CarloRenan/CM5-RP2040-MZM/README.md

# Controlador de polarização MZM com CM5 e RP2040

**Projeto 3**

Placa-base com Raspberry Pi Compute Module 5 e Raspberry Pi Pico para aquisição do sinal de um fotodiodo, geração de três tensões de polarização e supervisão de um modulador Mach–Zehnder (MZM).

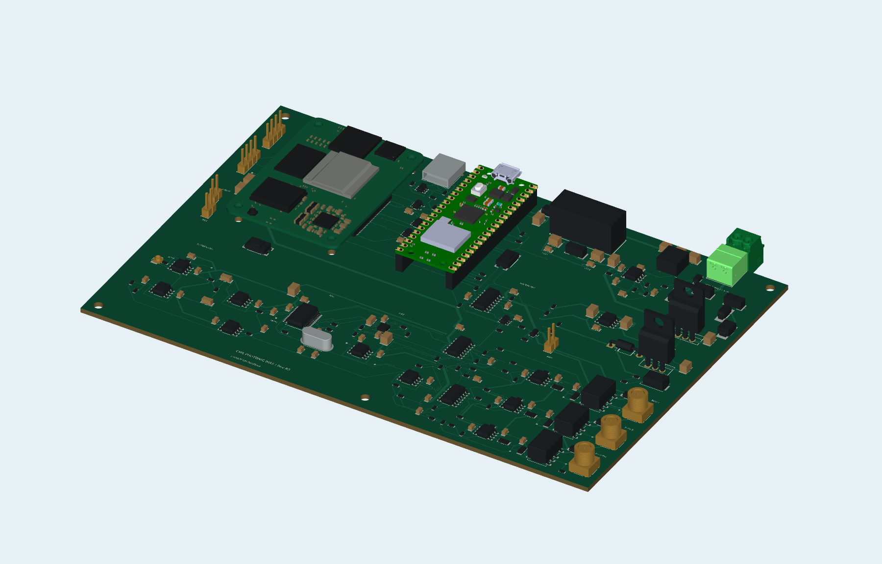
[picture p1: docs/imagens/montagem_3d.png]
Montagem tridimensional da placa CM5 e RP2040


## Documentação

| Documento | Referência para |
| --- | --- |
| [Relatório principal](docs/relatorios/Relatorio_CM5_RP2040_MZM.docx) | Arquitetura, circuitos, cálculos e configurações do sistema |
| [Conexões em 3D](docs/relatorios/Relatorio_Conexoes_3D%20.docx) | Pinagem, acessórios e exemplos de ligação |
| [Ensaios de bancada](docs/relatorios/Ensaios_de_Bancada_CM5_Photonic_Bias.docx) | Procedimentos de teste e verificações do protótipo |
| [Relatório LTspice](docs/relatorios/Relatorio_LTspice_CM5_RP2040_MZM.docx) | Simulações, gráficos e análise dos resultados |
| [Lista de compras](docs/relatorios/Lista_Compras_Prototipo_CM5_RP2040%20.xlsx) | Componentes e acessórios |
| [Vídeo da montagem e da bancada](media/CM5_R6_Trailer_Bancada.mp4) | Visualização do conjunto com MZM |

## Arquivos do projeto

- [Hardware](hardware/altium): projeto Altium, esquemáticos, PCB, biblioteca, BOM e modelos 3D.
- [Simulações](simulacoes): circuitos LTspice, modelos e roteiro dos ensaios.
- [Imagens](docs/imagens): vistas da placa, da montagem e da bancada.

O histórico das revisões está em [CHANGELOG.md](CHANGELOG.md). As fontes e condições dos recursos de terceiros estão em [THIRD_PARTY.md](THIRD_PARTY.md).

## Autores

- Carlos Renan Correia Fidelis
- Carlos Elias Fialho de Lima
- Pablo Daniel Nascimento Vieira

Universidade Federal de Campina Grande · Engenharia Elétrica · 2026.
