CarloRenan/CM5-RP2040-MZM/hardware/altium/Modelos3D_R5/LEIA-ME.txt

J200: STEP extraidos do PCB_Source_IoT, preservados sem alteracoes de conteudo.
O posicionamento de montagem esta incorporado no PcbDoc e na PcbLib.
U220: envelope mecanico simplificado, construido do datasheet TMR 3.

J200 na R6: pino 1 = +15 V; pino 2 = GND.
