CarloRenan/CM5-RP2040-MZM/media/README.md

Arquivos da revisão R6. Consulte o README principal para navegação e instruções.
