CarloRenan/CM5-RP2040-MZM/THIRD_PARTY.md

# Recursos e referências de terceiros

Os modelos mecânicos, macromodelos e bibliotecas preservam suas identificações de origem. A indicação de autoria dos relatórios refere-se ao texto, às análises e às figuras elaboradas no projeto; não transfere a titularidade dos recursos de fabricantes.

| Recurso | Origem |
| --- | --- |
| Modelo STEP detalhado do CM5 | EDATEC, conforme `docs/modelos_referencia/Origem_STEP_CM5.txt` |
| Modelos do Pico e conector externo | Bibliotecas fornecidas para o projeto; identificações preservadas nos arquivos |
| OPA380 e OPA197 | Texas Instruments; condições em `simulacoes/modelos/ORIGEM_E_CONDICOES.txt` |
| Organização da bancada óptica | Lobo, Lucas de Oliveira. TCC, UFCG, 2024. https://dspace.sti.ufcg.edu.br/handle/riufcg/38615 |
| Regras e consultas do Altium | https://www.altium.com/documentation/altium-designer/pcb/query-functions/fields |

As condições de uso dos componentes de terceiros são as de seus respectivos titulares. Este repositório não acrescenta uma licença de redistribuição a esses recursos.
