CarloRenan/CM5-RP2040-MZM/hardware/altium/BOM_PCB_R6.csv

Designator | Quantity | Description | Manufacturer | Manufacturer Part Number | Footprint | Supplier 1 | Supplier Part Number 1 | Supplier URL 1 | Supplier 2 | Supplier Part Number 2 | Supplier URL 2 | Datasheet | Procurement Status | Sheet | Notes
C100 | 1 | 100 nF / 50 V X7R | KEMET | C0805C104K5RACTU | C0805 | DigiKey |  | https://www.digikey.com.br/pt/products/result?keywords=C0805C104K5RACTU | Mouser |  | https://br.mouser.com/c/?q=C0805C104K5RACTU | https://www.yageogroup.com/download/specsheet/C0805C104K5RACTU | Busca por MPN; SKU e disponibilidade a confirmar | CM5_Boot_USB.SchDoc
C1000 | 1 | 1 uF / 25 V X7R | KEMET | C0805C105K3RACTU | C0805 | DigiKey |  | https://www.digikey.com.br/pt/products/result?keywords=C0805C105K3RACTU | Mouser |  | https://br.mouser.com/c/?q=C0805C105K3RACTU | https://www.yageogroup.com/download/specsheet/C0805C105K3RACTU | Busca por MPN; SKU e disponibilidade a confirmar | Safety_Watchdog.SchDoc
C1001 | 1 | 1 uF / 25 V X7R | KEMET | C0805C105K3RACTU | C0805 | DigiKey |  | https://www.digikey.com.br/pt/products/result?keywords=C0805C105K3RACTU | Mouser |  | https://br.mouser.com/c/?q=C0805C105K3RACTU | https://www.yageogroup.com/download/specsheet/C0805C105K3RACTU | Busca por MPN; SKU e disponibilidade a confirmar | Safety_Watchdog.SchDoc
C1002 | 1 | 100 nF / 50 V X7R | KEMET | C0805C104K5RACTU | C0805 | DigiKey |  | https://www.digikey.com.br/pt/products/result?keywords=C0805C104K5RACTU | Mouser |  | https://br.mouser.com/c/?q=C0805C104K5RACTU | https://www.yageogroup.com/download/specsheet/C0805C104K5RACTU | Busca por MPN; SKU e disponibilidade a confirmar | Safety_Watchdog.SchDoc
C1003 | 1 | 100 nF / 50 V X7R | KEMET | C0805C104K5RACTU | C0805 | DigiKey |  | https://www.digikey.com.br/pt/products/result?keywords=C0805C104K5RACTU | Mouser |  | https://br.mouser.com/c/?q=C0805C104K5RACTU | https://www.yageogroup.com/download/specsheet/C0805C104K5RACTU | Busca por MPN; SKU e disponibilidade a confirmar | Safety_Watchdog.SchDoc
C1004 | 1 | 100 nF / 50 V X7R | KEMET | C0805C104K5RACTU | C0805 | DigiKey |  | https://www.digikey.com.br/pt/products/result?keywords=C0805C104K5RACTU | Mouser |  | https://br.mouser.com/c/?q=C0805C104K5RACTU | https://www.yageogroup.com/download/specsheet/C0805C104K5RACTU | Busca por MPN; SKU e disponibilidade a confirmar | Safety_Watchdog.SchDoc
C1005 | 1 | 100 nF / 50 V X7R | KEMET | C0805C104K5RACTU | C0805 | DigiKey |  | https://www.digikey.com.br/pt/products/result?keywords=C0805C104K5RACTU | Mouser |  | https://br.mouser.com/c/?q=C0805C104K5RACTU | https://www.yageogroup.com/download/specsheet/C0805C104K5RACTU | Busca por MPN; SKU e disponibilidade a confirmar | Safety_Watchdog.SchDoc
C110 | 1 | 47 uF / 10 V X7R | Murata | GRM32ER71A476KE15L | C1210 | DigiKey |  | https://www.digikey.com.br/pt/products/result?keywords=GRM32ER71A476KE15L | Mouser |  | https://br.mouser.com/c/?q=GRM32ER71A476KE15L | https://www.murata.com/en-us/products/productdetail?partno=GRM32ER71A476KE15L | Busca por MPN; SKU e disponibilidade a confirmar | CM5_GPIO.SchDoc
C1100 | 1 | 100 nF / 50 V X7R | KEMET | C0805C104K5RACTU | C0805 | DigiKey |  | https://www.digikey.com.br/pt/products/result?keywords=C0805C104K5RACTU | Mouser |  | https://br.mouser.com/c/?q=C0805C104K5RACTU | https://www.yageogroup.com/download/specsheet/C0805C104K5RACTU | Busca por MPN; SKU e disponibilidade a confirmar | Safety_Window.SchDoc
C111 | 1 | 47 uF / 10 V X7R | Murata | GRM32ER71A476KE15L | C1210 | DigiKey |  | https://www.digikey.com.br/pt/products/result?keywords=GRM32ER71A476KE15L | Mouser |  | https://br.mouser.com/c/?q=GRM32ER71A476KE15L | https://www.murata.com/en-us/products/productdetail?partno=GRM32ER71A476KE15L | Busca por MPN; SKU e disponibilidade a confirmar | CM5_GPIO.SchDoc
C1110 | 1 | 1 nF / 50 V C0G | KEMET | C0805C102J5GACTU | C0805 | DigiKey |  | https://www.digikey.com.br/pt/products/result?keywords=C0805C102J5GACTU | Mouser |  | https://br.mouser.com/c/?q=C0805C102J5GACTU | https://www.yageogroup.com/download/specsheet/C0805C102J5GACTU | Busca por MPN; SKU e disponibilidade a confirmar | Safety_Window.SchDoc
C1111 | 1 | 1 nF / 50 V C0G | KEMET | C0805C102J5GACTU | C0805 | DigiKey |  | https://www.digikey.com.br/pt/products/result?keywords=C0805C102J5GACTU | Mouser |  | https://br.mouser.com/c/?q=C0805C102J5GACTU | https://www.yageogroup.com/download/specsheet/C0805C102J5GACTU | Busca por MPN; SKU e disponibilidade a confirmar | Safety_Window.SchDoc
C1112 | 1 | 1 nF / 50 V C0G | KEMET | C0805C102J5GACTU | C0805 | DigiKey |  | https://www.digikey.com.br/pt/products/result?keywords=C0805C102J5GACTU | Mouser |  | https://br.mouser.com/c/?q=C0805C102J5GACTU | https://www.yageogroup.com/download/specsheet/C0805C102J5GACTU | Busca por MPN; SKU e disponibilidade a confirmar | Safety_Window.SchDoc
C112 | 1 | 100 nF / 50 V X7R | KEMET | C0805C104K5RACTU | C0805 | DigiKey |  | https://www.digikey.com.br/pt/products/result?keywords=C0805C104K5RACTU | Mouser |  | https://br.mouser.com/c/?q=C0805C104K5RACTU | https://www.yageogroup.com/download/specsheet/C0805C104K5RACTU | Busca por MPN; SKU e disponibilidade a confirmar | CM5_GPIO.SchDoc
C113 | 1 | 100 nF / 50 V X7R | KEMET | C0805C104K5RACTU | C0805 | DigiKey |  | https://www.digikey.com.br/pt/products/result?keywords=C0805C104K5RACTU | Mouser |  | https://br.mouser.com/c/?q=C0805C104K5RACTU | https://www.yageogroup.com/download/specsheet/C0805C104K5RACTU | Busca por MPN; SKU e disponibilidade a confirmar | CM5_GPIO.SchDoc
C200 | 1 | 10 uF / 50 V X7R | KEMET | C1210C106K5RACTU | C1210 | DigiKey |  | https://www.digikey.com.br/pt/products/result?keywords=C1210C106K5RACTU | Mouser |  | https://br.mouser.com/c/?q=C1210C106K5RACTU | https://www.yageogroup.com/download/specsheet/C1210C106K5RACTU | Busca por MPN; SKU e disponibilidade a confirmar | Power_Input_5V.SchDoc | 10 uF/50 V + C201 de 10 uF substituem a combinacao generica 22+10 uF na entrada; verificar ripple/inrush.
C201 | 1 | 10 uF / 50 V X7R | KEMET | C1210C106K5RACTU | C1210 | DigiKey |  | https://www.digikey.com.br/pt/products/result?keywords=C1210C106K5RACTU | Mouser |  | https://br.mouser.com/c/?q=C1210C106K5RACTU | https://www.yageogroup.com/download/specsheet/C1210C106K5RACTU | Busca por MPN; SKU e disponibilidade a confirmar | Power_Input_5V.SchDoc
C202 | 1 | 100 nF / 50 V X7R | KEMET | C0805C104K5RACTU | C0805 | DigiKey |  | https://www.digikey.com.br/pt/products/result?keywords=C0805C104K5RACTU | Mouser |  | https://br.mouser.com/c/?q=C0805C104K5RACTU | https://www.yageogroup.com/download/specsheet/C0805C104K5RACTU | Busca por MPN; SKU e disponibilidade a confirmar | Power_Input_5V.SchDoc
C203 | 1 | 10 nF / 50 V X7R | KEMET | C0805C103K5RACTU | C0805 | DigiKey |  | https://www.digikey.com.br/pt/products/result?keywords=C0805C103K5RACTU | Mouser |  | https://br.mouser.com/c/?q=C0805C103K5RACTU | https://www.yageogroup.com/download/specsheet/C0805C103K5RACTU | Busca por MPN; SKU e disponibilidade a confirmar | Power_Input_5V.SchDoc
C204 | 1 | 100 nF / 50 V X7R | KEMET | C0805C104K5RACTU | C0805 | DigiKey |  | https://www.digikey.com.br/pt/products/result?keywords=C0805C104K5RACTU | Mouser |  | https://br.mouser.com/c/?q=C0805C104K5RACTU | https://www.yageogroup.com/download/specsheet/C0805C104K5RACTU | Busca por MPN; SKU e disponibilidade a confirmar | Power_Input_5V.SchDoc
C205 | 1 | 22 uF / 25 V X7R | KEMET | C1210C226K3RACTU | C1210 | DigiKey | 399-C1210C226K3RACTUCT-ND | https://www.digikey.com/en/products/detail/kemet/C1210C226K3RACTU/5267618 | Mouser |  | https://br.mouser.com/c/?q=C1210C226K3RACTU | https://www.yageogroup.com/download/specsheet/C1210C226K3RACTU | SKU conferido; consultar disponibilidade | Power_Input_5V.SchDoc | Confirmar curva DC-bias: meta de >=50 uF efetivos no conjunto a 5,1 V; compensacao do buck ainda requer ensaio.
C206 | 1 | 22 uF / 25 V X7R | KEMET | C1210C226K3RACTU | C1210 | DigiKey | 399-C1210C226K3RACTUCT-ND | https://www.digikey.com/en/products/detail/kemet/C1210C226K3RACTU/5267618 | Mouser |  | https://br.mouser.com/c/?q=C1210C226K3RACTU | https://www.yageogroup.com/download/specsheet/C1210C226K3RACTU | SKU conferido; consultar disponibilidade | Power_Input_5V.SchDoc | Confirmar curva DC-bias: meta de >=50 uF efetivos no conjunto a 5,1 V; compensacao do buck ainda requer ensaio.
C207 | 1 | 22 uF / 25 V X7R | KEMET | C1210C226K3RACTU | C1210 | DigiKey | 399-C1210C226K3RACTUCT-ND | https://www.digikey.com/en/products/detail/kemet/C1210C226K3RACTU/5267618 | Mouser |  | https://br.mouser.com/c/?q=C1210C226K3RACTU | https://www.yageogroup.com/download/specsheet/C1210C226K3RACTU | SKU conferido; consultar disponibilidade | Power_Input_5V.SchDoc | Confirmar curva DC-bias: meta de >=50 uF efetivos no conjunto a 5,1 V; compensacao do buck ainda requer ensaio.
C208 | 1 | 2.7 nF / 50 V C0G | KEMET | C0805C272J5GACTU | C0805 | DigiKey |  | https://www.digikey.com.br/pt/products/result?keywords=C0805C272J5GACTU | Mouser |  | https://br.mouser.com/c/?q=C0805C272J5GACTU | https://www.yageogroup.com/download/specsheet/C0805C272J5GACTU | Busca por MPN; SKU e disponibilidade a confirmar | Power_Input_5V.SchDoc
C209 | 1 | 33 pF / 50 V C0G | KEMET | C0805C330J5GACTU | C0805 | DigiKey |  | https://www.digikey.com.br/pt/products/result?keywords=C0805C330J5GACTU | Mouser |  | https://br.mouser.com/c/?q=C0805C330J5GACTU | https://www.yageogroup.com/download/specsheet/C0805C330J5GACTU | Busca por MPN; SKU e disponibilidade a confirmar | Power_Input_5V.SchDoc
C210 | 1 | 10 uF / 50 V X7R | KEMET | C1210C106K5RACTU | C1210 | DigiKey |  | https://www.digikey.com.br/pt/products/result?keywords=C1210C106K5RACTU | Mouser |  | https://br.mouser.com/c/?q=C1210C106K5RACTU | https://www.yageogroup.com/download/specsheet/C1210C106K5RACTU | Busca por MPN; SKU e disponibilidade a confirmar | Power_Analog.SchDoc
C211 | 1 | 10 uF / 50 V X7R | KEMET | C1210C106K5RACTU | C1210 | DigiKey |  | https://www.digikey.com.br/pt/products/result?keywords=C1210C106K5RACTU | Mouser |  | https://br.mouser.com/c/?q=C1210C106K5RACTU | https://www.yageogroup.com/download/specsheet/C1210C106K5RACTU | Busca por MPN; SKU e disponibilidade a confirmar | Power_Analog.SchDoc
C212 | 1 | 10 uF / 50 V X7R | KEMET | C1210C106K5RACTU | C1210 | DigiKey |  | https://www.digikey.com.br/pt/products/result?keywords=C1210C106K5RACTU | Mouser |  | https://br.mouser.com/c/?q=C1210C106K5RACTU | https://www.yageogroup.com/download/specsheet/C1210C106K5RACTU | Busca por MPN; SKU e disponibilidade a confirmar | Power_Analog.SchDoc
C213 | 1 | 10 uF / 35 V tantalum | KEMET | T491D106K035AT | TANT_D | DigiKey |  | https://www.digikey.com.br/pt/products/result?keywords=T491D106K035AT | Mouser |  | https://br.mouser.com/c/?q=T491D106K035AT | https://www.yageogroup.com/download/specsheet/T491D106K035AT | Busca por MPN; SKU e disponibilidade a confirmar | Power_Analog.SchDoc | Tantalo caso D; positivo pad 1 ao GND, negativo pad 2 a -11VA; ESR max 3 ohm.
C214 | 1 | 10 uF / 50 V X7R | KEMET | C1210C106K5RACTU | C1210 | DigiKey |  | https://www.digikey.com.br/pt/products/result?keywords=C1210C106K5RACTU | Mouser |  | https://br.mouser.com/c/?q=C1210C106K5RACTU | https://www.yageogroup.com/download/specsheet/C1210C106K5RACTU | Busca por MPN; SKU e disponibilidade a confirmar | Power_Analog.SchDoc
C215 | 1 | 10 uF / 50 V X7R | KEMET | C1210C106K5RACTU | C1210 | DigiKey |  | https://www.digikey.com.br/pt/products/result?keywords=C1210C106K5RACTU | Mouser |  | https://br.mouser.com/c/?q=C1210C106K5RACTU | https://www.yageogroup.com/download/specsheet/C1210C106K5RACTU | Busca por MPN; SKU e disponibilidade a confirmar | Power_Analog.SchDoc
C216 | 1 | 10 nF / 50 V C0G | KEMET | C0805C103J5GACTU | C0805 | DigiKey |  | https://www.digikey.com.br/pt/products/result?keywords=C0805C103J5GACTU | Mouser |  | https://br.mouser.com/c/?q=C0805C103J5GACTU | https://www.yageogroup.com/download/specsheet/C0805C103J5GACTU | Busca por MPN; SKU e disponibilidade a confirmar | Power_Analog.SchDoc
C300 | 1 | 10 uF / 50 V X7R | KEMET | C1210C106K5RACTU | C1210 | DigiKey |  | https://www.digikey.com.br/pt/products/result?keywords=C1210C106K5RACTU | Mouser |  | https://br.mouser.com/c/?q=C1210C106K5RACTU | https://www.yageogroup.com/download/specsheet/C1210C106K5RACTU | Busca por MPN; SKU e disponibilidade a confirmar | MCU_RP2040.SchDoc
C301 | 1 | 100 nF / 50 V X7R | KEMET | C0805C104K5RACTU | C0805 | DigiKey |  | https://www.digikey.com.br/pt/products/result?keywords=C0805C104K5RACTU | Mouser |  | https://br.mouser.com/c/?q=C0805C104K5RACTU | https://www.yageogroup.com/download/specsheet/C0805C104K5RACTU | Busca por MPN; SKU e disponibilidade a confirmar | MCU_RP2040.SchDoc
C302 | 1 | 100 nF / 50 V X7R | KEMET | C0805C104K5RACTU | C0805 | DigiKey |  | https://www.digikey.com.br/pt/products/result?keywords=C0805C104K5RACTU | Mouser |  | https://br.mouser.com/c/?q=C0805C104K5RACTU | https://www.yageogroup.com/download/specsheet/C0805C104K5RACTU | Busca por MPN; SKU e disponibilidade a confirmar | MCU_RP2040.SchDoc
C400 | 1 | 1 uF / 25 V X7R | KEMET | C0805C105K3RACTU | C0805 | DigiKey |  | https://www.digikey.com.br/pt/products/result?keywords=C0805C105K3RACTU | Mouser |  | https://br.mouser.com/c/?q=C0805C105K3RACTU | https://www.yageogroup.com/download/specsheet/C0805C105K3RACTU | Busca por MPN; SKU e disponibilidade a confirmar | ADC.SchDoc
C401 | 1 | 100 nF / 50 V X7R | KEMET | C0805C104K5RACTU | C0805 | DigiKey |  | https://www.digikey.com.br/pt/products/result?keywords=C0805C104K5RACTU | Mouser |  | https://br.mouser.com/c/?q=C0805C104K5RACTU | https://www.yageogroup.com/download/specsheet/C0805C104K5RACTU | Busca por MPN; SKU e disponibilidade a confirmar | ADC.SchDoc
C402 | 1 | 100 nF / 50 V X7R | KEMET | C0805C104K5RACTU | C0805 | DigiKey |  | https://www.digikey.com.br/pt/products/result?keywords=C0805C104K5RACTU | Mouser |  | https://br.mouser.com/c/?q=C0805C104K5RACTU | https://www.yageogroup.com/download/specsheet/C0805C104K5RACTU | Busca por MPN; SKU e disponibilidade a confirmar | ADC.SchDoc
C403 | 1 | 10 uF / 50 V X7R | KEMET | C1210C106K5RACTU | C1210 | DigiKey |  | https://www.digikey.com.br/pt/products/result?keywords=C1210C106K5RACTU | Mouser |  | https://br.mouser.com/c/?q=C1210C106K5RACTU | https://www.yageogroup.com/download/specsheet/C1210C106K5RACTU | Busca por MPN; SKU e disponibilidade a confirmar | ADC.SchDoc
C404 | 1 | 100 nF / 50 V X7R | KEMET | C0805C104K5RACTU | C0805 | DigiKey |  | https://www.digikey.com.br/pt/products/result?keywords=C0805C104K5RACTU | Mouser |  | https://br.mouser.com/c/?q=C0805C104K5RACTU | https://www.yageogroup.com/download/specsheet/C0805C104K5RACTU | Busca por MPN; SKU e disponibilidade a confirmar | ADC.SchDoc
C405 | 1 | 27 pF / 50 V C0G | KEMET | C0805C270J5GACTU | C0805 | DigiKey |  | https://www.digikey.com.br/pt/products/result?keywords=C0805C270J5GACTU | Mouser |  | https://br.mouser.com/c/?q=C0805C270J5GACTU | https://www.yageogroup.com/download/specsheet/C0805C270J5GACTU | Busca por MPN; SKU e disponibilidade a confirmar | ADC.SchDoc
C406 | 1 | 27 pF / 50 V C0G | KEMET | C0805C270J5GACTU | C0805 | DigiKey |  | https://www.digikey.com.br/pt/products/result?keywords=C0805C270J5GACTU | Mouser |  | https://br.mouser.com/c/?q=C0805C270J5GACTU | https://www.yageogroup.com/download/specsheet/C0805C270J5GACTU | Busca por MPN; SKU e disponibilidade a confirmar | ADC.SchDoc
C407 | 1 | 100 nF / 50 V X7R | KEMET | C0805C104K5RACTU | C0805 | DigiKey |  | https://www.digikey.com.br/pt/products/result?keywords=C0805C104K5RACTU | Mouser |  | https://br.mouser.com/c/?q=C0805C104K5RACTU | https://www.yageogroup.com/download/specsheet/C0805C104K5RACTU | Busca por MPN; SKU e disponibilidade a confirmar | ADC.SchDoc
C500 | 1 | 100 pF / 50 V C0G | KEMET | C0805C101J5GACTU | C0805 | DigiKey |  | https://www.digikey.com.br/pt/products/result?keywords=C0805C101J5GACTU | Mouser |  | https://br.mouser.com/c/?q=C0805C101J5GACTU | https://www.yageogroup.com/download/specsheet/C0805C101J5GACTU | Busca por MPN; SKU e disponibilidade a confirmar | TIA.SchDoc
C501 | 1 | 100 nF / 50 V X7R | KEMET | C0805C104K5RACTU | C0805 | DigiKey |  | https://www.digikey.com.br/pt/products/result?keywords=C0805C104K5RACTU | Mouser |  | https://br.mouser.com/c/?q=C0805C104K5RACTU | https://www.yageogroup.com/download/specsheet/C0805C104K5RACTU | Busca por MPN; SKU e disponibilidade a confirmar | TIA.SchDoc
C502 | 1 | 1 uF / 25 V X7R | KEMET | C0805C105K3RACTU | C0805 | DigiKey |  | https://www.digikey.com.br/pt/products/result?keywords=C0805C105K3RACTU | Mouser |  | https://br.mouser.com/c/?q=C0805C105K3RACTU | https://www.yageogroup.com/download/specsheet/C0805C105K3RACTU | Busca por MPN; SKU e disponibilidade a confirmar | TIA.SchDoc
C503 | 1 | 100 nF / 50 V X7R | KEMET | C0805C104K5RACTU | C0805 | DigiKey |  | https://www.digikey.com.br/pt/products/result?keywords=C0805C104K5RACTU | Mouser |  | https://br.mouser.com/c/?q=C0805C104K5RACTU | https://www.yageogroup.com/download/specsheet/C0805C104K5RACTU | Busca por MPN; SKU e disponibilidade a confirmar | TIA.SchDoc
C504 | 1 | 100 nF / 50 V C0G | KEMET | C1206C104J5GACTU | C1206 | DigiKey |  | https://www.digikey.com.br/pt/products/result?keywords=C1206C104J5GACTU | Mouser |  | https://br.mouser.com/c/?q=C1206C104J5GACTU | https://www.yageogroup.com/download/specsheet/C1206C104J5GACTU | Busca por MPN; SKU e disponibilidade a confirmar | TIA.SchDoc
C505 | 1 | 47 nF / 50 V C0G | KEMET | C1206C473J5GACTU | C1206 | DigiKey |  | https://www.digikey.com.br/pt/products/result?keywords=C1206C473J5GACTU | Mouser |  | https://br.mouser.com/c/?q=C1206C473J5GACTU | https://www.yageogroup.com/download/specsheet/C1206C473J5GACTU | Busca por MPN; SKU e disponibilidade a confirmar | TIA.SchDoc
C506 | 1 | 100 nF / 50 V X7R | KEMET | C0805C104K5RACTU | C0805 | DigiKey |  | https://www.digikey.com.br/pt/products/result?keywords=C0805C104K5RACTU | Mouser |  | https://br.mouser.com/c/?q=C0805C104K5RACTU | https://www.yageogroup.com/download/specsheet/C0805C104K5RACTU | Busca por MPN; SKU e disponibilidade a confirmar | TIA.SchDoc
C507 | 1 | 10 nF / 50 V C0G | KEMET | C0805C103J5GACTU | C0805 | DigiKey |  | https://www.digikey.com.br/pt/products/result?keywords=C0805C103J5GACTU | Mouser |  | https://br.mouser.com/c/?q=C0805C103J5GACTU | https://www.yageogroup.com/download/specsheet/C0805C103J5GACTU | Busca por MPN; SKU e disponibilidade a confirmar | TIA.SchDoc
C600 | 1 | 100 nF / 50 V X7R | KEMET | C0805C104K5RACTU | C0805 | DigiKey |  | https://www.digikey.com.br/pt/products/result?keywords=C0805C104K5RACTU | Mouser |  | https://br.mouser.com/c/?q=C0805C104K5RACTU | https://www.yageogroup.com/download/specsheet/C0805C104K5RACTU | Busca por MPN; SKU e disponibilidade a confirmar | DAC_Reference.SchDoc
C601 | 1 | 10 uF / 50 V X7R | KEMET | C1210C106K5RACTU | C1210 | DigiKey |  | https://www.digikey.com.br/pt/products/result?keywords=C1210C106K5RACTU | Mouser |  | https://br.mouser.com/c/?q=C1210C106K5RACTU | https://www.yageogroup.com/download/specsheet/C1210C106K5RACTU | Busca por MPN; SKU e disponibilidade a confirmar | DAC_Reference.SchDoc
C602 | 1 | 100 nF / 50 V X7R | KEMET | C0805C104K5RACTU | C0805 | DigiKey |  | https://www.digikey.com.br/pt/products/result?keywords=C0805C104K5RACTU | Mouser |  | https://br.mouser.com/c/?q=C0805C104K5RACTU | https://www.yageogroup.com/download/specsheet/C0805C104K5RACTU | Busca por MPN; SKU e disponibilidade a confirmar | DAC_Reference.SchDoc
C603 | 1 | 150 nF / 50 V X7R | KEMET | C1206C154K5RACTU | C1206 | DigiKey |  | https://www.digikey.com.br/pt/products/result?keywords=C1206C154K5RACTU | Mouser |  | https://br.mouser.com/c/?q=C1206C154K5RACTU | https://www.yageogroup.com/download/specsheet/C1206C154K5RACTU | Busca por MPN; SKU e disponibilidade a confirmar | DAC_Reference.SchDoc | X7R no bypass da referencia; nao participa do polo Sallen-Key. Capacitancia nominal 150 nF.
C604 | 1 | 1 uF / 25 V X7R | KEMET | C0805C105K3RACTU | C0805 | DigiKey |  | https://www.digikey.com.br/pt/products/result?keywords=C0805C105K3RACTU | Mouser |  | https://br.mouser.com/c/?q=C0805C105K3RACTU | https://www.yageogroup.com/download/specsheet/C0805C105K3RACTU | Busca por MPN; SKU e disponibilidade a confirmar | DAC_Reference.SchDoc
C605 | 1 | 100 nF / 50 V X7R | KEMET | C0805C104K5RACTU | C0805 | DigiKey |  | https://www.digikey.com.br/pt/products/result?keywords=C0805C104K5RACTU | Mouser |  | https://br.mouser.com/c/?q=C0805C104K5RACTU | https://www.yageogroup.com/download/specsheet/C0805C104K5RACTU | Busca por MPN; SKU e disponibilidade a confirmar | DAC_Reference.SchDoc
C700 | 1 | 1 uF / 25 V X7R | KEMET | C0805C105K3RACTU | C0805 | DigiKey |  | https://www.digikey.com.br/pt/products/result?keywords=C0805C105K3RACTU | Mouser |  | https://br.mouser.com/c/?q=C0805C105K3RACTU | https://www.yageogroup.com/download/specsheet/C0805C105K3RACTU | Busca por MPN; SKU e disponibilidade a confirmar | Bias_I.SchDoc
C701 | 1 | 100 nF / 50 V X7R | KEMET | C0805C104K5RACTU | C0805 | DigiKey |  | https://www.digikey.com.br/pt/products/result?keywords=C0805C104K5RACTU | Mouser |  | https://br.mouser.com/c/?q=C0805C104K5RACTU | https://www.yageogroup.com/download/specsheet/C0805C104K5RACTU | Busca por MPN; SKU e disponibilidade a confirmar | Bias_I.SchDoc
C702 | 1 | 100 nF / 50 V X7R | KEMET | C0805C104K5RACTU | C0805 | DigiKey |  | https://www.digikey.com.br/pt/products/result?keywords=C0805C104K5RACTU | Mouser |  | https://br.mouser.com/c/?q=C0805C104K5RACTU | https://www.yageogroup.com/download/specsheet/C0805C104K5RACTU | Busca por MPN; SKU e disponibilidade a confirmar | Bias_I.SchDoc
C800 | 1 | 1 uF / 25 V X7R | KEMET | C0805C105K3RACTU | C0805 | DigiKey |  | https://www.digikey.com.br/pt/products/result?keywords=C0805C105K3RACTU | Mouser |  | https://br.mouser.com/c/?q=C0805C105K3RACTU | https://www.yageogroup.com/download/specsheet/C0805C105K3RACTU | Busca por MPN; SKU e disponibilidade a confirmar | Bias_Q.SchDoc
C801 | 1 | 100 nF / 50 V X7R | KEMET | C0805C104K5RACTU | C0805 | DigiKey |  | https://www.digikey.com.br/pt/products/result?keywords=C0805C104K5RACTU | Mouser |  | https://br.mouser.com/c/?q=C0805C104K5RACTU | https://www.yageogroup.com/download/specsheet/C0805C104K5RACTU | Busca por MPN; SKU e disponibilidade a confirmar | Bias_Q.SchDoc
C802 | 1 | 100 nF / 50 V X7R | KEMET | C0805C104K5RACTU | C0805 | DigiKey |  | https://www.digikey.com.br/pt/products/result?keywords=C0805C104K5RACTU | Mouser |  | https://br.mouser.com/c/?q=C0805C104K5RACTU | https://www.yageogroup.com/download/specsheet/C0805C104K5RACTU | Busca por MPN; SKU e disponibilidade a confirmar | Bias_Q.SchDoc
C900 | 1 | 1 uF / 25 V X7R | KEMET | C0805C105K3RACTU | C0805 | DigiKey |  | https://www.digikey.com.br/pt/products/result?keywords=C0805C105K3RACTU | Mouser |  | https://br.mouser.com/c/?q=C0805C105K3RACTU | https://www.yageogroup.com/download/specsheet/C0805C105K3RACTU | Busca por MPN; SKU e disponibilidade a confirmar | Bias_PHI.SchDoc
C901 | 1 | 100 nF / 50 V X7R | KEMET | C0805C104K5RACTU | C0805 | DigiKey |  | https://www.digikey.com.br/pt/products/result?keywords=C0805C104K5RACTU | Mouser |  | https://br.mouser.com/c/?q=C0805C104K5RACTU | https://www.yageogroup.com/download/specsheet/C0805C104K5RACTU | Busca por MPN; SKU e disponibilidade a confirmar | Bias_PHI.SchDoc
C902 | 1 | 100 nF / 50 V X7R | KEMET | C0805C104K5RACTU | C0805 | DigiKey |  | https://www.digikey.com.br/pt/products/result?keywords=C0805C104K5RACTU | Mouser |  | https://br.mouser.com/c/?q=C0805C104K5RACTU | https://www.yageogroup.com/download/specsheet/C0805C104K5RACTU | Busca por MPN; SKU e disponibilidade a confirmar | Bias_PHI.SchDoc
D200 | 1 | BZT52C12 / zener 12 V | Diodes Incorporated | BZT52C12-7-F | SOD-123 | DigiKey |  | https://www.digikey.com.br/pt/products/result?keywords=BZT52C12-7-F | Mouser |  | https://br.mouser.com/c/?q=BZT52C12-7-F | https://www.diodes.com/datasheet/download/BZT52C2V4.pdf | Busca por MPN; SKU e disponibilidade a confirmar | Power_Input_5V.SchDoc
D201 | 1 | SMBJ18A / TVS | Diodes Incorporated | SMBJ18A-13-F | DO-214AA | DigiKey |  | https://www.digikey.com.br/pt/products/result?keywords=SMBJ18A-13-F | Mouser |  | https://br.mouser.com/c/?q=SMBJ18A-13-F | https://www.diodes.com/datasheet/download/SMBJ5.0A.pdf | Busca por MPN; SKU e disponibilidade a confirmar | Power_Input_5V.SchDoc
D202 | 1 | B340A / 3 A 40 V | Diodes Incorporated | B340A-13-F | DO-214AC | DigiKey |  | https://www.digikey.com.br/pt/products/result?keywords=B340A-13-F | Mouser |  | https://br.mouser.com/c/?q=B340A-13-F | https://www.diodes.com/datasheet/download/B340A.pdf | Busca por MPN; SKU e disponibilidade a confirmar | Power_Input_5V.SchDoc | Substitui SS34 generico; encapsulamento SMA definido pelo fabricante.
D203 | 1 | SMBJ18A / TVS | Diodes Incorporated | SMBJ18A-13-F | DO-214AA | DigiKey |  | https://www.digikey.com.br/pt/products/result?keywords=SMBJ18A-13-F | Mouser |  | https://br.mouser.com/c/?q=SMBJ18A-13-F | https://www.diodes.com/datasheet/download/SMBJ5.0A.pdf | Busca por MPN; SKU e disponibilidade a confirmar | Power_Input_5V.SchDoc
D210 | 1 | 1N4007 | Vishay | 1N4007-E3/54 | D_DO41_P10 | DigiKey |  | https://www.digikey.com.br/pt/products/result?keywords=1N4007-E3%2F54 | Mouser |  | https://br.mouser.com/c/?q=1N4007-E3%2F54 | https://www.vishay.com/docs/88503/1n4001.pdf | Busca por MPN; SKU e disponibilidade a confirmar | Power_Analog.SchDoc
D211 | 1 | 1N4007 | Vishay | 1N4007-E3/54 | D_DO41_P10 | DigiKey |  | https://www.digikey.com.br/pt/products/result?keywords=1N4007-E3%2F54 | Mouser |  | https://br.mouser.com/c/?q=1N4007-E3%2F54 | https://www.vishay.com/docs/88503/1n4001.pdf | Busca por MPN; SKU e disponibilidade a confirmar | Power_Analog.SchDoc
D300 | 1 | SS14 | Diodes Incorporated | SS14-13-F | DO-214AC | DigiKey |  | https://www.digikey.com.br/pt/products/result?keywords=SS14-13-F | Mouser |  | https://br.mouser.com/c/?q=SS14-13-F | https://www.diodes.com/datasheet/download/SS12.pdf | Busca por MPN; SKU e disponibilidade a confirmar | MCU_RP2040.SchDoc
D700 | 1 | 1N4148W / flyback | Diodes Incorporated | 1N4148W-7-F | SOD-123 | DigiKey |  | https://www.digikey.com.br/pt/products/result?keywords=1N4148W-7-F | Mouser |  | https://br.mouser.com/c/?q=1N4148W-7-F | https://www.diodes.com/datasheet/download/1N4148W.pdf | Busca por MPN; SKU e disponibilidade a confirmar | Bias_I.SchDoc
D800 | 1 | 1N4148W / flyback | Diodes Incorporated | 1N4148W-7-F | SOD-123 | DigiKey |  | https://www.digikey.com.br/pt/products/result?keywords=1N4148W-7-F | Mouser |  | https://br.mouser.com/c/?q=1N4148W-7-F | https://www.diodes.com/datasheet/download/1N4148W.pdf | Busca por MPN; SKU e disponibilidade a confirmar | Bias_Q.SchDoc
D900 | 1 | 1N4148W / flyback | Diodes Incorporated | 1N4148W-7-F | SOD-123 | DigiKey |  | https://www.digikey.com.br/pt/products/result?keywords=1N4148W-7-F | Mouser |  | https://br.mouser.com/c/?q=1N4148W-7-F | https://www.diodes.com/datasheet/download/1N4148W.pdf | Busca por MPN; SKU e disponibilidade a confirmar | Bias_PHI.SchDoc
F200 | 1 | T3 A / 125 V | Littelfuse | 0452003.MRL | FUSE_NANO2 | DigiKey | F2604CT-ND | https://www.digikey.com/en/products/detail/littelfuse-inc/0452003-MRL/700840 | Mouser |  | https://br.mouser.com/c/?q=0452003.MRL | https://www.littelfuse.com/~/media/electronics/datasheets/fuses/littelfuse_fuse_452_454_datasheet.pdf.pdf | SKU conferido; consultar disponibilidade | Power_Input_5V.SchDoc | 3 A lento no lugar do 3,15 A generico. Verificar inrush e coordenacao com fonte de bancada.
F201 | 1 | F250 mA / 125 V | Littelfuse | 0451.250MRL | FUSE_NANO2 | DigiKey | F2572CT-ND | https://www.digikey.com/en/products/detail/littelfuse-inc/0451-250MRL/700810 | Mouser |  | https://br.mouser.com/c/?q=0451.250MRL | https://www.littelfuse.com/~/media/electronics/datasheets/fuses/littelfuse_fuse_451_453_datasheet.pdf.pdf | SKU conferido; consultar disponibilidade | Power_Input_5V.SchDoc | R5: protecao do ramo negativo gerado internamente. Validar pulso de partida e coordenacao com limitacao do conversor.
J100 | 1 | CM5 carrier / 100 vias | Amphenol Communications Solutions | 10164227-1004A1RLF | CM5_BERG100 | DigiKey |  | https://www.digikey.com.br/pt/products/result?keywords=10164227-1004A1RLF | Mouser |  | https://br.mouser.com/c/?q=10164227-1004A1RLF | https://cdn.amphenol-cs.com/media/wysiwyg/files/drawing/10164227.pdf | Busca por MPN; SKU e disponibilidade a confirmar | CM5_GPIO.SchDoc | 100 vias, passo 0,4 mm, empilhamento 4 mm. Pads locais 1..100; J101 corresponde aos pinos globais 101..200.
J101 | 1 | CM5 carrier / 100 vias | Amphenol Communications Solutions | 10164227-1004A1RLF | CM5_BERG100 | DigiKey |  | https://www.digikey.com.br/pt/products/result?keywords=10164227-1004A1RLF | Mouser |  | https://br.mouser.com/c/?q=10164227-1004A1RLF | https://cdn.amphenol-cs.com/media/wysiwyg/files/drawing/10164227.pdf | Busca por MPN; SKU e disponibilidade a confirmar | CM5_HighSpeed.SchDoc | 100 vias, passo 0,4 mm, empilhamento 4 mm. Pads locais 1..100; J101 corresponde aos pinos globais 101..200.
J102 | 1 | USB-C / 12401610E4#2A | Amphenol Communications Solutions | 12401610E4#2A | USB_C_12401610 | DigiKey |  | https://www.digikey.com.br/pt/products/result?keywords=12401610E4%232A | Mouser | 523-12401610E4#2A | https://br.mouser.com/c/?q=12401610E4%232A | https://cdn.amphenol-cs.com/media/wysiwyg/files/drawing/c12401610_c.pdf | Busca por MPN; SKU e disponibilidade a confirmar | CM5_Boot_USB.SchDoc | 24 contatos; SuperSpeed e SBU NC. Somente USB2; os quatro pads da carcaca sao SH.
J103 | 1 | I2C / display opcional | Wurth Elektronik | 61300411121 | HDR_1X04_P254 | DigiKey |  | https://www.digikey.com.br/pt/products/result?keywords=61300411121 | Mouser |  | https://br.mouser.com/c/?q=61300411121 | https://www.we-online.com/components/products/datasheet/61300411121.pdf | Busca por MPN; SKU e disponibilidade a confirmar | CM5_Boot_USB.SchDoc | Header reto 1x4 sem chave. Conferir sequencia de pinos do cabo do fan; nao pressupor conector PC padrao.
J104 | 1 | FAN / 5 V | Wurth Elektronik | 61300411121 | HDR_1X04_P254 | DigiKey |  | https://www.digikey.com.br/pt/products/result?keywords=61300411121 | Mouser |  | https://br.mouser.com/c/?q=61300411121 | https://www.we-online.com/components/products/datasheet/61300411121.pdf | Busca por MPN; SKU e disponibilidade a confirmar | CM5_Boot_USB.SchDoc | Header reto 1x4 sem chave. Conferir sequencia de pinos do cabo do fan; nao pressupor conector PC padrao.
J200 | 1 | BCH-381H-2GN / 5444262 / 2 vias 3,81 mm | Phoenix Contact | 5444262 | 5444262 | DigiKey |  | https://www.digikey.com/en/products/result?keywords=5444262 | Mouser |  | https://br.mouser.com/c/?q=5444262 | https://www.phoenixcontact.com/en-ie/products/pcb-header-bch-381h-2-gn-5444262 | Busca por MPN; SKU e disponibilidade a confirmar | Power_Input_5V.SchDoc | R5: J200.1 = +15 V; J200.2 = GND. Comprar tambem o plug 5447861. Modelo 3D do repositorio representa a familia MC 1,5.
J500 | 1 | U.FL / sinal eletrico | Hirose | U.FL-R-SMT-1(10) | HIROSE_UFL | DigiKey |  | https://www.digikey.com.br/pt/products/result?keywords=U.FL-R-SMT-1%2810%29 | Mouser |  | https://br.mouser.com/c/?q=U.FL-R-SMT-1%2810%29 | https://www.hirose.com/product/series/U.FL | Busca por MPN; SKU e disponibilidade a confirmar | TIA.SchDoc | Centro=1; pads de blindagem=2; conector eletrico do fotodiodo externo.
J700 | 1 | SMA / DC BIAS | Amphenol RF | 132134 | SMA_132134 | DigiKey |  | https://www.digikey.com.br/pt/products/result?keywords=132134 | Mouser |  | https://br.mouser.com/c/?q=132134 | https://www.amphenolrf.com/132134.html | Busca por MPN; SKU e disponibilidade a confirmar | Bias_I.SchDoc
J800 | 1 | SMA / DC BIAS | Amphenol RF | 132134 | SMA_132134 | DigiKey |  | https://www.digikey.com.br/pt/products/result?keywords=132134 | Mouser |  | https://br.mouser.com/c/?q=132134 | https://www.amphenolrf.com/132134.html | Busca por MPN; SKU e disponibilidade a confirmar | Bias_Q.SchDoc
J900 | 1 | SMA / DC BIAS | Amphenol RF | 132134 | SMA_132134 | DigiKey |  | https://www.digikey.com.br/pt/products/result?keywords=132134 | Mouser |  | https://br.mouser.com/c/?q=132134 | https://www.amphenolrf.com/132134.html | Busca por MPN; SKU e disponibilidade a confirmar | Bias_PHI.SchDoc
JP100 | 1 | BOOT / ABERTO | Wurth Elektronik | 61300211121 | HDR_1X02_P254 | DigiKey |  | https://www.digikey.com.br/pt/products/result?keywords=61300211121 | Mouser |  | https://br.mouser.com/c/?q=61300211121 | https://www.we-online.com/components/products/datasheet/61300211121.pdf | Busca por MPN; SKU e disponibilidade a confirmar | CM5_Boot_USB.SchDoc | Header 1x2; shunt removivel listado como acessorio. SW1000 inicia aberto.
JP101 | 1 | KILL / ABERTO | Wurth Elektronik | 61300211121 | HDR_1X02_P254 | DigiKey |  | https://www.digikey.com.br/pt/products/result?keywords=61300211121 | Mouser |  | https://br.mouser.com/c/?q=61300211121 | https://www.we-online.com/components/products/datasheet/61300211121.pdf | Busca por MPN; SKU e disponibilidade a confirmar | CM5_Boot_USB.SchDoc | Header 1x2; shunt removivel listado como acessorio. SW1000 inicia aberto.
K700 | 1 | G6K-2F-Y DC5 | Omron | G6K-2F-Y DC5 | G6K_2F_Y | DigiKey |  | https://www.digikey.com.br/pt/products/result?keywords=G6K-2F-Y%20DC5 | Mouser |  | https://br.mouser.com/c/?q=G6K-2F-Y%20DC5 | https://components.omron.com/us-en/datasheet_pdf/J156-E1.pdf | Busca por MPN; SKU e disponibilidade a confirmar | Bias_I.SchDoc | Bobina 1 positivo e 8 negativo; contato NC1=2, COM1=3, NO1=4.
K800 | 1 | G6K-2F-Y DC5 | Omron | G6K-2F-Y DC5 | G6K_2F_Y | DigiKey |  | https://www.digikey.com.br/pt/products/result?keywords=G6K-2F-Y%20DC5 | Mouser |  | https://br.mouser.com/c/?q=G6K-2F-Y%20DC5 | https://components.omron.com/us-en/datasheet_pdf/J156-E1.pdf | Busca por MPN; SKU e disponibilidade a confirmar | Bias_Q.SchDoc | Bobina 1 positivo e 8 negativo; contato NC1=2, COM1=3, NO1=4.
K900 | 1 | G6K-2F-Y DC5 | Omron | G6K-2F-Y DC5 | G6K_2F_Y | DigiKey |  | https://www.digikey.com.br/pt/products/result?keywords=G6K-2F-Y%20DC5 | Mouser |  | https://br.mouser.com/c/?q=G6K-2F-Y%20DC5 | https://components.omron.com/us-en/datasheet_pdf/J156-E1.pdf | Busca por MPN; SKU e disponibilidade a confirmar | Bias_PHI.SchDoc | Bobina 1 positivo e 8 negativo; contato NC1=2, COM1=3, NO1=4.
L200 | 1 | 3.3 uH / XAL7070-332MEC | Coilcraft | XAL7070-332MEC | XAL7070 | DigiKey |  | https://www.digikey.com.br/pt/products/result?keywords=XAL7070-332MEC | Mouser |  | https://br.mouser.com/c/?q=XAL7070-332MEC | https://www.coilcraft.com/getmedia/1ba55433-bcc8-4838-9b21-382f497e12e0/xal7070.pdf | Busca por MPN; SKU e disponibilidade a confirmar | Power_Input_5V.SchDoc | 3,3 uH +/-20%; DCR max 9,42 mOhm; Isat 19,4 A (queda 30%); verificar compensacao e termica do buck.
Q1000 | 1 | AO3400A | Alpha & Omega Semiconductor | AO3400A | ONSC-SOT-23-3-318-08_V | DigiKey |  | https://www.digikey.com.br/pt/products/result?keywords=AO3400A | Mouser |  | https://br.mouser.com/c/?q=AO3400A | https://www.aosmd.com/sites/default/files/res/datasheets/AO3400A.pdf | Busca por MPN; SKU e disponibilidade a confirmar | Safety_Watchdog.SchDoc
Q200 | 1 | DMP4065S-7 | Diodes Incorporated | DMP4065S-7 | ONSC-SOT-23-3-318-08_V | DigiKey |  | https://www.digikey.com.br/pt/products/result?keywords=DMP4065S-7 | Mouser |  | https://br.mouser.com/c/?q=DMP4065S-7 | https://www.diodes.com/datasheet/download/DMP4065S.pdf | Busca por MPN; SKU e disponibilidade a confirmar | Power_Input_5V.SchDoc
R100 | 1 | 5.1k / 1% | YAGEO | RC0603FR-075K1L | R-0603 | DigiKey |  | https://www.digikey.com.br/pt/products/result?keywords=RC0603FR-075K1L | Mouser |  | https://br.mouser.com/c/?q=RC0603FR-075K1L | https://www.yageo.com/en/Product/Index/rchip | Busca por MPN; SKU e disponibilidade a confirmar | CM5_Boot_USB.SchDoc
R1000 | 1 | 1.00M / 1% | YAGEO | RC0603FR-071ML | R-0603 | DigiKey |  | https://www.digikey.com.br/pt/products/result?keywords=RC0603FR-071ML | Mouser |  | https://br.mouser.com/c/?q=RC0603FR-071ML | https://www.yageo.com/en/Product/Index/rchip | Busca por MPN; SKU e disponibilidade a confirmar | Safety_Watchdog.SchDoc
R1001 | 1 | 1.00M / 1% | YAGEO | RC0603FR-071ML | R-0603 | DigiKey |  | https://www.digikey.com.br/pt/products/result?keywords=RC0603FR-071ML | Mouser |  | https://br.mouser.com/c/?q=RC0603FR-071ML | https://www.yageo.com/en/Product/Index/rchip | Busca por MPN; SKU e disponibilidade a confirmar | Safety_Watchdog.SchDoc
R1002 | 1 | 100R / 1% | YAGEO | RC0603FR-07100RL | R-0603 | DigiKey |  | https://www.digikey.com.br/pt/products/result?keywords=RC0603FR-07100RL | Mouser |  | https://br.mouser.com/c/?q=RC0603FR-07100RL | https://www.yageo.com/en/Product/Index/rchip | Busca por MPN; SKU e disponibilidade a confirmar | Safety_Watchdog.SchDoc
R1003 | 1 | 100k / 1% | YAGEO | RC0603FR-07100KL | R-0603 | DigiKey |  | https://www.digikey.com.br/pt/products/result?keywords=RC0603FR-07100KL | Mouser |  | https://br.mouser.com/c/?q=RC0603FR-07100KL | https://www.yageo.com/en/Product/Index/rchip | Busca por MPN; SKU e disponibilidade a confirmar | Safety_Watchdog.SchDoc
R1004 | 1 | 10k / 1% | YAGEO | RC0603FR-0710KL | R-0603 | DigiKey |  | https://www.digikey.com.br/pt/products/result?keywords=RC0603FR-0710KL | Mouser |  | https://br.mouser.com/c/?q=RC0603FR-0710KL | https://www.yageo.com/en/Product/Index/rchip | Busca por MPN; SKU e disponibilidade a confirmar | Safety_Watchdog.SchDoc
R1005 | 1 | 47k / 1% | YAGEO | RC0603FR-0747KL | R-0603 | DigiKey |  | https://www.digikey.com.br/pt/products/result?keywords=RC0603FR-0747KL | Mouser |  | https://br.mouser.com/c/?q=RC0603FR-0747KL | https://www.yageo.com/en/Product/Index/rchip | Busca por MPN; SKU e disponibilidade a confirmar | Safety_Watchdog.SchDoc
R1006 | 1 | 56.0k / 0.1% | YAGEO | RT0603BRD0756KL | R-0603 | DigiKey |  | https://www.digikey.com.br/pt/products/result?keywords=RT0603BRD0756KL | Mouser |  | https://br.mouser.com/c/?q=RT0603BRD0756KL | https://www.yageo.com/en/Product/Index/rchip | Busca por MPN; SKU e disponibilidade a confirmar | Safety_Watchdog.SchDoc | Filme fino, 0,1%, 25 ppm/K; 0,1 W. Verificar dissipacao em R210/R212 e matching dos drivers.
R1007 | 1 | 10.0k / 0.1% | YAGEO | RT0603BRD0710KL | R-0603 | DigiKey |  | https://www.digikey.com.br/pt/products/result?keywords=RT0603BRD0710KL | Mouser |  | https://br.mouser.com/c/?q=RT0603BRD0710KL | https://www.yageo.com/en/Product/Index/rchip | Busca por MPN; SKU e disponibilidade a confirmar | Safety_Watchdog.SchDoc | Filme fino, 0,1%, 25 ppm/K; 0,1 W. Verificar dissipacao em R210/R212 e matching dos drivers.
R1008 | 1 | 113k / 0.1% | YAGEO | RT0603BRD07113KL | R-0603 | DigiKey |  | https://www.digikey.com.br/pt/products/result?keywords=RT0603BRD07113KL | Mouser |  | https://br.mouser.com/c/?q=RT0603BRD07113KL | https://www.yageo.com/en/Product/Index/rchip | Busca por MPN; SKU e disponibilidade a confirmar | Safety_Watchdog.SchDoc | Filme fino, 0,1%, 25 ppm/K; 0,1 W. Verificar dissipacao em R210/R212 e matching dos drivers.
R1009 | 1 | 10.0k / 0.1% | YAGEO | RT0603BRD0710KL | R-0603 | DigiKey |  | https://www.digikey.com.br/pt/products/result?keywords=RT0603BRD0710KL | Mouser |  | https://br.mouser.com/c/?q=RT0603BRD0710KL | https://www.yageo.com/en/Product/Index/rchip | Busca por MPN; SKU e disponibilidade a confirmar | Safety_Watchdog.SchDoc | Filme fino, 0,1%, 25 ppm/K; 0,1 W. Verificar dissipacao em R210/R212 e matching dos drivers.
R101 | 1 | 5.1k / 1% | YAGEO | RC0603FR-075K1L | R-0603 | DigiKey |  | https://www.digikey.com.br/pt/products/result?keywords=RC0603FR-075K1L | Mouser |  | https://br.mouser.com/c/?q=RC0603FR-075K1L | https://www.yageo.com/en/Product/Index/rchip | Busca por MPN; SKU e disponibilidade a confirmar | CM5_Boot_USB.SchDoc
R1010 | 1 | 47k / 1% | YAGEO | RC0603FR-0747KL | R-0603 | DigiKey |  | https://www.digikey.com.br/pt/products/result?keywords=RC0603FR-0747KL | Mouser |  | https://br.mouser.com/c/?q=RC0603FR-0747KL | https://www.yageo.com/en/Product/Index/rchip | Busca por MPN; SKU e disponibilidade a confirmar | Safety_Watchdog.SchDoc
R1011 | 1 | 1k / 1% | YAGEO | RC0603FR-071KL | R-0603 | DigiKey |  | https://www.digikey.com.br/pt/products/result?keywords=RC0603FR-071KL | Mouser |  | https://br.mouser.com/c/?q=RC0603FR-071KL | https://www.yageo.com/en/Product/Index/rchip | Busca por MPN; SKU e disponibilidade a confirmar | Safety_Watchdog.SchDoc
R102 | 1 | 10k / 1% | YAGEO | RC0603FR-0710KL | R-0603 | DigiKey |  | https://www.digikey.com.br/pt/products/result?keywords=RC0603FR-0710KL | Mouser |  | https://br.mouser.com/c/?q=RC0603FR-0710KL | https://www.yageo.com/en/Product/Index/rchip | Busca por MPN; SKU e disponibilidade a confirmar | CM5_Boot_USB.SchDoc
R103 | 1 | 100k / 1% | YAGEO | RC0603FR-07100KL | R-0603 | DigiKey |  | https://www.digikey.com.br/pt/products/result?keywords=RC0603FR-07100KL | Mouser |  | https://br.mouser.com/c/?q=RC0603FR-07100KL | https://www.yageo.com/en/Product/Index/rchip | Busca por MPN; SKU e disponibilidade a confirmar | CM5_Boot_USB.SchDoc
R1100 | 1 | 11.0k / 0.1% | YAGEO | RT0603BRD0711KL | R-0603 | DigiKey |  | https://www.digikey.com.br/pt/products/result?keywords=RT0603BRD0711KL | Mouser |  | https://br.mouser.com/c/?q=RT0603BRD0711KL | https://www.yageo.com/en/Product/Index/rchip | Busca por MPN; SKU e disponibilidade a confirmar | Safety_Window.SchDoc | Filme fino, 0,1%, 25 ppm/K; 0,1 W. Verificar dissipacao em R210/R212 e matching dos drivers.
R1101 | 1 | 78.7k / 0.1% | YAGEO | RT0603BRD0778K7L | R-0603 | DigiKey |  | https://www.digikey.com.br/pt/products/result?keywords=RT0603BRD0778K7L | Mouser |  | https://br.mouser.com/c/?q=RT0603BRD0778K7L | https://www.yageo.com/en/Product/Index/rchip | Busca por MPN; SKU e disponibilidade a confirmar | Safety_Window.SchDoc | Filme fino, 0,1%, 25 ppm/K; 0,1 W. Verificar dissipacao em R210/R212 e matching dos drivers.
R1102 | 1 | 11.0k / 0.1% | YAGEO | RT0603BRD0711KL | R-0603 | DigiKey |  | https://www.digikey.com.br/pt/products/result?keywords=RT0603BRD0711KL | Mouser |  | https://br.mouser.com/c/?q=RT0603BRD0711KL | https://www.yageo.com/en/Product/Index/rchip | Busca por MPN; SKU e disponibilidade a confirmar | Safety_Window.SchDoc | Filme fino, 0,1%, 25 ppm/K; 0,1 W. Verificar dissipacao em R210/R212 e matching dos drivers.
R1103 | 1 | 10.0k / 0.1% | YAGEO | RT0603BRD0710KL | R-0603 | DigiKey |  | https://www.digikey.com.br/pt/products/result?keywords=RT0603BRD0710KL | Mouser |  | https://br.mouser.com/c/?q=RT0603BRD0710KL | https://www.yageo.com/en/Product/Index/rchip | Busca por MPN; SKU e disponibilidade a confirmar | Safety_Window.SchDoc | Filme fino, 0,1%, 25 ppm/K; 0,1 W. Verificar dissipacao em R210/R212 e matching dos drivers.
R1104 | 1 | 15.0k / 0.1% | YAGEO | RT0603BRD0715KL | R-0603 | DigiKey |  | https://www.digikey.com.br/pt/products/result?keywords=RT0603BRD0715KL | Mouser |  | https://br.mouser.com/c/?q=RT0603BRD0715KL | https://www.yageo.com/en/Product/Index/rchip | Busca por MPN; SKU e disponibilidade a confirmar | Safety_Window.SchDoc | Filme fino, 0,1%, 25 ppm/K; 0,1 W. Verificar dissipacao em R210/R212 e matching dos drivers.
R1110 | 1 | 80.6k / 0.1% | YAGEO | RT0603BRD0780K6L | R-0603 | DigiKey |  | https://www.digikey.com.br/pt/products/result?keywords=RT0603BRD0780K6L | Mouser |  | https://br.mouser.com/c/?q=RT0603BRD0780K6L | https://www.yageo.com/en/Product/Index/rchip | Busca por MPN; SKU e disponibilidade a confirmar | Safety_Window.SchDoc | Filme fino, 0,1%, 25 ppm/K; 0,1 W. Verificar dissipacao em R210/R212 e matching dos drivers.
R1111 | 1 | 20.0k / 0.1% | YAGEO | RT0603BRD0720KL | R-0603 | DigiKey |  | https://www.digikey.com.br/pt/products/result?keywords=RT0603BRD0720KL | Mouser |  | https://br.mouser.com/c/?q=RT0603BRD0720KL | https://www.yageo.com/en/Product/Index/rchip | Busca por MPN; SKU e disponibilidade a confirmar | Safety_Window.SchDoc | Filme fino, 0,1%, 25 ppm/K; 0,1 W. Verificar dissipacao em R210/R212 e matching dos drivers.
R1112 | 1 | 26.7k / 0.1% | YAGEO | RT0603BRD0726K7L | R-0603 | DigiKey |  | https://www.digikey.com.br/pt/products/result?keywords=RT0603BRD0726K7L | Mouser |  | https://br.mouser.com/c/?q=RT0603BRD0726K7L | https://www.yageo.com/en/Product/Index/rchip | Busca por MPN; SKU e disponibilidade a confirmar | Safety_Window.SchDoc | Filme fino, 0,1%, 25 ppm/K; 0,1 W. Verificar dissipacao em R210/R212 e matching dos drivers.
R1114 | 1 | 80.6k / 0.1% | YAGEO | RT0603BRD0780K6L | R-0603 | DigiKey |  | https://www.digikey.com.br/pt/products/result?keywords=RT0603BRD0780K6L | Mouser |  | https://br.mouser.com/c/?q=RT0603BRD0780K6L | https://www.yageo.com/en/Product/Index/rchip | Busca por MPN; SKU e disponibilidade a confirmar | Safety_Window.SchDoc | Filme fino, 0,1%, 25 ppm/K; 0,1 W. Verificar dissipacao em R210/R212 e matching dos drivers.
R1115 | 1 | 20.0k / 0.1% | YAGEO | RT0603BRD0720KL | R-0603 | DigiKey |  | https://www.digikey.com.br/pt/products/result?keywords=RT0603BRD0720KL | Mouser |  | https://br.mouser.com/c/?q=RT0603BRD0720KL | https://www.yageo.com/en/Product/Index/rchip | Busca por MPN; SKU e disponibilidade a confirmar | Safety_Window.SchDoc | Filme fino, 0,1%, 25 ppm/K; 0,1 W. Verificar dissipacao em R210/R212 e matching dos drivers.
R1116 | 1 | 26.7k / 0.1% | YAGEO | RT0603BRD0726K7L | R-0603 | DigiKey |  | https://www.digikey.com.br/pt/products/result?keywords=RT0603BRD0726K7L | Mouser |  | https://br.mouser.com/c/?q=RT0603BRD0726K7L | https://www.yageo.com/en/Product/Index/rchip | Busca por MPN; SKU e disponibilidade a confirmar | Safety_Window.SchDoc | Filme fino, 0,1%, 25 ppm/K; 0,1 W. Verificar dissipacao em R210/R212 e matching dos drivers.
R1118 | 1 | 80.6k / 0.1% | YAGEO | RT0603BRD0780K6L | R-0603 | DigiKey |  | https://www.digikey.com.br/pt/products/result?keywords=RT0603BRD0780K6L | Mouser |  | https://br.mouser.com/c/?q=RT0603BRD0780K6L | https://www.yageo.com/en/Product/Index/rchip | Busca por MPN; SKU e disponibilidade a confirmar | Safety_Window.SchDoc | Filme fino, 0,1%, 25 ppm/K; 0,1 W. Verificar dissipacao em R210/R212 e matching dos drivers.
R1119 | 1 | 20.0k / 0.1% | YAGEO | RT0603BRD0720KL | R-0603 | DigiKey |  | https://www.digikey.com.br/pt/products/result?keywords=RT0603BRD0720KL | Mouser |  | https://br.mouser.com/c/?q=RT0603BRD0720KL | https://www.yageo.com/en/Product/Index/rchip | Busca por MPN; SKU e disponibilidade a confirmar | Safety_Window.SchDoc | Filme fino, 0,1%, 25 ppm/K; 0,1 W. Verificar dissipacao em R210/R212 e matching dos drivers.
R1120 | 1 | 26.7k / 0.1% | YAGEO | RT0603BRD0726K7L | R-0603 | DigiKey |  | https://www.digikey.com.br/pt/products/result?keywords=RT0603BRD0726K7L | Mouser |  | https://br.mouser.com/c/?q=RT0603BRD0726K7L | https://www.yageo.com/en/Product/Index/rchip | Busca por MPN; SKU e disponibilidade a confirmar | Safety_Window.SchDoc | Filme fino, 0,1%, 25 ppm/K; 0,1 W. Verificar dissipacao em R210/R212 e matching dos drivers.
R200 | 1 | 100k / 1% | YAGEO | RC0603FR-07100KL | R-0603 | DigiKey |  | https://www.digikey.com.br/pt/products/result?keywords=RC0603FR-07100KL | Mouser |  | https://br.mouser.com/c/?q=RC0603FR-07100KL | https://www.yageo.com/en/Product/Index/rchip | Busca por MPN; SKU e disponibilidade a confirmar | Power_Input_5V.SchDoc
R201 | 1 | 100k / 1% | YAGEO | RC0603FR-07100KL | R-0603 | DigiKey |  | https://www.digikey.com.br/pt/products/result?keywords=RC0603FR-07100KL | Mouser |  | https://br.mouser.com/c/?q=RC0603FR-07100KL | https://www.yageo.com/en/Product/Index/rchip | Busca por MPN; SKU e disponibilidade a confirmar | Power_Input_5V.SchDoc
R202 | 1 | 118k / 0.1% | YAGEO | RT0603BRD07118KL | R-0603 | DigiKey |  | https://www.digikey.com.br/pt/products/result?keywords=RT0603BRD07118KL | Mouser |  | https://br.mouser.com/c/?q=RT0603BRD07118KL | https://www.yageo.com/en/Product/Index/rchip | Busca por MPN; SKU e disponibilidade a confirmar | Power_Input_5V.SchDoc | Filme fino, 0,1%, 25 ppm/K; 0,1 W. Verificar dissipacao em R210/R212 e matching dos drivers.
R203 | 1 | 22.1k / 0.1% | YAGEO | RT0603BRD0722K1L | R-0603 | DigiKey |  | https://www.digikey.com.br/pt/products/result?keywords=RT0603BRD0722K1L | Mouser |  | https://br.mouser.com/c/?q=RT0603BRD0722K1L | https://www.yageo.com/en/Product/Index/rchip | Busca por MPN; SKU e disponibilidade a confirmar | Power_Input_5V.SchDoc | Filme fino, 0,1%, 25 ppm/K; 0,1 W. Verificar dissipacao em R210/R212 e matching dos drivers.
R204 | 1 | 15.8k / 1% | YAGEO | RC0603FR-0715K8L | R-0603 | DigiKey |  | https://www.digikey.com.br/pt/products/result?keywords=RC0603FR-0715K8L | Mouser |  | https://br.mouser.com/c/?q=RC0603FR-0715K8L | https://www.yageo.com/en/Product/Index/rchip | Busca por MPN; SKU e disponibilidade a confirmar | Power_Input_5V.SchDoc
R210 | 1 | 120R / 0.1% | YAGEO | RT0603BRD07120RL | R-0603 | DigiKey |  | https://www.digikey.com.br/pt/products/result?keywords=RT0603BRD07120RL | Mouser |  | https://br.mouser.com/c/?q=RT0603BRD07120RL | https://www.yageo.com/en/Product/Index/rchip | Busca por MPN; SKU e disponibilidade a confirmar | Power_Analog.SchDoc | Filme fino, 0,1%, 25 ppm/K; 0,1 W. Verificar dissipacao em R210/R212 e matching dos drivers.
R211 | 1 | 931R / 0.1% | YAGEO | RT0603BRD07931RL | R-0603 | DigiKey |  | https://www.digikey.com.br/pt/products/result?keywords=RT0603BRD07931RL | Mouser |  | https://br.mouser.com/c/?q=RT0603BRD07931RL | https://www.yageo.com/en/Product/Index/rchip | Busca por MPN; SKU e disponibilidade a confirmar | Power_Analog.SchDoc | Filme fino, 0,1%, 25 ppm/K; 0,1 W. Verificar dissipacao em R210/R212 e matching dos drivers.
R212 | 1 | 120R / 0.1% | YAGEO | RT0603BRD07120RL | R-0603 | DigiKey |  | https://www.digikey.com.br/pt/products/result?keywords=RT0603BRD07120RL | Mouser |  | https://br.mouser.com/c/?q=RT0603BRD07120RL | https://www.yageo.com/en/Product/Index/rchip | Busca por MPN; SKU e disponibilidade a confirmar | Power_Analog.SchDoc | Filme fino, 0,1%, 25 ppm/K; 0,1 W. Verificar dissipacao em R210/R212 e matching dos drivers.
R213 | 1 | 931R / 0.1% | YAGEO | RT0603BRD07931RL | R-0603 | DigiKey |  | https://www.digikey.com.br/pt/products/result?keywords=RT0603BRD07931RL | Mouser |  | https://br.mouser.com/c/?q=RT0603BRD07931RL | https://www.yageo.com/en/Product/Index/rchip | Busca por MPN; SKU e disponibilidade a confirmar | Power_Analog.SchDoc | Filme fino, 0,1%, 25 ppm/K; 0,1 W. Verificar dissipacao em R210/R212 e matching dos drivers.
R300 | 1 | 33R / 1% | YAGEO | RC0603FR-0733RL | R-0603 | DigiKey |  | https://www.digikey.com.br/pt/products/result?keywords=RC0603FR-0733RL | Mouser |  | https://br.mouser.com/c/?q=RC0603FR-0733RL | https://www.yageo.com/en/Product/Index/rchip | Busca por MPN; SKU e disponibilidade a confirmar | MCU_RP2040.SchDoc
R301 | 1 | 33R / 1% | YAGEO | RC0603FR-0733RL | R-0603 | DigiKey |  | https://www.digikey.com.br/pt/products/result?keywords=RC0603FR-0733RL | Mouser |  | https://br.mouser.com/c/?q=RC0603FR-0733RL | https://www.yageo.com/en/Product/Index/rchip | Busca por MPN; SKU e disponibilidade a confirmar | MCU_RP2040.SchDoc
R302 | 1 | 47k / 1% | YAGEO | RC0603FR-0747KL | R-0603 | DigiKey |  | https://www.digikey.com.br/pt/products/result?keywords=RC0603FR-0747KL | Mouser |  | https://br.mouser.com/c/?q=RC0603FR-0747KL | https://www.yageo.com/en/Product/Index/rchip | Busca por MPN; SKU e disponibilidade a confirmar | MCU_RP2040.SchDoc
R400 | 1 | 0R / jumper | YAGEO | RC0603JR-070RL | R-0603 | DigiKey |  | https://www.digikey.com.br/pt/products/result?keywords=RC0603JR-070RL | Mouser |  | https://br.mouser.com/c/?q=RC0603JR-070RL | https://www.yageo.com/en/Product/Index/rchip | Busca por MPN; SKU e disponibilidade a confirmar | ADC.SchDoc
R401 | 1 | 10k / 1% | YAGEO | RC0603FR-0710KL | R-0603 | DigiKey |  | https://www.digikey.com.br/pt/products/result?keywords=RC0603FR-0710KL | Mouser |  | https://br.mouser.com/c/?q=RC0603FR-0710KL | https://www.yageo.com/en/Product/Index/rchip | Busca por MPN; SKU e disponibilidade a confirmar | ADC.SchDoc
R402 | 1 | 10k / 1% | YAGEO | RC0603FR-0710KL | R-0603 | DigiKey |  | https://www.digikey.com.br/pt/products/result?keywords=RC0603FR-0710KL | Mouser |  | https://br.mouser.com/c/?q=RC0603FR-0710KL | https://www.yageo.com/en/Product/Index/rchip | Busca por MPN; SKU e disponibilidade a confirmar | ADC.SchDoc
R403 | 1 | 10k / 1% | YAGEO | RC0603FR-0710KL | R-0603 | DigiKey |  | https://www.digikey.com.br/pt/products/result?keywords=RC0603FR-0710KL | Mouser |  | https://br.mouser.com/c/?q=RC0603FR-0710KL | https://www.yageo.com/en/Product/Index/rchip | Busca por MPN; SKU e disponibilidade a confirmar | ADC.SchDoc
R500 | 1 | 220k / 0.1% | YAGEO | RT0603BRD07220KL | R-0603 | DigiKey |  | https://www.digikey.com.br/pt/products/result?keywords=RT0603BRD07220KL | Mouser |  | https://br.mouser.com/c/?q=RT0603BRD07220KL | https://www.yageo.com/en/Product/Index/rchip | Busca por MPN; SKU e disponibilidade a confirmar | TIA.SchDoc | Filme fino, 0,1%, 25 ppm/K; 0,1 W. Verificar dissipacao em R210/R212 e matching dos drivers.
R501 | 1 | 90.9k / 0.1% | YAGEO | RT0603BRD0790K9L | R-0603 | DigiKey | YAG1747CT-ND | https://www.digikey.com.br/en/products/detail/yageo/RT0603BRD0790K9L/1072677 | Mouser |  | https://br.mouser.com/c/?q=RT0603BRD0790K9L | https://www.yageo.com/en/Product/Index/rchip | SKU conferido; consultar disponibilidade | TIA.SchDoc | Filme fino, 0,1%, 25 ppm/K; 0,1 W. Verificar dissipacao em R210/R212 e matching dos drivers.
R502 | 1 | 10.0k / 0.1% | YAGEO | RT0603BRD0710KL | R-0603 | DigiKey |  | https://www.digikey.com.br/pt/products/result?keywords=RT0603BRD0710KL | Mouser |  | https://br.mouser.com/c/?q=RT0603BRD0710KL | https://www.yageo.com/en/Product/Index/rchip | Busca por MPN; SKU e disponibilidade a confirmar | TIA.SchDoc | Filme fino, 0,1%, 25 ppm/K; 0,1 W. Verificar dissipacao em R210/R212 e matching dos drivers.
R503 | 1 | 10.0k / 1% | YAGEO | RC0603FR-0710KL | R-0603 | DigiKey |  | https://www.digikey.com.br/pt/products/result?keywords=RC0603FR-0710KL | Mouser |  | https://br.mouser.com/c/?q=RC0603FR-0710KL | https://www.yageo.com/en/Product/Index/rchip | Busca por MPN; SKU e disponibilidade a confirmar | TIA.SchDoc
R504 | 1 | 10.0k / 1% | YAGEO | RC0603FR-0710KL | R-0603 | DigiKey |  | https://www.digikey.com.br/pt/products/result?keywords=RC0603FR-0710KL | Mouser |  | https://br.mouser.com/c/?q=RC0603FR-0710KL | https://www.yageo.com/en/Product/Index/rchip | Busca por MPN; SKU e disponibilidade a confirmar | TIA.SchDoc
R505 | 1 | 100R / 1% | YAGEO | RC0603FR-07100RL | R-0603 | DigiKey |  | https://www.digikey.com.br/pt/products/result?keywords=RC0603FR-07100RL | Mouser |  | https://br.mouser.com/c/?q=RC0603FR-07100RL | https://www.yageo.com/en/Product/Index/rchip | Busca por MPN; SKU e disponibilidade a confirmar | TIA.SchDoc
R506 | 1 | 10k / 1% / 0.1 W | YAGEO | RC0603FR-0710KL | R-0603 | DigiKey |  | https://www.digikey.com.br/pt/products/result?keywords=RC0603FR-0710KL | Mouser |  | https://br.mouser.com/c/?q=RC0603FR-0710KL | https://www.yageo.com/en/Product/Index/rchip | Busca por MPN; SKU e disponibilidade a confirmar | TIA.SchDoc | R4: limitacao de corrente entre J500 (PD_RAW) e entrada inversora PD_K. Footprint da biblioteca enviada.
R600 | 1 | 10k / 1% | YAGEO | RC0603FR-0710KL | R-0603 | DigiKey |  | https://www.digikey.com.br/pt/products/result?keywords=RC0603FR-0710KL | Mouser |  | https://br.mouser.com/c/?q=RC0603FR-0710KL | https://www.yageo.com/en/Product/Index/rchip | Busca por MPN; SKU e disponibilidade a confirmar | DAC_Reference.SchDoc
R601 | 1 | 10k / 1% | YAGEO | RC0603FR-0710KL | R-0603 | DigiKey |  | https://www.digikey.com.br/pt/products/result?keywords=RC0603FR-0710KL | Mouser |  | https://br.mouser.com/c/?q=RC0603FR-0710KL | https://www.yageo.com/en/Product/Index/rchip | Busca por MPN; SKU e disponibilidade a confirmar | DAC_Reference.SchDoc
R602 | 1 | 10.0k / 0.1% | YAGEO | RT0603BRD0710KL | R-0603 | DigiKey |  | https://www.digikey.com.br/pt/products/result?keywords=RT0603BRD0710KL | Mouser |  | https://br.mouser.com/c/?q=RT0603BRD0710KL | https://www.yageo.com/en/Product/Index/rchip | Busca por MPN; SKU e disponibilidade a confirmar | DAC_Reference.SchDoc | Filme fino, 0,1%, 25 ppm/K; 0,1 W. Verificar dissipacao em R210/R212 e matching dos drivers.
R603 | 1 | 10.0k / 0.1% | YAGEO | RT0603BRD0710KL | R-0603 | DigiKey |  | https://www.digikey.com.br/pt/products/result?keywords=RT0603BRD0710KL | Mouser |  | https://br.mouser.com/c/?q=RT0603BRD0710KL | https://www.yageo.com/en/Product/Index/rchip | Busca por MPN; SKU e disponibilidade a confirmar | DAC_Reference.SchDoc | Filme fino, 0,1%, 25 ppm/K; 0,1 W. Verificar dissipacao em R210/R212 e matching dos drivers.
R700 | 1 | 10.0k / 0.1% | YAGEO | RT0603BRD0710KL | R-0603 | DigiKey |  | https://www.digikey.com.br/pt/products/result?keywords=RT0603BRD0710KL | Mouser |  | https://br.mouser.com/c/?q=RT0603BRD0710KL | https://www.yageo.com/en/Product/Index/rchip | Busca por MPN; SKU e disponibilidade a confirmar | Bias_I.SchDoc | Filme fino, 0,1%, 25 ppm/K; 0,1 W. Verificar dissipacao em R210/R212 e matching dos drivers.
R701 | 1 | 63.4k / 0.1% | YAGEO | RT0603BRD0763K4L | R-0603 | DigiKey |  | https://www.digikey.com.br/pt/products/result?keywords=RT0603BRD0763K4L | Mouser |  | https://br.mouser.com/c/?q=RT0603BRD0763K4L | https://www.yageo.com/en/Product/Index/rchip | Busca por MPN; SKU e disponibilidade a confirmar | Bias_I.SchDoc | Filme fino, 0,1%, 25 ppm/K; 0,1 W. Verificar dissipacao em R210/R212 e matching dos drivers.
R702 | 1 | 10.0k / 0.1% | YAGEO | RT0603BRD0710KL | R-0603 | DigiKey |  | https://www.digikey.com.br/pt/products/result?keywords=RT0603BRD0710KL | Mouser |  | https://br.mouser.com/c/?q=RT0603BRD0710KL | https://www.yageo.com/en/Product/Index/rchip | Busca por MPN; SKU e disponibilidade a confirmar | Bias_I.SchDoc | Filme fino, 0,1%, 25 ppm/K; 0,1 W. Verificar dissipacao em R210/R212 e matching dos drivers.
R703 | 1 | 63.4k / 0.1% | YAGEO | RT0603BRD0763K4L | R-0603 | DigiKey |  | https://www.digikey.com.br/pt/products/result?keywords=RT0603BRD0763K4L | Mouser |  | https://br.mouser.com/c/?q=RT0603BRD0763K4L | https://www.yageo.com/en/Product/Index/rchip | Busca por MPN; SKU e disponibilidade a confirmar | Bias_I.SchDoc | Filme fino, 0,1%, 25 ppm/K; 0,1 W. Verificar dissipacao em R210/R212 e matching dos drivers.
R704 | 1 | 220R / 1% / 0.667 W | Panasonic Industry | ERJ-P08F2200V | R1206 | DigiKey | 10-ERJ-P08F2200VCT-ND | https://www.digikey.com/en/products/detail/panasonic-industry/ERJ-P08F2200V/9812789 | Mouser |  | https://br.mouser.com/c/?q=ERJ-P08F2200V | https://industrial.panasonic.com/cdbs/www-data/pdf/RDA0000/AOA0000C304.pdf | SKU conferido; consultar disponibilidade | Bias_I.SchDoc
R705 | 1 | 1k / 1% / 0.25 W | YAGEO | RC1206FR-071KL | R1206 | DigiKey |  | https://www.digikey.com.br/pt/products/result?keywords=RC1206FR-071KL | Mouser |  | https://br.mouser.com/c/?q=RC1206FR-071KL | https://www.yageo.com/en/Product/Index/rchip | Busca por MPN; SKU e disponibilidade a confirmar | Bias_I.SchDoc
R706 | 1 | 1M / 1% | YAGEO | RC0603FR-071ML | R-0603 | DigiKey |  | https://www.digikey.com.br/pt/products/result?keywords=RC0603FR-071ML | Mouser |  | https://br.mouser.com/c/?q=RC0603FR-071ML | https://www.yageo.com/en/Product/Index/rchip | Busca por MPN; SKU e disponibilidade a confirmar | Bias_I.SchDoc
R800 | 1 | 10.0k / 0.1% | YAGEO | RT0603BRD0710KL | R-0603 | DigiKey |  | https://www.digikey.com.br/pt/products/result?keywords=RT0603BRD0710KL | Mouser |  | https://br.mouser.com/c/?q=RT0603BRD0710KL | https://www.yageo.com/en/Product/Index/rchip | Busca por MPN; SKU e disponibilidade a confirmar | Bias_Q.SchDoc | Filme fino, 0,1%, 25 ppm/K; 0,1 W. Verificar dissipacao em R210/R212 e matching dos drivers.
R801 | 1 | 63.4k / 0.1% | YAGEO | RT0603BRD0763K4L | R-0603 | DigiKey |  | https://www.digikey.com.br/pt/products/result?keywords=RT0603BRD0763K4L | Mouser |  | https://br.mouser.com/c/?q=RT0603BRD0763K4L | https://www.yageo.com/en/Product/Index/rchip | Busca por MPN; SKU e disponibilidade a confirmar | Bias_Q.SchDoc | Filme fino, 0,1%, 25 ppm/K; 0,1 W. Verificar dissipacao em R210/R212 e matching dos drivers.
R802 | 1 | 10.0k / 0.1% | YAGEO | RT0603BRD0710KL | R-0603 | DigiKey |  | https://www.digikey.com.br/pt/products/result?keywords=RT0603BRD0710KL | Mouser |  | https://br.mouser.com/c/?q=RT0603BRD0710KL | https://www.yageo.com/en/Product/Index/rchip | Busca por MPN; SKU e disponibilidade a confirmar | Bias_Q.SchDoc | Filme fino, 0,1%, 25 ppm/K; 0,1 W. Verificar dissipacao em R210/R212 e matching dos drivers.
R803 | 1 | 63.4k / 0.1% | YAGEO | RT0603BRD0763K4L | R-0603 | DigiKey |  | https://www.digikey.com.br/pt/products/result?keywords=RT0603BRD0763K4L | Mouser |  | https://br.mouser.com/c/?q=RT0603BRD0763K4L | https://www.yageo.com/en/Product/Index/rchip | Busca por MPN; SKU e disponibilidade a confirmar | Bias_Q.SchDoc | Filme fino, 0,1%, 25 ppm/K; 0,1 W. Verificar dissipacao em R210/R212 e matching dos drivers.
R804 | 1 | 220R / 1% / 0.667 W | Panasonic Industry | ERJ-P08F2200V | R1206 | DigiKey | 10-ERJ-P08F2200VCT-ND | https://www.digikey.com/en/products/detail/panasonic-industry/ERJ-P08F2200V/9812789 | Mouser |  | https://br.mouser.com/c/?q=ERJ-P08F2200V | https://industrial.panasonic.com/cdbs/www-data/pdf/RDA0000/AOA0000C304.pdf | SKU conferido; consultar disponibilidade | Bias_Q.SchDoc
R805 | 1 | 1k / 1% / 0.25 W | YAGEO | RC1206FR-071KL | R1206 | DigiKey |  | https://www.digikey.com.br/pt/products/result?keywords=RC1206FR-071KL | Mouser |  | https://br.mouser.com/c/?q=RC1206FR-071KL | https://www.yageo.com/en/Product/Index/rchip | Busca por MPN; SKU e disponibilidade a confirmar | Bias_Q.SchDoc
R806 | 1 | 1M / 1% | YAGEO | RC0603FR-071ML | R-0603 | DigiKey |  | https://www.digikey.com.br/pt/products/result?keywords=RC0603FR-071ML | Mouser |  | https://br.mouser.com/c/?q=RC0603FR-071ML | https://www.yageo.com/en/Product/Index/rchip | Busca por MPN; SKU e disponibilidade a confirmar | Bias_Q.SchDoc
R900 | 1 | 10.0k / 0.1% | YAGEO | RT0603BRD0710KL | R-0603 | DigiKey |  | https://www.digikey.com.br/pt/products/result?keywords=RT0603BRD0710KL | Mouser |  | https://br.mouser.com/c/?q=RT0603BRD0710KL | https://www.yageo.com/en/Product/Index/rchip | Busca por MPN; SKU e disponibilidade a confirmar | Bias_PHI.SchDoc | Filme fino, 0,1%, 25 ppm/K; 0,1 W. Verificar dissipacao em R210/R212 e matching dos drivers.
R901 | 1 | 63.4k / 0.1% | YAGEO | RT0603BRD0763K4L | R-0603 | DigiKey |  | https://www.digikey.com.br/pt/products/result?keywords=RT0603BRD0763K4L | Mouser |  | https://br.mouser.com/c/?q=RT0603BRD0763K4L | https://www.yageo.com/en/Product/Index/rchip | Busca por MPN; SKU e disponibilidade a confirmar | Bias_PHI.SchDoc | Filme fino, 0,1%, 25 ppm/K; 0,1 W. Verificar dissipacao em R210/R212 e matching dos drivers.
R902 | 1 | 10.0k / 0.1% | YAGEO | RT0603BRD0710KL | R-0603 | DigiKey |  | https://www.digikey.com.br/pt/products/result?keywords=RT0603BRD0710KL | Mouser |  | https://br.mouser.com/c/?q=RT0603BRD0710KL | https://www.yageo.com/en/Product/Index/rchip | Busca por MPN; SKU e disponibilidade a confirmar | Bias_PHI.SchDoc | Filme fino, 0,1%, 25 ppm/K; 0,1 W. Verificar dissipacao em R210/R212 e matching dos drivers.
R903 | 1 | 63.4k / 0.1% | YAGEO | RT0603BRD0763K4L | R-0603 | DigiKey |  | https://www.digikey.com.br/pt/products/result?keywords=RT0603BRD0763K4L | Mouser |  | https://br.mouser.com/c/?q=RT0603BRD0763K4L | https://www.yageo.com/en/Product/Index/rchip | Busca por MPN; SKU e disponibilidade a confirmar | Bias_PHI.SchDoc | Filme fino, 0,1%, 25 ppm/K; 0,1 W. Verificar dissipacao em R210/R212 e matching dos drivers.
R904 | 1 | 220R / 1% / 0.667 W | Panasonic Industry | ERJ-P08F2200V | R1206 | DigiKey | 10-ERJ-P08F2200VCT-ND | https://www.digikey.com/en/products/detail/panasonic-industry/ERJ-P08F2200V/9812789 | Mouser |  | https://br.mouser.com/c/?q=ERJ-P08F2200V | https://industrial.panasonic.com/cdbs/www-data/pdf/RDA0000/AOA0000C304.pdf | SKU conferido; consultar disponibilidade | Bias_PHI.SchDoc
R905 | 1 | 1k / 1% / 0.25 W | YAGEO | RC1206FR-071KL | R1206 | DigiKey |  | https://www.digikey.com.br/pt/products/result?keywords=RC1206FR-071KL | Mouser |  | https://br.mouser.com/c/?q=RC1206FR-071KL | https://www.yageo.com/en/Product/Index/rchip | Busca por MPN; SKU e disponibilidade a confirmar | Bias_PHI.SchDoc
R906 | 1 | 1M / 1% | YAGEO | RC0603FR-071ML | R-0603 | DigiKey |  | https://www.digikey.com.br/pt/products/result?keywords=RC0603FR-071ML | Mouser |  | https://br.mouser.com/c/?q=RC0603FR-071ML | https://www.yageo.com/en/Product/Index/rchip | Busca por MPN; SKU e disponibilidade a confirmar | Bias_PHI.SchDoc
SW100 | 1 | POWER / botao NA | E-Switch | TL3305AF160QG | SW_TL3305A | DigiKey |  | https://www.digikey.com.br/pt/products/result?keywords=TL3305AF160QG | Mouser |  | https://br.mouser.com/c/?q=TL3305AF160QG | https://www.e-switch.com/product-catalog/tl3305-series-tact-switch/ | Busca por MPN; SKU e disponibilidade a confirmar | CM5_Boot_USB.SchDoc | Botao normalmente aberto; quatro pads fisicos, dois numeros eletricos repetidos.
SW1000 | 1 | ARM FISICO / ABERTO | Wurth Elektronik | 61300211121 | HDR_1X02_P254 | DigiKey |  | https://www.digikey.com.br/pt/products/result?keywords=61300211121 | Mouser |  | https://br.mouser.com/c/?q=61300211121 | https://www.we-online.com/components/products/datasheet/61300211121.pdf | Busca por MPN; SKU e disponibilidade a confirmar | Safety_Watchdog.SchDoc | Header 1x2; shunt removivel listado como acessorio. SW1000 inicia aberto.
SW300 | 1 | RESET / botao NA | E-Switch | TL3305AF160QG | SW_TL3305A | DigiKey |  | https://www.digikey.com.br/pt/products/result?keywords=TL3305AF160QG | Mouser |  | https://br.mouser.com/c/?q=TL3305AF160QG | https://www.e-switch.com/product-catalog/tl3305-series-tact-switch/ | Busca por MPN; SKU e disponibilidade a confirmar | MCU_RP2040.SchDoc | Botao normalmente aberto; quatro pads fisicos, dois numeros eletricos repetidos.
U100 | 1 | USBLC6-2SC6 | STMicroelectronics | USBLC6-2SC6 | SOT26 | DigiKey |  | https://www.digikey.com.br/pt/products/result?keywords=USBLC6-2SC6 | Mouser |  | https://br.mouser.com/c/?q=USBLC6-2SC6 | https://www.st.com/resource/en/datasheet/usblc6-2.pdf | Busca por MPN; SKU e disponibilidade a confirmar | CM5_Boot_USB.SchDoc
U1000 | 1 | CD74HCT123M96 | Texas Instruments | CD74HCT123M96 | SOIC16 | DigiKey |  | https://www.digikey.com.br/pt/products/result?keywords=CD74HCT123M96 | Mouser |  | https://br.mouser.com/c/?q=CD74HCT123M96 | https://www.ti.com/lit/ds/symlink/cd74hct123.pdf | Busca por MPN; SKU e disponibilidade a confirmar | Safety_Watchdog.SchDoc
U1001 | 1 | SN74LVC1G11DBVR | Texas Instruments | SN74LVC1G11DBVR | SOT26 | DigiKey |  | https://www.digikey.com.br/pt/products/result?keywords=SN74LVC1G11DBVR | Mouser |  | https://br.mouser.com/c/?q=SN74LVC1G11DBVR | https://www.ti.com/lit/ds/symlink/sn74lvc1g11.pdf | Busca por MPN; SKU e disponibilidade a confirmar | Safety_Watchdog.SchDoc
U101 | 1 | SN74LVC1G17DBVR | Texas Instruments | SN74LVC1G17DBVR | FP-C04-091-OT-MFG | DigiKey |  | https://www.digikey.com.br/pt/products/result?keywords=SN74LVC1G17DBVR | Mouser |  | https://br.mouser.com/c/?q=SN74LVC1G17DBVR | https://www.ti.com/lit/ds/symlink/sn74lvc1g17.pdf | Busca por MPN; SKU e disponibilidade a confirmar | CM5_Boot_USB.SchDoc
U1100 | 1 | OPA197ID | Texas Instruments | OPA197ID | SOIC8 | DigiKey |  | https://www.digikey.com.br/pt/products/result?keywords=OPA197ID | Mouser |  | https://br.mouser.com/c/?q=OPA197ID | https://www.ti.com/lit/ds/symlink/opa197.pdf | Busca por MPN; SKU e disponibilidade a confirmar | Safety_Window.SchDoc
U1101 | 1 | LM339BDR | Texas Instruments | LM339BDR | SOIC14 | DigiKey |  | https://www.digikey.com.br/pt/products/result?keywords=LM339BDR | Mouser |  | https://br.mouser.com/c/?q=LM339BDR | https://www.ti.com/lit/ds/symlink/lm339b.pdf | Busca por MPN; SKU e disponibilidade a confirmar | Safety_Window.SchDoc
U1102 | 1 | LM339BDR | Texas Instruments | LM339BDR | SOIC14 | DigiKey |  | https://www.digikey.com.br/pt/products/result?keywords=LM339BDR | Mouser |  | https://br.mouser.com/c/?q=LM339BDR | https://www.ti.com/lit/ds/symlink/lm339b.pdf | Busca por MPN; SKU e disponibilidade a confirmar | Safety_Window.SchDoc
U200 | 1 | AP64501SP-13 | Diodes Incorporated | AP64501SP-13 | AP64501_SO8EP | DigiKey |  | https://www.digikey.com.br/pt/products/result?keywords=AP64501SP-13 | Mouser |  | https://br.mouser.com/c/?q=AP64501SP-13 | https://www.diodes.com/datasheet/download/AP64501.pdf | Busca por MPN; SKU e disponibilidade a confirmar | Power_Input_5V.SchDoc
U210 | 1 | LM317T | STMicroelectronics | LM317T | TO220_3 | DigiKey |  | https://www.digikey.com.br/pt/products/result?keywords=LM317T | Mouser |  | https://br.mouser.com/c/?q=LM317T | https://www.st.com/resource/en/datasheet/lm317.pdf | Busca por MPN; SKU e disponibilidade a confirmar | Power_Analog.SchDoc
U211 | 1 | LM337T | STMicroelectronics | LM337T | TO220_3 | DigiKey |  | https://www.digikey.com.br/pt/products/result?keywords=LM337T | Mouser |  | https://br.mouser.com/c/?q=LM337T | https://www.st.com/resource/en/datasheet/lm337.pdf | Busca por MPN; SKU e disponibilidade a confirmar | Power_Analog.SchDoc
U212 | 1 | LT1763CS8-5#PBF | Analog Devices | LT1763CS8-5#PBF | SOIC8 | DigiKey |  | https://www.digikey.com.br/pt/products/result?keywords=LT1763CS8-5%23PBF | Mouser |  | https://br.mouser.com/c/?q=LT1763CS8-5%23PBF | https://www.analog.com/media/en/technical-documentation/data-sheets/1763fg.pdf | Busca por MPN; SKU e disponibilidade a confirmar | Power_Analog.SchDoc
U300 | 1 | Raspberry Pi Pico / SC0915 | Raspberry Pi | SC0915 | PICO_TH40 | DigiKey |  | https://www.digikey.com.br/pt/products/result?keywords=SC0915 | Mouser |  | https://br.mouser.com/c/?q=SC0915 | https://datasheets.raspberrypi.com/pico/pico-datasheet.pdf | Busca por MPN; SKU e disponibilidade a confirmar | MCU_RP2040.SchDoc | Montagem THT com dois headers de 20 vias incluidos na lista de acessorios; sem pads SMT sob o modulo. R5 preserva o modelo 3D Pico W SC0918 fornecido; BOM eletrica continua SC0915, conferir variante na montagem.
U301 | 1 | SN74LVC1G17DBVR | Texas Instruments | SN74LVC1G17DBVR | FP-C04-091-OT-MFG | DigiKey |  | https://www.digikey.com.br/pt/products/result?keywords=SN74LVC1G17DBVR | Mouser |  | https://br.mouser.com/c/?q=SN74LVC1G17DBVR | https://www.ti.com/lit/ds/symlink/sn74lvc1g17.pdf | Busca por MPN; SKU e disponibilidade a confirmar | MCU_RP2040.SchDoc
U302 | 1 | SN74LVC1G17DBVR | Texas Instruments | SN74LVC1G17DBVR | FP-C04-091-OT-MFG | DigiKey |  | https://www.digikey.com.br/pt/products/result?keywords=SN74LVC1G17DBVR | Mouser |  | https://br.mouser.com/c/?q=SN74LVC1G17DBVR | https://www.ti.com/lit/ds/symlink/sn74lvc1g17.pdf | Busca por MPN; SKU e disponibilidade a confirmar | MCU_RP2040.SchDoc
U400 | 1 | ADS1256IDB | Texas Instruments | ADS1256IDB | SSOP28_DB | DigiKey |  | https://www.digikey.com.br/pt/products/result?keywords=ADS1256IDB | Mouser |  | https://br.mouser.com/c/?q=ADS1256IDB | https://www.ti.com/lit/ds/symlink/ads1256.pdf | Busca por MPN; SKU e disponibilidade a confirmar | ADC.SchDoc
U401 | 1 | ADR431BRZ | Analog Devices | ADR431BRZ | SOIC8 | DigiKey |  | https://www.digikey.com.br/pt/products/result?keywords=ADR431BRZ | Mouser |  | https://br.mouser.com/c/?q=ADR431BRZ | https://www.analog.com/media/en/technical-documentation/data-sheets/ADR430_431_433_434_435.pdf | Busca por MPN; SKU e disponibilidade a confirmar | ADC.SchDoc
U500 | 1 | OPA380AID | Texas Instruments | OPA380AID | SOIC8 | DigiKey |  | https://www.digikey.com.br/pt/products/result?keywords=OPA380AID | Mouser |  | https://br.mouser.com/c/?q=OPA380AID | https://www.ti.com/lit/ds/symlink/opa380.pdf | Busca por MPN; SKU e disponibilidade a confirmar | TIA.SchDoc
U501 | 1 | OPA197ID | Texas Instruments | OPA197ID | SOIC8 | DigiKey |  | https://www.digikey.com.br/pt/products/result?keywords=OPA197ID | Mouser |  | https://br.mouser.com/c/?q=OPA197ID | https://www.ti.com/lit/ds/symlink/opa197.pdf | Busca por MPN; SKU e disponibilidade a confirmar | TIA.SchDoc
U502 | 1 | OPA197ID | Texas Instruments | OPA197ID | SOIC8 | DigiKey |  | https://www.digikey.com.br/pt/products/result?keywords=OPA197ID | Mouser |  | https://br.mouser.com/c/?q=OPA197ID | https://www.ti.com/lit/ds/symlink/opa197.pdf | Busca por MPN; SKU e disponibilidade a confirmar | TIA.SchDoc
U600 | 1 | DAC80504RTER | Texas Instruments | DAC80504RTER | DAC80504_RTE | DigiKey |  | https://www.digikey.com.br/pt/products/result?keywords=DAC80504RTER | Mouser |  | https://br.mouser.com/c/?q=DAC80504RTER | https://www.ti.com/lit/ds/symlink/dac80504.pdf | Busca por MPN; SKU e disponibilidade a confirmar | DAC_Reference.SchDoc
U601 | 1 | OPA197ID | Texas Instruments | OPA197ID | SOIC8 | DigiKey |  | https://www.digikey.com.br/pt/products/result?keywords=OPA197ID | Mouser |  | https://br.mouser.com/c/?q=OPA197ID | https://www.ti.com/lit/ds/symlink/opa197.pdf | Busca por MPN; SKU e disponibilidade a confirmar | DAC_Reference.SchDoc
U700 | 1 | OPA197ID | Texas Instruments | OPA197ID | SOIC8 | DigiKey |  | https://www.digikey.com.br/pt/products/result?keywords=OPA197ID | Mouser |  | https://br.mouser.com/c/?q=OPA197ID | https://www.ti.com/lit/ds/symlink/opa197.pdf | Busca por MPN; SKU e disponibilidade a confirmar | Bias_I.SchDoc
U800 | 1 | OPA197ID | Texas Instruments | OPA197ID | SOIC8 | DigiKey |  | https://www.digikey.com.br/pt/products/result?keywords=OPA197ID | Mouser |  | https://br.mouser.com/c/?q=OPA197ID | https://www.ti.com/lit/ds/symlink/opa197.pdf | Busca por MPN; SKU e disponibilidade a confirmar | Bias_Q.SchDoc
U900 | 1 | OPA197ID | Texas Instruments | OPA197ID | SOIC8 | DigiKey |  | https://www.digikey.com.br/pt/products/result?keywords=OPA197ID | Mouser |  | https://br.mouser.com/c/?q=OPA197ID | https://www.ti.com/lit/ds/symlink/opa197.pdf | Busca por MPN; SKU e disponibilidade a confirmar | Bias_PHI.SchDoc
Y400 | 1 | 7.680 MHz / CL18pF | Abracon | ABLS-7.680MHZ-B2-T | XTAL_HC49 | DigiKey |  | https://www.digikey.com.br/pt/products/result?keywords=ABLS-7.680MHZ-B2-T | Mouser |  | https://br.mouser.com/c/?q=ABLS-7.680MHZ-B2-T | https://abracon.com/Resonators/abls.pdf | Busca por MPN; SKU e disponibilidade a confirmar | ADC.SchDoc | CL 18 pF; 27 pF externos sao iniciais. Ajustar aos parasitas e verificar oscilacao.
F220 | 1 | T1.5 A / 125 V | Littelfuse | 045201.5MRL | FUSE_NANO2 | DigiKey |  | https://www.digikey.com/en/products/result?keywords=045201.5MRL | Mouser |  | https://www.mouser.com/c/?q=045201.5MRL | https://www.mouser.com/datasheet/2/240/Littelfuse_452_454-58610.pdf | MPN selecionado; SKU e disponibilidade a confirmar | Power_Neg15.SchDoc | F220: 1,5 A retardado, Littelfuse 045201.5MRL. TRACO recomenda 1,6 A retardado; validar corrente de partida, I2t e coordenacao de protecao.
C220 | 1 | 10 uF / 50 V X7R | KEMET | C1210C106K5RACTU | C1210 | DigiKey |  | https://www.digikey.com.br/pt/products/result?keywords=C1210C106K5RACTU | Mouser |  | https://br.mouser.com/c/?q=C1210C106K5RACTU | https://www.yageogroup.com/download/specsheet/C1210C106K5RACTU | Busca por MPN; SKU e disponibilidade a confirmar | Power_Neg15.SchDoc
C221 | 1 | 100 nF / 50 V X7R | KEMET | C0805C104K5RACTU | C0805 | DigiKey |  | https://www.digikey.com.br/pt/products/result?keywords=C0805C104K5RACTU | Mouser |  | https://br.mouser.com/c/?q=C0805C104K5RACTU | https://www.yageogroup.com/download/specsheet/C0805C104K5RACTU | Busca por MPN; SKU e disponibilidade a confirmar | Power_Neg15.SchDoc
C222 | 1 | 10 uF / 50 V X7R | KEMET | C1210C106K5RACTU | C1210 | DigiKey |  | https://www.digikey.com.br/pt/products/result?keywords=C1210C106K5RACTU | Mouser |  | https://br.mouser.com/c/?q=C1210C106K5RACTU | https://www.yageogroup.com/download/specsheet/C1210C106K5RACTU | Busca por MPN; SKU e disponibilidade a confirmar | Power_Neg15.SchDoc
C223 | 1 | 100 nF / 50 V X7R | KEMET | C0805C104K5RACTU | C0805 | DigiKey |  | https://www.digikey.com.br/pt/products/result?keywords=C0805C104K5RACTU | Mouser |  | https://br.mouser.com/c/?q=C0805C104K5RACTU | https://www.yageogroup.com/download/specsheet/C0805C104K5RACTU | Busca por MPN; SKU e disponibilidade a confirmar | Power_Neg15.SchDoc
U220 | 1 | TMR 3-1213 | TRACO Power | TMR 3-1213 | TMR3_SIP8_15V | DigiKey |  | https://www.digikey.com/en/products/result?keywords=TMR%203-1213 | Mouser |  | https://www.mouser.com/c/?q=TMR%203-1213 | https://www.tracopower.com/products/tmr3.pdf | Busca por MPN; SKU e disponibilidade a confirmar | Power_Neg15.SchDoc | Single-output TMR 3-1213, 3 W / 200 mA. Pino 6 = GND, pino 7 = -15 V; pino 3 aberto. Modelo 3D dimensional simplificado.
