CarloRenan/CM5-RP2040-MZM/docs/relatorios/Lista_Compras_Prototipo_CM5_RP2040 .xlsx

Sheet: Compras
Lista de compras | Protótipo CM5 / RP2040
Bancada térmica e carga elétrica de três diodos • 20 produtos • 60 links • Consulta: 22/10/2026
Quantidades propostas para uma bancada. Altere a quantidade para descontar itens já disponíveis no laboratório. A fonte de bancada está incluída; a ponte H é opcional, com quantidade zero.
O conjunto TEC é uma opção de ensaio. A equivalência com o laser depende do modelo e das especificações térmicas. A placa R6 de controle do MZM mantém seu projeto de alimentação de 15 V.
Subtotal dos itens cotados |  |  | R$952.85 |  |  | Itens com preço pendente |  |  | 1 | Sem frete. Não é um orçamento final.
Azul: quantidade e opção de compra editáveis. Escolha 1, 2 ou 3 para atualizar embalagem e preço. Campo vazio em Preço significa “consultar”; não significa custo zero. Detalhes das ofertas na aba Cotações.
ID | Produto / especificação | Qtd. a comprar | Unidade | Opção 1, 2 ou 3 | Qtd. por lote | Lotes | Preço / lote | Subtotal cotado | Link 1 | Link 2 | Link 3 | Para que serve / critério de escolha
01 | Raspberry Pi Pico — RP2040 | 2 | placa | 1 | 1 | 2 | R$75.86 | R$151.72 | RoboBuilders | Usinainfo | Proesi | Uma placa ativa e uma reserva. USB alimenta a lógica; não exige fonte externa de 3,3 V. Escolher Pico com RP2040, não Pico 2.
02 | Conjunto térmico: TEC + dissipador + ventilação | 1 | conjunto | 1 | 1 | 1 | R$102.90 | R$102.90 | Dissipatec | TDTEC | Shopee / Dissipatec | Pastilha TEC1-12706 para bancada didática. O kit reúne TEC, dissipação e ventilação. Não foi comprovada equivalência com o TEC do laser.
03 | Ponte H BTS7960 — estudo de acionamento | 0 | módulo | 1 | 1 | 0 | R$44.99 | R$0.00 | Casa da Robótica | Vida de Silício | Saravati | Opcional, fora da compra base. Serve para estudar reversão e potência. Uso com TEC exige projeto do filtro e da malha; não é controlador de laser pronto.
04 | Sensor NTC 10 kΩ — B3950 | 2 | sensor | 1 | 1 | 2 | R$25.20 | R$50.40 | Malta Suprimentos | Easytronics | Liohm | Um sensor acompanha a carga térmica e outro o dissipador. O formato físico das alternativas muda; prever fixação e bom contato térmico.
05 | ADC ADS1115 em módulo I²C | 1 | módulo | 1 | 1 | 1 | R$16.20 | R$16.20 | A2 Robotics | Ardushop | Saravati | Lê os divisores dos dois NTCs e a tensão do shunt. Alimentar em 3,3 V e manter os pull-ups I²C em 3,3 V. Não substitui a aquisição do MZM.
06 | Resistor 10 kΩ, 1%, PTH | 10 | peça | 1 | 10 | 1 | R$0.90 | R$0.90 | Smart Kits | Proesi | Achei Componentes | Dois resistores formam os divisores de tensão dos NTCs; o restante fica de reserva. Aceitar potência de 1/4 W ou superior.
07 | Capacitor cerâmico 100 nF, 50 V, PTH | 10 | peça | 1 | 10 | 1 | R$1.90 | R$1.90 | Achei Componentes | Eletrogate | MakerHero | Desacoplamento e filtragem local da parte de medição. Pacote inclui reserva. Não é o filtro de potência de uma ponte H para TEC.
08 | Aquecedor resistivo: 10 Ω, 20 W | 1 | resistor | 1 | 1 | 1 |  |  | Proesi | Equitronic | Mercado Livre | Produz calor para imitar a dissipação do laser. Ensaio inicial proposto: 5 V, 0,5 A e 2,5 W calculados. Fixar à carga com isolamento elétrico.
09 | Módulo MOSFET D4184 com entrada 3,3 V | 1 | módulo | 1 | 1 | 1 | R$8.50 | R$8.50 | Só Tudo | Curto Circuito | AutoCore Robótica | Controla por PWM a potência do aquecedor. Escolher a versão de comando 3,3–20 V; há módulos optoacoplados semelhantes que exigem 5 V.
10 | Diodo 1N5408 — carga de três diodos | 6 | diodo | 1 | 10 | 1 | R$7.90 | R$7.90 | Eletrogate | Baú da Eletrônica | A2 Robotics | Três diodos em série formam a carga elétrica; três são reserva. A carga não produz luz nem reproduz a curva óptica do laser.
11 | Resistor shunt de 1 Ω, 5 W | 2 | resistor | 1 | 1 | 2 | R$1.76 | R$3.52 | Achei Componentes | RS Componentes | Intertronix | Um shunt no retorno da carga permite calcular I = V/R; outro fica de reserva. A tolerância de 5% limita a exatidão sem caracterização do valor real.
12 | XL4015 com ajuste de tensão E corrente | 3 | módulo | 1 | 1 | 3 | R$16.99 | R$50.97 | Casa da Robótica | Usinainfo | Eletrogate | Três ramos: TEC com ajuste DC manual; aquecedor em 5 V; carga de diodos com corrente limitada. Comprar versão CC/CV, não módulo de um só trimpot.
13 | Fonte de bancada ajustável 0–30 V / 5 A | 1 | fonte | 1 | 1 | 1 | R$410.00 | R$410.00 | TEC BIG / Sunshine | RF4 Ferramentas | Shopee / Yaxun | Alimenta o ensaio em 12 V com limitação de corrente. Excluir da compra se o laboratório já tiver uma. Não representa operação do TEC em sua potência máxima.
14 | Protoboard 830 pontos | 1 | placa | 1 | 1 | 1 | R$11.99 | R$11.99 | Casa da Robótica | Eletrogate | Mult Comercial | Montagem dos NTCs, divisores e sinais de baixa corrente. TEC, aquecedor e corrente dos diodos devem usar conexões soldadas ou bornes apropriados.
15 | Kit de jumpers MM + MF + FF | 1 | kit | 1 | 1 | 1 | R$22.90 | R$22.90 | MakerHero | Casa da Robótica | Shopee | Ligações dos sinais entre Pico, ADC e módulos. Apenas sinais e baixa corrente; não usar jumpers Dupont nos ramos de potência.
16 | Cabo USB-A → micro-USB com dados | 2 | cabo | 1 | 1 | 2 | R$9.90 | R$19.80 | AutoCore Robótica | Eletrogate | RoboCore | Programação e alimentação das duas Pico. Se a placa adquirida tiver USB-C, o cabo precisa acompanhar essa versão.
17 | Barra de pinos macho 1 × 40; 2,54 mm | 3 | barra | 1 | 1 | 3 | R$0.80 | R$2.40 | Eletrogate | Mult Comercial | Usinainfo | Duas barras atendem duas Pico sem pinos soldados; a terceira é reserva para o ADC. Dividir cada barra em duas de 20 pinos para uma Pico.
18 | Fio de cobre flexível 18 AWG, vermelho/preto | 2 | m total | 1 | 4 | 1 | R$84.90 | R$84.90 | Azupa | Action Modelismo | Shopee | Previsão mínima de 1 m por cor para os ramos de baixa tensão. As ofertas têm comprimentos diferentes; cálculo considera metros totais.
19 | Porta-fusível de fio, 5 × 20 mm | 2 | peça | 1 | 1 | 2 | R$1.90 | R$3.80 | Eletrogate | Baú da Eletrônica | AutoCore Robótica | Proteção em série com os ramos de potência do protótipo. Usar porta-fusível isolado; não é componente para inserir na protoboard.
20 | Fusível rápido 3 A, 5 × 20 mm | 5 | peça | 1 | 1 | 5 | R$0.43 | R$2.15 | Plenobras | Proesi | Dimensional | Dois em uso e três reservas para ensaios com corrente limitada. Valor preliminar dos ramos; não permite explorar 6 A do TEC. Confirmar aplicação em CC.
Compra inicial: a ponte H (03) está excluída. O TEC é acionado em corrente contínua com ajuste manual no XL4015; a malha automática do TEC ainda requer um driver e filtro dimensionados para o laser.
Como comparar: cada linha usa apenas uma oferta. A quantidade de lotes é arredondada para cima. Exemplo: 6 diodos necessários e pacote de 10 → comprar 1 pacote. Não somar os três fornecedores.
Aba Uso e critérios: sequência dos ensaios, alimentação, distinção entre carga elétrica e térmica, limites do conjunto proposto e fontes técnicas.

Sheet: Cotações
Cotações e links de origem
Três links de produto por item. As embalagens, formas físicas e condições comerciais podem variar. Pesquisa consultada em 22/10/2026.
Preços em reais, sem frete e sem desconto Pix no cálculo. Atualize preço e quantidade do lote somente após conferir a opção escolhida. Ofertas indisponíveis foram identificadas; não são recomendadas para compra imediata.
“A confirmar” indica que a disponibilidade não foi comprovada. Uma página localizada pelo buscador não comprova estoque. Na lista principal, a opção 1 é a referência de orçamento, não uma garantia de menor preço.
Chave | ID | Opção | Fornecedor / canal | Produto e embalagem | Unidades / lote | Preço / lote (R$) | Condição do preço | Disponibilidade observada | URL de origem | Observação da oferta
01-1 | 01 | 1 | RoboBuilders | 1 placa Pico / RP2040 | 1 | R$75.86 | Preço normal anunciado | Disponível na página | https://www.robobuilders.com.br/placa-raspberry-pi-pico-rp2040-arm-cortex-133mhz-256kb | Preço normal. Descrição da loja contém erros de memória; usar documentação oficial para especificações.
01-2 | 01 | 2 | Usinainfo | 1 placa Pico / RP2040 | 1 | R$76.40 | Preço normal anunciado | Indisponível na página | https://www.usinainfo.com.br/placa-raspberry-pi/raspberry-pi-pico-rp2040-com-micro-usb-8372.html | Preço normal exibido; página oferece aviso de reposição.
01-3 | 01 | 3 | Proesi | 1 placa Pico / RP2040 | 1 |  | Não confirmado | A confirmar | https://www.proesi.com.br/raspberry-pi-pico-rp2040-2mb-original | Produto localizado na pesquisa; acesso direto bloqueado (403).
02-1 | 02 | 1 | Dissipatec | 1 conjunto; TEC1-12706; cooler duplo; 12 V | 1 | R$102.90 | Preço normal anunciado | Disponível em 2 dias úteis | https://www.dissipatec.com.br/dissipadores-termoeletrico/dissipadores-termoeletrico/dissipador-termoeletrico-cooler-duplo-peltier-12v | Preço normal anunciado. Modelo DT104 P; capacidade térmica depende da montagem.
02-2 | 02 | 2 | TDTEC | 1 conjunto; TEC12706; dissipador; fan 80 mm; pasta e fixadores | 1 |  | Não confirmado | Indisponível na página | https://www.tdtec.com.br/eletronicos/kit-refrigeracao-12v-peltier-12706-dissipador-cooler | Kit com uma ventoinha; geometria diferente da opção 1.
02-3 | 02 | 3 | Shopee / Dissipatec | 1 kit; TEC12706 + dissipador + cooler | 1 | R$154.00 | Preço normal anunciado | A confirmar | https://shopee.com.br/Kit-Refrigera%C3%A7%C3%A3o-12v-Peltier-12706-Dissipador-Cooler-i.369065757.18761286023 | Preço normal; Pix exibido R$ 146,30. Mesmo vendedor da opção 1, em outro canal; kit pode diferir.
03-1 | 03 | 1 | Casa da Robótica | 1 módulo BTS7960 / IBT-2 | 1 | R$44.99 | Preço normal anunciado | Disponível na página | https://www.casadarobotica.com/sensores-modulos/modulos/outros/modulo-driver-ponte-h-43a-bts7960 | Anúncio refere-se a driver de motor. Corrente comercial de 43 A não é corrente contínua garantida da montagem.
03-2 | 03 | 2 | Vida de Silício | 1 módulo BTS7960 | 1 | R$39.90 | Preço normal anunciado | Indisponível na página | https://vidadesilicio.com.br/produto/modulo-driver-ponte-h-bts7960-43a/ | Preço anunciado; fora de estoque.
03-3 | 03 | 3 | Saravati | 1 módulo BTS7960 | 1 |  | Não confirmado | A confirmar | https://www.saravati.com.br/modulo-driver-ponte-h-bts7960.html | Produto localizado; acesso direto bloqueado (403).
04-1 | 04 | 1 | Malta Suprimentos | 1 sonda inox 5 × 25 mm; 10 kΩ; 1%; STB3950 | 1 | R$25.20 | Preço normal anunciado | Disponível na página | https://www.maltasuprimentos.com.br/sensor-de-temperatura-ntc-10k-1-5x25mm-inox-msa-stb3950 | Preço normal; Pix R$ 23,94. Fixação da sonda difere de um sensor de olhal.
04-2 | 04 | 2 | Easytronics | 1 NTC 10 kΩ / B3950; olhal 5 mm | 1 |  | Não confirmado | A confirmar | https://www.easytronics.com.br/sensor-de-temperatura-termistor-ntc-10k-b3950-olhal-5mm | Produto localizado; acesso direto bloqueado (403).
04-3 | 04 | 3 | Liohm | 1 NTC 10 kΩ / B3950; olhal 3 mm; cabo 1,5 m | 1 | R$45.00 | Preço normal anunciado | A confirmar | https://loja.liohm.com.br/produtos/sensor-ntc-10k-olhal-furo-3-mm-cabo-pp-2x26-awg-1500-mm/ | Preço exibido; disponibilidade não inequívoca no conteúdo consultado.
05-1 | 05 | 1 | A2 Robotics | 1 módulo ADS1115; 4 entradas multiplexadas | 1 | R$16.20 | Preço normal anunciado | Disponível na página | https://www.a2robotics.com.br/modulo-conversor-analogico-adc-ads1115 | Preço normal; Pix R$ 15,39.
05-2 | 05 | 2 | Ardushop | 1 módulo ADS1115 | 1 |  | Não confirmado | A confirmar | https://www.ardushop.com.br/modulo-conversor-analogico-digital-ads1115-16bits-4-canais | Página consultada; preço não consolidado.
05-3 | 05 | 3 | Saravati | 1 módulo ADS1115 | 1 |  | Não confirmado | A confirmar | https://www.saravati.com.br/modulo-conversor-analogico-digital-ads1115.html | Produto localizado; acesso direto bloqueado (403).
06-1 | 06 | 1 | Smart Kits | Pacote com 10 resistores; 1/4 W; 1% | 10 | R$0.90 | Preço normal anunciado | Compra habilitada na página | https://www.smartkits.com.br/resistor-10k-14w-1-10-unidades | Preço do pacote, não de cada resistor.
06-2 | 06 | 2 | Proesi | 1 resistor; 1/4 W; 1% | 1 |  | Não confirmado | A confirmar | https://www.proesi.com.br/resistor-precisao-1-1-4w-10k | Link localizado; preço e estoque não confirmados.
06-3 | 06 | 3 | Achei Componentes | Pacote com 10 resistores; 0,6 W; 1% | 10 |  | Não confirmado | A confirmar | https://www.acheicomponentes.com.br/resistor/kit-10-pecas-resistor-10k-1-0-6w-axial | Link localizado; preço e estoque não confirmados.
07-1 | 07 | 1 | Achei Componentes | Pacote com 10 capacitores; disco; marcação 104 | 10 | R$1.90 | Preço normal anunciado | Disponível na página | https://www.acheicomponentes.com.br/capacitores/kit-10-pecas-capacitor-ceramico-disco-100nf-100k-50v-104 | Preço do pacote. 100 nF = 0,1 µF.
07-2 | 07 | 2 | Eletrogate | 1 capacitor cerâmico 100 nF / 50 V | 1 |  | Não confirmado | A confirmar | https://www.eletrogate.com/capacitor-disco-ceramico-100nf-x-50v | Página consultada; preço do item não apareceu no conteúdo retornado.
07-3 | 07 | 3 | MakerHero | 1 capacitor cerâmico 100 nF / 50 V | 1 |  | Não confirmado | A confirmar | https://www.makerhero.com/produto/capacitor-ceramico-100nf-50v/ | Link localizado; preço e estoque não confirmados.
08-1 | 08 | 1 | Proesi | 1 resistor de porcelana; 10 Ω / 20 W | 1 |  | Não confirmado | A confirmar | https://www.proesi.com.br/resistor-de-porcelana-20w-10r | Especificação confirmada na página; preço não exibido.
08-2 | 08 | 2 | Equitronic | 1 resistor de fio axial; 10 Ω / 20 W; 9 × 53 mm | 1 |  | Não confirmado | A confirmar | https://loja.equitronic.com.br/componentes-eletronicos/resistor/10w/resistor-20w-10r-fio-knp-9x53mm | Formato diferente da opção 1; acesso direto bloqueado (403).
08-3 | 08 | 3 | Mercado Livre | Pacote com 4 resistores de porcelana; 10 Ω / 20 W | 4 |  | Não confirmado | A confirmar | https://www.mercadolivre.com.br/kit-04-resistor-porcelana-20w-10r-5-mr4352/up/MLBU1155701161 | Link localizado; preço e estoque não confirmados.
09-1 | 09 | 1 | Só Tudo | 1 módulo D4184; potência 5–36 V; comando 3,3–20 V | 1 | R$8.50 | Preço normal anunciado | Entrega imediata | https://www.sotudo.com.br/produto/modulo-controlador-pwm-de-alta-potencia-d4184 | Preço anunciado. Dimensionamento proposto para aquecedor de 0,5 A; não usar 30 A/400 W como garantia da placa.
09-2 | 09 | 2 | Curto Circuito | 1 módulo D4184 duplo; lógica 3,3–20 V | 1 |  | Não confirmado | A confirmar | https://curtocircuito.com.br/modulo-mosfet-duplo-40v-50a-400w-d4184.html | Página consultada. Conferir disponibilidade da versão de dois MOSFETs.
09-3 | 09 | 3 | AutoCore Robótica | 1 módulo D4184; lógica 3,3–20 V | 1 |  | Não confirmado | A confirmar | https://www.autocorerobotica.com.br/modulo-controlador-pwm-d4184-30a-400w-36v | Especificação do sinal de comando localizada; preço não consolidado.
10-1 | 10 | 1 | Eletrogate | Pacote com 10 diodos 1N5408 | 10 | R$7.90 | Preço normal anunciado | Disponível na página | https://www.eletrogate.com/diodo-1n5408 | O orçamento inclui um pacote de 10, apesar de a necessidade ser 6.
10-2 | 10 | 2 | Baú da Eletrônica | 1 diodo 1N5408 | 1 |  | Não confirmado | A confirmar | https://www.baudaeletronica.com.br/produto/diodo-1n5408.html | Link localizado; preço e estoque não confirmados.
10-3 | 10 | 3 | A2 Robotics | Pacote com 10 diodos 1N5408 | 10 |  | Não confirmado | A confirmar | https://www.a2robotics.com.br/diodo-1n5408 | Link localizado; preço e estoque não confirmados.
11-1 | 11 | 1 | Achei Componentes | 1 resistor axial; 1 Ω / 5 W / 5% | 1 | R$1.76 | Preço normal anunciado | Disponível na página | https://www.acheicomponentes.com.br/resistor/resistor-5w/resistor-1r-5w-5-axial | Preço unitário.
11-2 | 11 | 2 | RS Componentes | 1 resistor de fio; 1 Ω / 5 W / 5% | 1 |  | Não confirmado | A confirmar | https://www.rscomponentes.com/resistor-fio-5w-1r-5-knp-fita-acel | Página consultada; preço não consolidado.
11-3 | 11 | 3 | Intertronix | 1 resistor; 1 Ω / 5 W | 1 |  | Não confirmado | A confirmar | https://www.intertronix.com.br/produtos/resistor-1r-5w-mrptdrdr/ | Página consultada; preço não consolidado.
12-1 | 12 | 1 | Casa da Robótica | 1 XL4015 CC/CV com ajustes independentes | 1 | R$16.99 | Preço normal anunciado | Disponível na página | https://www.casadarobotica.com/fonte-e-conversores/fontes/reguladores-de-tensao/regulador-com-ajuste-de-corrente-e-tensao-xl4015-5a-dc-dc | Preço normal; Pix/à vista R$ 16,14. Não dimensionar operação contínua pela corrente de pico anunciada.
12-2 | 12 | 2 | Usinainfo | 1 XL4015 CC/CV; anúncio indica 0,2–3 A | 1 |  | Não confirmado | A confirmar | https://www.usinainfo.com.br/regulador-de-tensao/regulador-de-tensao-e-corrente-ajustavel-xl4015-dc-step-down-saida-125-a-32vdc-02-a-3a-5880.html | Link localizado; preço e estoque não confirmados.
12-3 | 12 | 3 | Eletrogate | 1 XL4015 CC/CV; versão vermelha | 1 |  | Não confirmado | A confirmar | https://www.eletrogate.com/modulo-regulador-de-tensao-e-corrente-step-down-xl4015-5a-vermelho | Página consultada; preço do produto não apareceu. Não confundir com XL4015 apenas CV.
13-1 | 13 | 1 | TEC BIG / Sunshine | 1 fonte Sunshine P-3005D; selecionar entrada de rede | 1 | R$410.00 | Preço normal anunciado | Disponibilidade imediata | https://www.tecbig.com.br/ferramentas-laboratorio/fonte-bancada/fonte-de-alimentacao-digital-para-bancada-eletronica-3-digitos-30v-5a-p-3005d | Preço normal; à vista R$ 397,70. Anúncio apresenta informação divergente sobre bivolt: confirmar variante 110/220 V.
13-2 | 13 | 2 | RF4 Ferramentas | 1 fonte RF4 RF-3005D FIS; CC/CV; modelo diferente | 1 | R$700.00 | Preço normal anunciado | A confirmar | https://rf4ferramentas.com.br/produto/fonte-de-alimentacao-rf4-rf-3005d-fis | Preço exibido. Conferir conteúdo do conjunto e disponibilidade; funções adicionais não são necessárias ao ensaio.
13-3 | 13 | 3 | Shopee / Yaxun | 1 fonte Yaxun YX-3005D; modelo diferente | 1 |  | Não confirmado | A confirmar | https://shopee.com.br/FONTE-DE-ALIMENTA%C3%87%C3%83O-DE-BANCADA-REGUL%C3%81VEL-DE-0-30V-E-0-5A-YA-XUN-YAXUN-YX-3005D-BIVOLT.-i.329155987.20298022421 | Link localizado; preço e estoque não confirmados.
14-1 | 14 | 1 | Casa da Robótica | 1 protoboard; 830 pontos | 1 | R$11.99 | Preço normal anunciado | Disponível na página | https://www.casadarobotica.com/prototipagem-e-ferramentas/prototipagem/protoboard/protoboard-830-furos-pontos | Preço normal; à vista R$ 11,39.
14-2 | 14 | 2 | Eletrogate | 1 protoboard; 830 pontos | 1 |  | Não confirmado | A confirmar | https://www.eletrogate.com/protoboard-830-pontos | Link localizado; preço e estoque não confirmados.
14-3 | 14 | 3 | Mult Comercial | 1 protoboard MB-102; 830 pontos | 1 |  | Não confirmado | A confirmar | https://www.multcomercial.com.br/protoboard-830-pontos-mb-102.html | Link localizado; preço e estoque não confirmados.
15-1 | 15 | 1 | MakerHero | 1 kit; 120 jumpers de 20 cm; 40 de cada tipo | 1 | R$22.90 | Preço normal anunciado | Disponível na página | https://www.makerhero.com/produto/kit-jumpers-20cm-x120-unidades/ | Preço normal; Pix R$ 21,75.
15-2 | 15 | 2 | Casa da Robótica | 1 kit; 120 jumpers de 20 cm; MM/MF/FF | 1 |  | Não confirmado | A confirmar | https://www.casadarobotica.com/prototipagem-ferramentas/prototipagem/cabos/kit-120-cabo-jumper-de-20cm-40-macho-x-femea-40-macho-x-macho-e-40-femea-x-femea-pa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 | Conjunto de 120 unidades confirmado; preço não consolidado.
15-3 | 15 | 3 | Shopee | 1 kit; 120 jumpers de 20 cm; MM/MF/FF | 1 |  | Não confirmado | A confirmar | https://shopee.com.br/Jumpers-20cm-2.54mm-Kit-MM-MF-FF-120-Unidades-i.304791559.8240386378 | Link localizado; preço e estoque não confirmados.
16-1 | 16 | 1 | AutoCore Robótica | 1 cabo micro-USB para dados | 1 | R$9.90 | Preço normal anunciado | Disponível na página | https://www.autocorerobotica.com.br/cabo-de-dados-micro-usb-emborrachado-azul | Preço normal; Pix R$ 9,40.
16-2 | 16 | 2 | Eletrogate | 1 cabo micro-USB para dados; 30 cm | 1 |  | Não confirmado | A confirmar | https://www.eletrogate.com/cabo-micro-usb-azul-30-cm | Link localizado; preço e estoque não confirmados.
16-3 | 16 | 3 | RoboCore | 1 cabo micro-USB para dados; 80 cm | 1 |  | Não confirmado | Indisponível na pesquisa | https://www.robocore.net/cabo/cabo-usb-micro-b | Categoria consultada marcava esgotado; confirmar reposição.
17-1 | 17 | 1 | Eletrogate | 1 barra reta; 40 pinos; passo 2,54 mm | 1 | R$0.80 | Preço normal anunciado | Disponível na página | https://www.eletrogate.com/barra-de-pinos-macho-1x40-180 | Preço normal; Pix R$ 0,76.
17-2 | 17 | 2 | Mult Comercial | 1 barra reta macho; 40 pinos | 1 |  | Não confirmado | A confirmar | https://www.multcomercial.com.br/barra-de-pinos-1x40-macho-bmec040-1e.html | Link localizado; preço e estoque não confirmados.
17-3 | 17 | 3 | Usinainfo | 1 barra reta; 40 pinos; passo 2,54 mm | 1 |  | Não confirmado | A confirmar | https://www.usinainfo.com.br/barras-de-pinos/barra-de-pinos-macho-1x40-vias-com-passo-de-254mm-180-preto-2748.html | Link localizado; preço e estoque não confirmados.
18-1 | 18 | 1 | Azupa | 2 m vermelho + 2 m preto = 4 m | 4 | R$84.90 | Preço normal anunciado | Disponível na página | https://www.azupa.com.br/cabo-flexivel-de-silicone-18awg-2m-preto-e-vermelho | Preço do conjunto; Pix R$ 80,66. Um lote fornece mais fio que a necessidade mínima.
18-2 | 18 | 2 | Action Modelismo | 1 m vermelho + 1 m preto = 2 m | 2 |  | Não confirmado | A confirmar | https://www.actionmodelismo.com.br/parfiocabodecobrerevestidocomsilicone18awg23mmvermelhoepreto1metroflyermodflmx800018 | Página consultada; preço não consolidado.
18-3 | 18 | 3 | Shopee | 1 m vermelho + 1 m preto = 2 m | 2 |  | Não confirmado | A confirmar | https://shopee.com.br/Fio-Silicone-18awg-%281-Mt-Preto-1-Mt-Vermelho%29-i.393645533.21097457506 | Link localizado; preço e estoque não confirmados.
19-1 | 19 | 1 | Eletrogate | 1 porta-fusível de fio; 5 × 20 mm | 1 | R$1.90 | Preço normal anunciado | Disponível na página | https://www.eletrogate.com/porta-fusivel-meio-de-fio-5x20 | Preço normal; Pix R$ 1,80.
19-2 | 19 | 2 | Baú da Eletrônica | 1 porta-fusível 5 × 20 mm | 1 |  | Não confirmado | A confirmar | https://www.baudaeletronica.com.br/produto/porta-fusivel-pequeno-5x20-preto.html | Link localizado; preço e estoque não confirmados.
19-3 | 19 | 3 | AutoCore Robótica | 1 porta-fusível de fio; 5 × 20 mm | 1 |  | Não confirmado | A confirmar | https://www.autocorerobotica.com.br/porta-fusivel-5x20-meio-fio | Link localizado; preço e estoque não confirmados.
20-1 | 20 | 1 | Plenobras | 1 fusível rápido; 3 A; 5 × 20 mm | 1 | R$0.43 | Preço normal anunciado | Disponível na página | https://www.plenobras.com.br/646a5966d496504d21dd9f6b/fusivel-vidro-pequeno-3a-5x20-mm-250vca | Preço unitário. Anúncio informa 250 VCA; confirmar tensão/capacidade de interrupção em CC do lote.
20-2 | 20 | 2 | Proesi | 1 fusível Fusibras rápido; 3 A; 5 × 20 mm | 1 |  | Não confirmado | A confirmar | https://www.proesi.com.br/fusivel-vidro-fusibras-20agf-5x20mm-3a-rapido | Página técnica consultada; preço não exibido.
20-3 | 20 | 3 | Dimensional | 1 fusível Dekfuse rápido; 3 A; 5 × 20 mm | 1 |  | Não confirmado | A confirmar | https://www.dimensional.com.br/fusivel-vidro-5x20mm-rapida-250v-3a-v20agkf-dekfuse/p | Link localizado; preço e estoque não confirmados.

Sheet: Uso e critérios
Como esta lista atende ao protótipo
Proposta de bancada auxiliar ao projeto CM5 / RP2040 / MZM • 22/10/2026
Equipe: Carlos Renan Correia Fidelis; Carlos Elias Fialho de Lima; Pablo Daniel Nascimento Vieira.
Tema | Aplicação e decisão de compra
Escopo desta compra | Atende à solicitação de microcontroladores, TEC com dissipação e acionamento, sensor com condicionamento, aquecedor e carga de três diodos. É uma bancada para estudar os circuitos antes de conectar um laser. Não é a lista completa de fabricação da placa R6 nem uma afirmação de que ela já contém controle de corrente do laser e de temperatura.
Microcontrolador auxiliar | A opção mantém a Raspberry Pi Pico com RP2040, já usada no projeto. Uma placa executa aquisição e comando do aquecedor; a segunda é reserva. As quantidades podem ser reduzidas conforme o material disponível. O CM5 pode receber dados posteriormente; não é necessário comprar outro CM5 para começar os ensaios pela USB do computador.
Alimentação do ensaio | Usar a fonte ajustável inicialmente em 12 V, com limitação de corrente. Os três XL4015 separam os ajustes do TEC, do aquecedor e da carga de diodos. A Pico recebe alimentação USB e fornece 3,3 V à parte de medição, dentro da capacidade disponível. Não aplicar 12 V ou 15 V aos GPIOs, ao ADC, à USB ou ao pino 3V3 da Pico.
Conjunto térmico | O TEC transfere calor da carga para o dissipador. A ventoinha ajuda o dissipador a liberar esse calor para o ar. A potência que precisa ser dissipada inclui o calor removido e a potência elétrica consumida pelo TEC. O código TEC1-12706 e o tamanho de 40 × 40 mm não comprovam equivalência com o TEC do laser. As três alternativas de kit têm diferenças mecânicas.
Acionamento inicial do TEC | A proposta base é começar com alimentação DC ajustável manualmente pelo XL4015 CC/CV, sem ponte H. Limitar inicialmente a corrente do ramo a até 2 A e acompanhar a temperatura do dissipador; esse limite é uma condição de ensaio proposta, não uma especificação do laser. A fonte de 5 A e os fusíveis de 3 A não foram dimensionados para explorar a corrente máxima anunciada de 6 A do TEC.
Controle automático do TEC | O BTS7960 foi deixado com quantidade zero, como alternativa para estudo. Um driver de motor não equivale a um controlador TEC de precisão. A passagem para controle automático requer dimensionamento da etapa de potência, filtragem, medição de corrente e malha de temperatura. PWM sem filtragem não foi adotado como solução final do TEC; o guia da Coherent discute ondulação e filtragem na alimentação.
Sensor e condicionamento | Para cada NTC, a proposta é um divisor com resistor de 10 kΩ, alimentado em 3,3 V: resistor fixo no ramo superior e NTC no inferior. A tensão no ponto central diminui quando o NTC aquece. O ADC mede essa tensão; o firmware converte resistência em temperatura usando os parâmetros corretos do sensor. Os capacitores de 100 nF auxiliam a filtragem e o desacoplamento.
Leitura pelo ADS1115 | O ADS1115 permite quatro entradas multiplexadas e comunicação I²C. Pode-se reservar duas entradas para os NTCs e um par diferencial para o shunt, lidos em sequência. Alimentação e pull-ups em 3,3 V mantêm os sinais compatíveis com a Pico. Cada entrada deve permanecer dentro dos limites do ADC; selecionar uma escala de ganho maior não autoriza tensão acima da alimentação. Não se trata de quatro amostragens simultâneas.
Aquecedor que imita o laser | O resistor de 10 Ω transforma energia elétrica em calor. Em 5 V, os valores nominais calculados são I = 5/10 = 0,5 A e P = 5²/10 = 2,5 W. A indicação 20 W é a potência nominal do componente sob suas condições de uso, não o consumo obrigatório. O MOSFET controla a potência média por PWM. Fixar o aquecedor à massa térmica do ensaio com isolamento elétrico apropriado.
Carga de três diodos | Ligar três 1N5408 em série forma uma carga para estudar o fornecimento de corrente. O XL4015 CC/CV permite um primeiro ajuste manual. Propõe-se começar em 0,2 A, valor de ensaio e não corrente nominal do laser. A queda nos diodos varia com corrente e temperatura. A carga não reproduz luz, eficiência óptica ou todos os transientes de um laser; um módulo CC/CV genérico não é um driver aprovado para o laser real.
Ponto de medição de corrente | Com um shunt de 1 Ω, I = Vshunt / 1 Ω. Em 0,2 A, calculam-se 0,2 V e 0,04 W no resistor. Esses são cálculos nominais, não resultados medidos. A tolerância de 5% e a exatidão do ADC afetam a medida. Módulos CC/CV podem medir corrente no retorno: não unir IN− e OUT− externamente sem verificar o circuito, pois isso pode desviar o resistor de medição do regulador.
Sequência de montagem | Primeiro, verificar Pico, ADC e NTCs pela USB. Depois, ensaiar separadamente o aquecedor em 5 V, a carga de diodos com corrente limitada e o conjunto TEC já preso ao dissipador com ventilação. Só então reunir os ramos. As conexões de potência devem ser soldadas ou feitas por bornes apropriados; protoboard e jumpers ficam reservados à eletrônica de medição e aos sinais.
Ligação com a placa R6 | A entrada externa de duas vias da placa R6 permanece associada aos 15 V do projeto. J103 disponibiliza a interface I²C e a linha interna de 3,3 V; não exige uma fonte externa de 3,3 V. J104 é a interface de ventilação de 5 V do projeto: os ventiladores de 12 V desta bancada não devem ser conectados diretamente ali. BIAS_F e BIAS_OUT são sinais do controle do MZM e não alimentações para TEC, aquecedor ou laser.
Mecânica e instrumentos | O suporte da carga, os pontos de fixação dos sensores e o isolamento do aquecedor dependem do kit escolhido. Confirmar se pasta térmica, parafusos e cabos da fonte acompanham a oferta. Esses complementos específicos, solda e instrumentos (multímetro, osciloscópio e termômetro de referência) não foram precificados. A lista não presume que o laboratório já os possui.
Antes da compra para o laser | Para substituir a bancada didática pelo conjunto equivalente ao laser, faltam a identificação exata do laser e os dados do TEC: dimensões, tensão, corrente, carga térmica e faixa de temperatura. Também são necessários os dados do sensor e a corrente de operação do laser. Essas informações alteram principalmente os itens 02, 03, 04, 12 e 13. A proposta de ensaio não deve ser apresentada como validação desses componentes para o laser real.
Leitura do orçamento | O subtotal soma apenas preços conhecidos da opção selecionada. O aquecedor está com preço pendente. Frete, eventuais pedidos mínimos, consumíveis de montagem e instrumentos adicionais não entram nesse subtotal. Estoque e preços são os anunciados nas páginas consultadas, sujeitos a alteração; não foram feitas compras nem reservas. Links de marketplace podem ser do mesmo vendedor de outra opção.
Fonte técnica — Raspberry Pi | Documentação oficial da família Pico: alimentação, interfaces e pinagem. https://www.raspberrypi.com/documentation/microcontrollers/pico-series.html — Datasheet: https://datasheets.raspberrypi.com/pico/pico-datasheet.pdf
Fonte técnica — Texas Instruments | ADS1115: conversor de 16 bits, quatro entradas multiplexadas, I²C e alimentação de 2 a 5,5 V. Usado aqui para sinais lentos da bancada. https://www.ti.com/product/ADS1115
Fonte técnica — Coherent | Thermoelectric Cooling Systems Design Guide: dimensionamento, dissipação, alimentação DC, ondulação, controle e montagem de TECs. https://www.coherent.com/resources/datasheet/materials/related-resources/thermoelectrics/thermoelectric-cooling-systems-design-guide-br.pdf
Rastreabilidade do projeto
