CarloRenan/CM5-RP2040-MZM/hardware/altium/ALTIUM_EMBEDDED_MODELS/SOT26_DIO.step

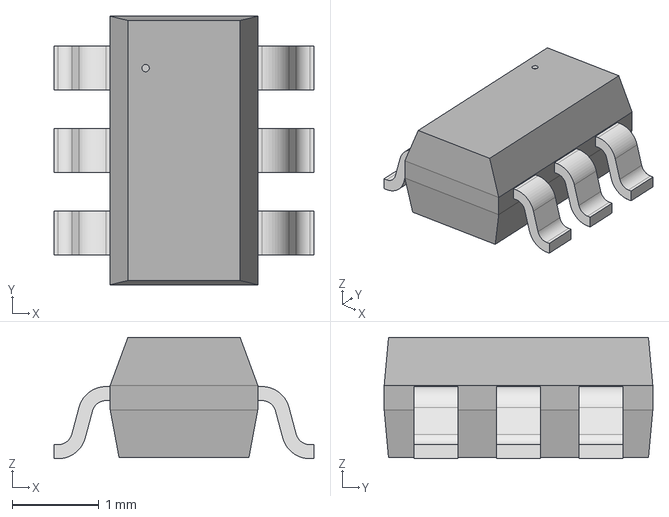
[picture p94: CAD file, 2026-10-18]
hardware/altium/ALTIUM_EMBEDDED_MODELS/SOT26_DIO.step
3.00 x 3.10 x 1.40 mm
