CarloRenan/CM5-RP2040-MZM/hardware/altium/Modelos3D_Pico/Pico_TH40_headers_R4.step

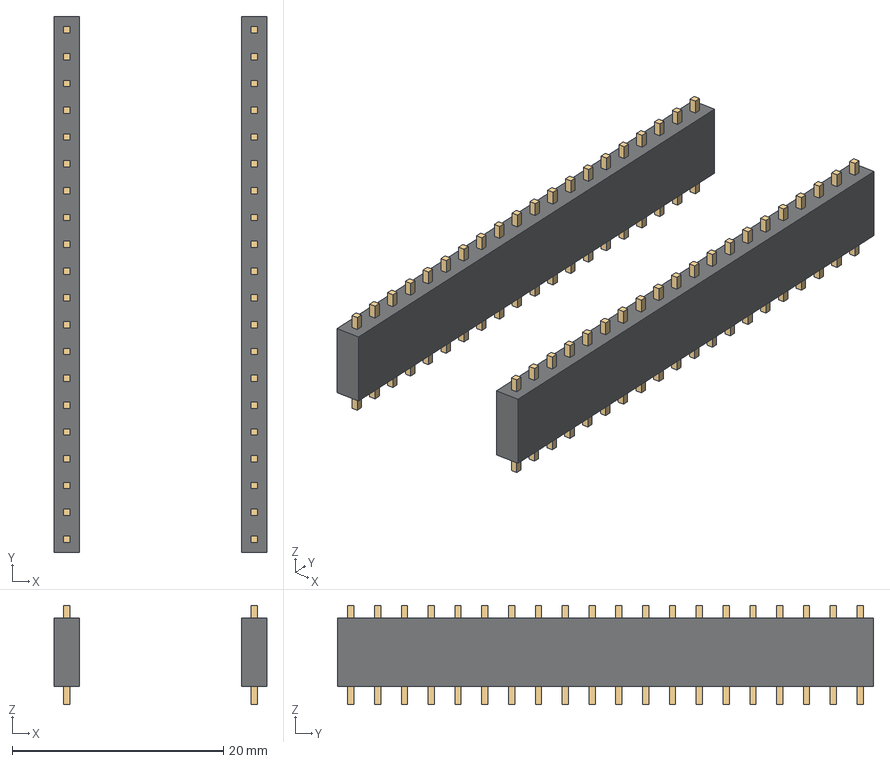
[picture p95: CAD file, 2026-10-18]
hardware/altium/Modelos3D_Pico/Pico_TH40_headers_R4.step
20.2 x 50.8 x 9.40 mm
original_R4_1
original_R4_2
original_R4_3
original_R4_4
original_R4_5
original_R4_6
original_R4_7
original_R4_8
original_R4_9
original_R4_10
original_R4_11
original_R4_12
original_R4_13
original_R4_14
original_R4_15
original_R4_16
original_R4_17
original_R4_18
original_R4_19
original_R4_20
original_R4_21
original_R4_22
original_R4_23
original_R4_24
original_R4_25
original_R4_26
original_R4_27
original_R4_28
original_R4_29
original_R4_30
original_R4_31
original_R4_32
original_R4_33
original_R4_34
original_R4_35
original_R4_36
original_R4_37
original_R4_38
original_R4_39
original_R4_40
original_R4_41
original_R4_42
