CarloRenan/CM5-RP2040-MZM/hardware/altium/Modelos3D_R5/Conector_5447861.step

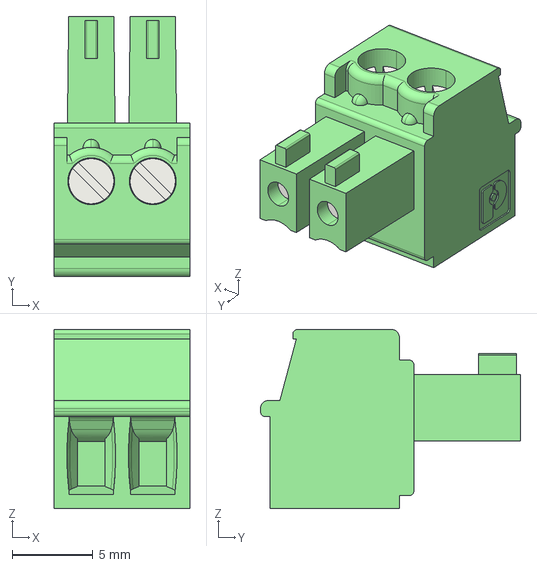
[picture p96: CAD file, 2026-10-18]
hardware/altium/Modelos3D_R5/Conector_5447861.step
8.41 x 16.1 x 11.1 mm
