CarloRenan/CM5-RP2040-MZM/hardware/altium/ALTIUM_EMBEDDED_MODELS/C1210.step

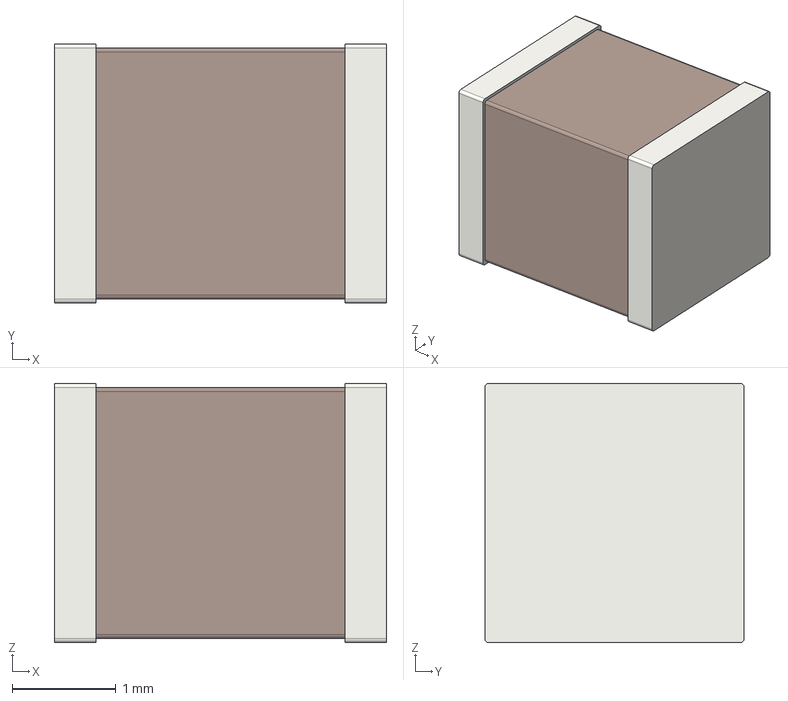
[picture p97: CAD file, 2026-10-18]
hardware/altium/ALTIUM_EMBEDDED_MODELS/C1210.step
3.20 x 2.50 x 2.50 mm
