CarloRenan/CM5-RP2040-MZM/hardware/altium/Modelos3D_Pico/Pico_W_SC0918_usuario.step

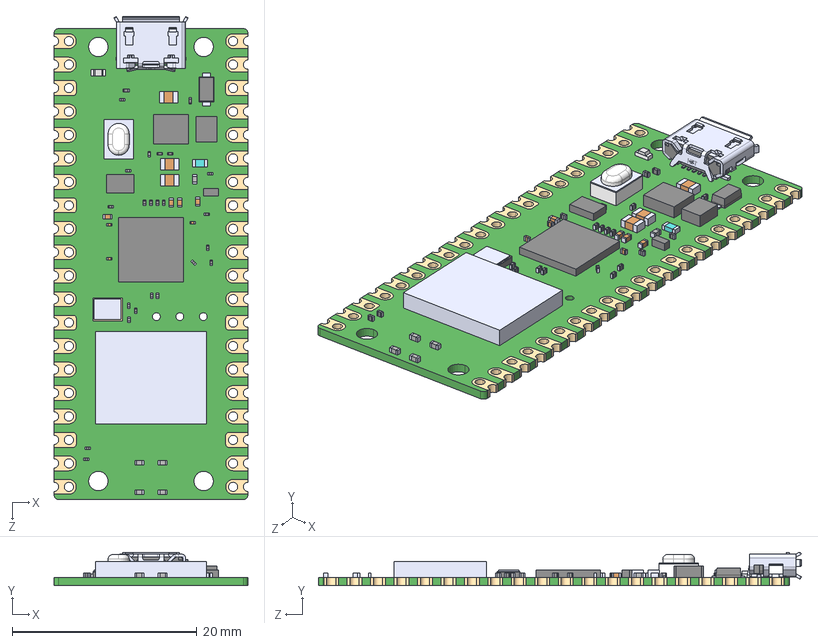
[picture p98: CAD file, 2026-10-18]
hardware/altium/Modelos3D_Pico/Pico_W_SC0918_usuario.step
21.0 x 3.60 x 52.3 mm
