CarloRenan/CM5-RP2040-MZM/hardware/altium/Modelos3D_R5/Conector_5444262.step

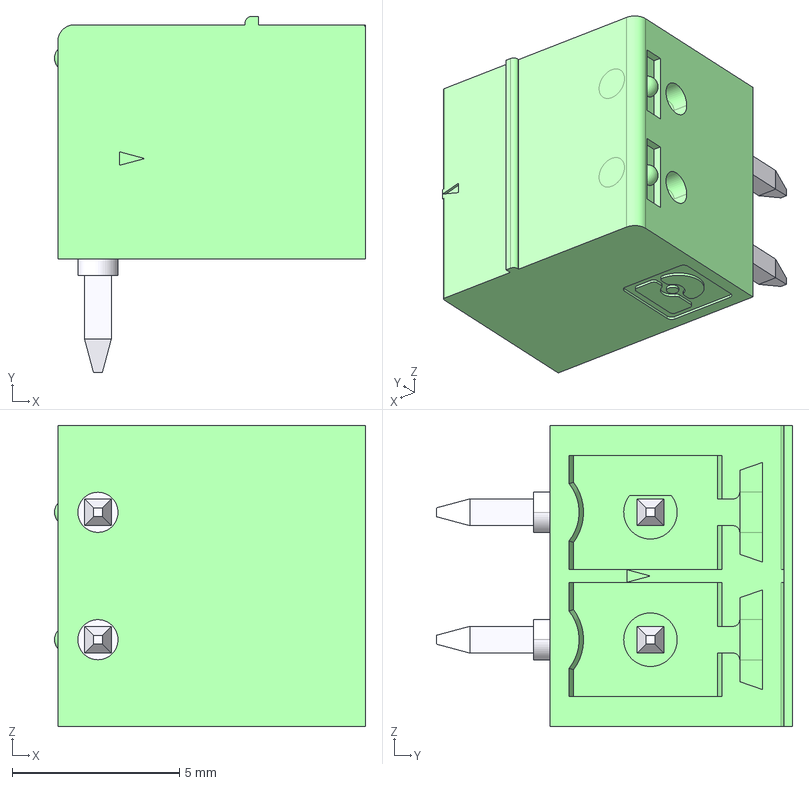
[picture p99: CAD file, 2026-10-18]
hardware/altium/Modelos3D_R5/Conector_5444262.step
9.30 x 10.7 x 9.01 mm
