CarloRenan/CM5-RP2040-MZM/hardware/altium/ALTIUM_EMBEDDED_MODELS/SOT23_5.step

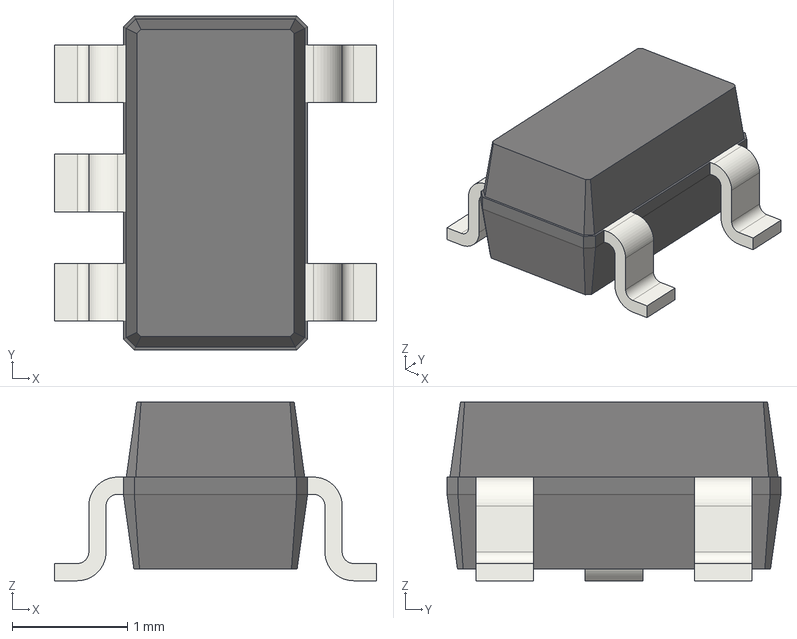
[picture p100: CAD file, 2026-10-18]
hardware/altium/ALTIUM_EMBEDDED_MODELS/SOT23_5.step
2.80 x 2.90 x 1.55 mm
