CarloRenan/CM5-RP2040-MZM/hardware/altium/Modelos3D_R5/TMR3_SIP8_envelope.step

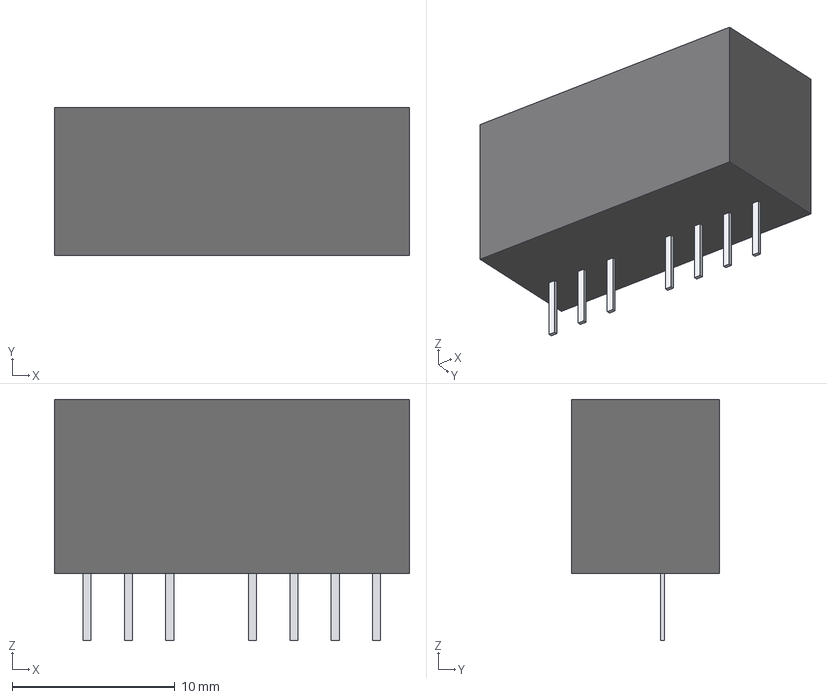
[picture p101: CAD file, 2026-10-18]
hardware/altium/Modelos3D_R5/TMR3_SIP8_envelope.step
21.8 x 9.10 x 14.8 mm
Envelope_TMR3_datasheet
Pin_1
Pin_2
Pin_3
Pin_5
Pin_6
Pin_7
Pin_8
