CarloRenan/CM5-RP2040-MZM/hardware/altium/ALTIUM_EMBEDDED_MODELS/C0805.step

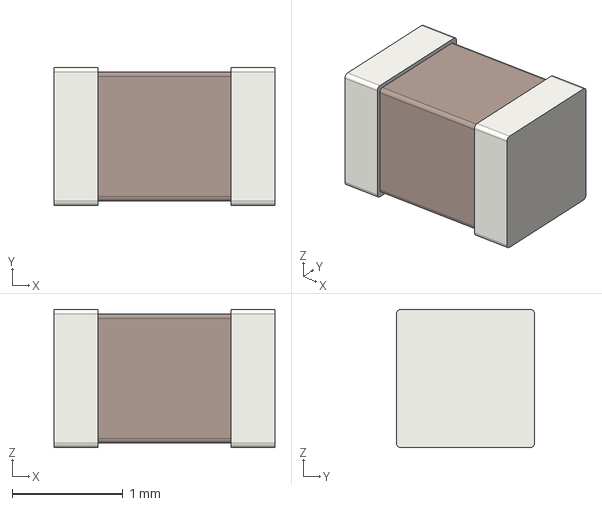
[picture p102: CAD file, 2026-10-18]
hardware/altium/ALTIUM_EMBEDDED_MODELS/C0805.step
2.00 x 1.25 x 1.25 mm
