CarloRenan/CM5-RP2040-MZM/hardware/altium/ALTIUM_EMBEDDED_MODELS/HDR_1X04_P254.step

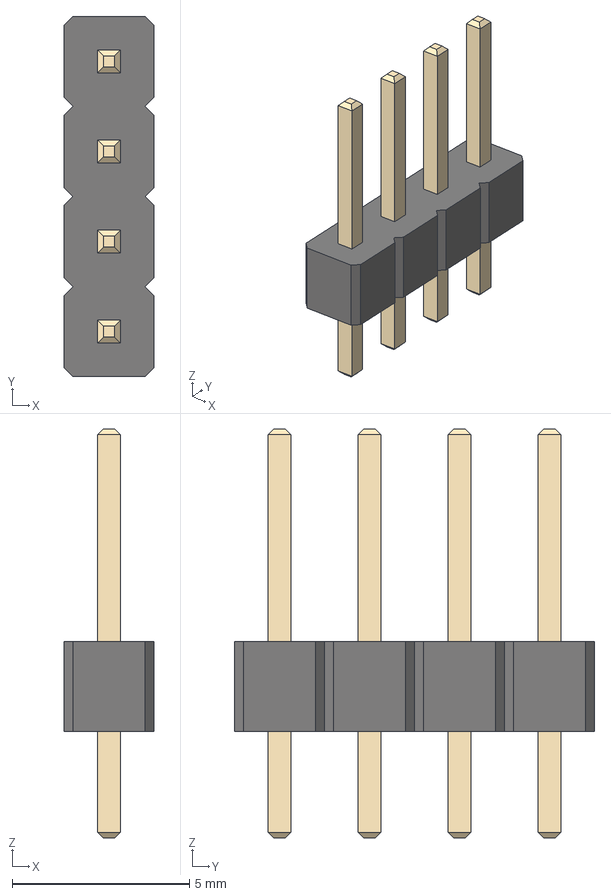
[picture p103: CAD file, 2026-10-18]
hardware/altium/ALTIUM_EMBEDDED_MODELS/HDR_1X04_P254.step
2.54 x 10.2 x 11.5 mm
