CarloRenan/CM5-RP2040-MZM/hardware/altium/ALTIUM_EMBEDDED_MODELS/SOD-123.stp

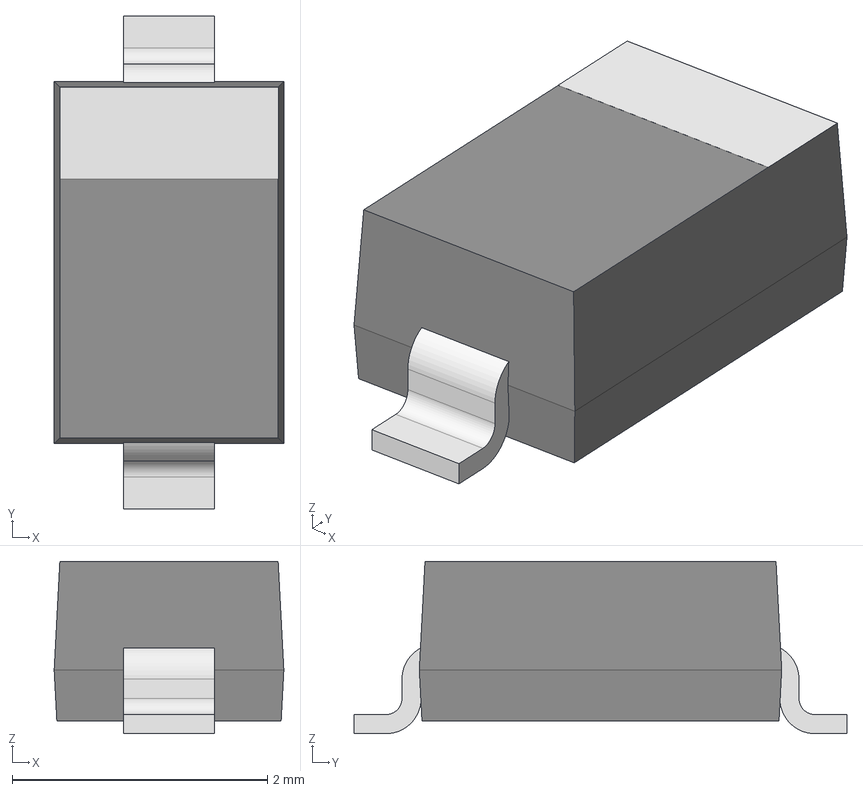
[picture p104: CAD file, 2026-10-18]
hardware/altium/ALTIUM_EMBEDDED_MODELS/SOD-123.stp
1.80 x 3.86 x 1.35 mm
