CarloRenan/CM5-RP2040-MZM/hardware/altium/ALTIUM_EMBEDDED_MODELS/XTAL_HC49.step

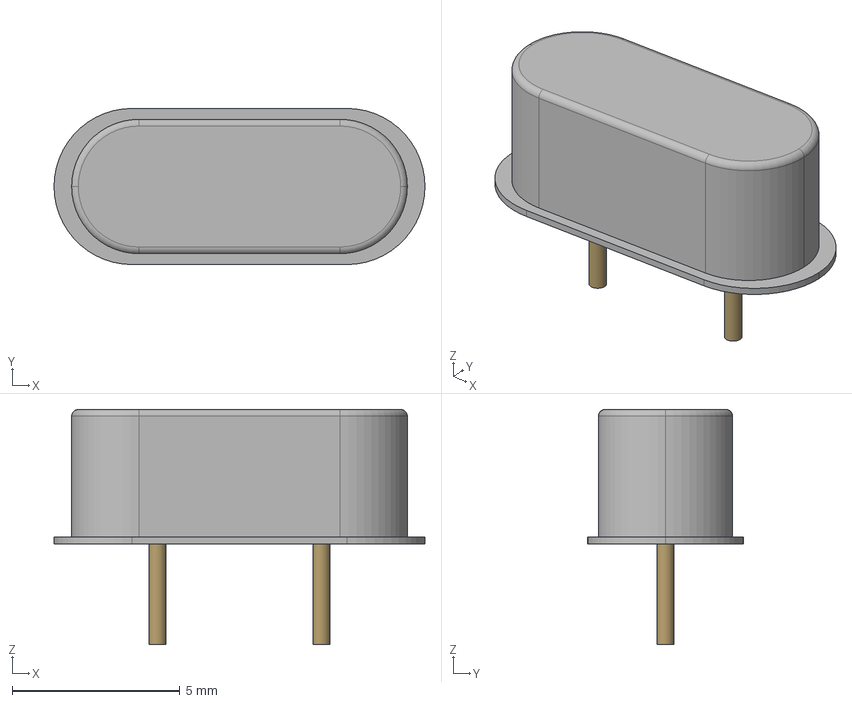
[picture p105: CAD file, 2026-10-18]
hardware/altium/ALTIUM_EMBEDDED_MODELS/XTAL_HC49.step
11.1 x 4.65 x 7.00 mm
