CarloRenan/CM5-RP2040-MZM/hardware/altium/ALTIUM_EMBEDDED_MODELS/USB_C_12401610.step

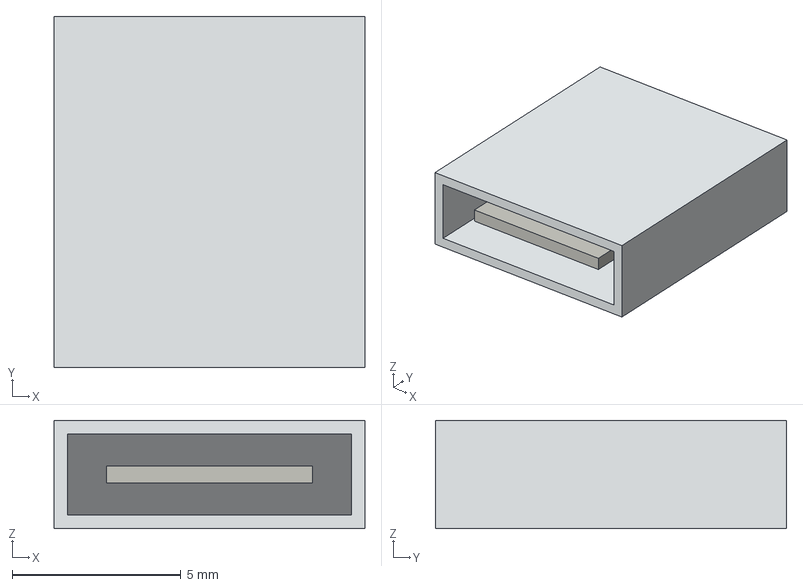
[picture p106: CAD file, 2026-10-18]
hardware/altium/ALTIUM_EMBEDDED_MODELS/USB_C_12401610.step
9.20 x 10.4 x 3.20 mm
