CarloRenan/CM5-RP2040-MZM/hardware/altium/ALTIUM_EMBEDDED_MODELS/MKDS_3_P508.step

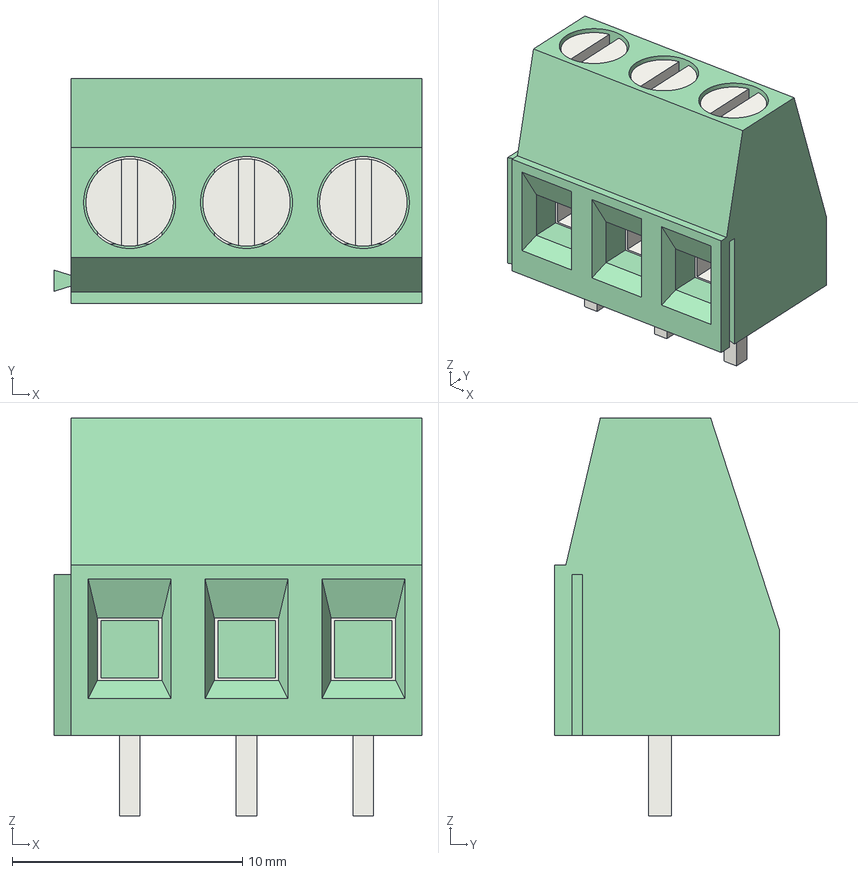
[picture p107: CAD file, 2026-10-18]
hardware/altium/ALTIUM_EMBEDDED_MODELS/MKDS_3_P508.step
16.0 x 9.80 x 17.3 mm
