CarloRenan/CM5-RP2040-MZM/hardware/altium/ALTIUM_EMBEDDED_MODELS/SOIC14.step

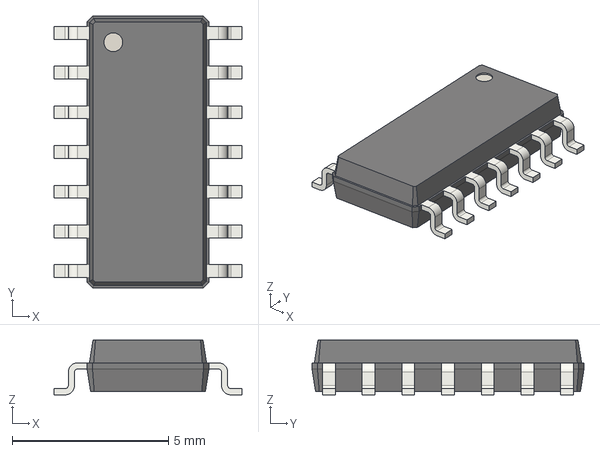
[picture p108: CAD file, 2026-10-18]
hardware/altium/ALTIUM_EMBEDDED_MODELS/SOIC14.step
6.00 x 8.70 x 1.75 mm
