CarloRenan/CM5-RP2040-MZM/hardware/altium/ALTIUM_EMBEDDED_MODELS/SOIC8.step

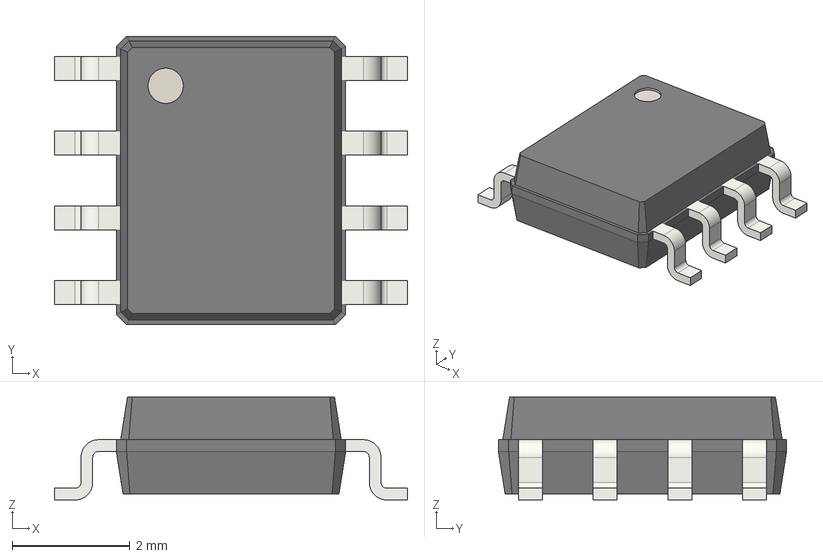
[picture p109: CAD file, 2026-10-18]
hardware/altium/ALTIUM_EMBEDDED_MODELS/SOIC8.step
6.00 x 4.90 x 1.75 mm
