CarloRenan/CM5-RP2040-MZM/hardware/altium/ALTIUM_EMBEDDED_MODELS/SSOP28_DB.step

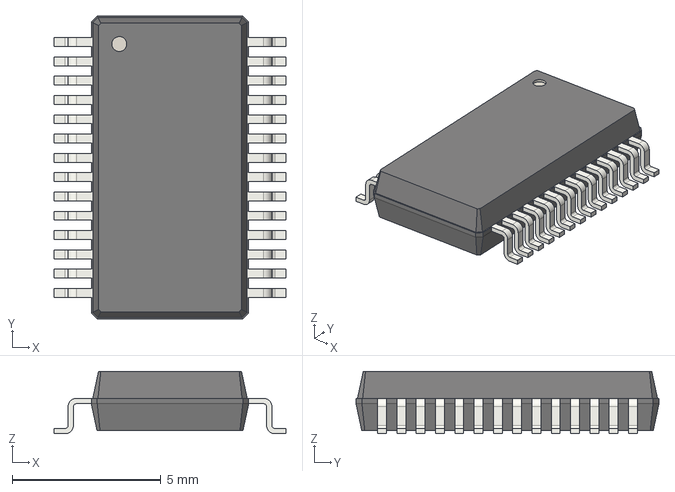
[picture p110: CAD file, 2026-10-18]
hardware/altium/ALTIUM_EMBEDDED_MODELS/SSOP28_DB.step
7.80 x 10.2 x 2.10 mm
