CarloRenan/CM5-RP2040-MZM/hardware/altium/ALTIUM_EMBEDDED_MODELS/D_SOD123.step

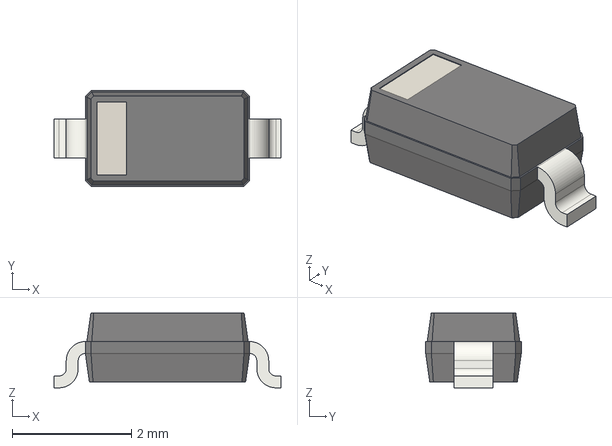
[picture p111: CAD file, 2026-10-18]
hardware/altium/ALTIUM_EMBEDDED_MODELS/D_SOD123.step
3.80 x 1.60 x 1.25 mm
