CarloRenan/CM5-RP2040-MZM/hardware/altium/ALTIUM_EMBEDDED_MODELS/CM5_BERG100.step

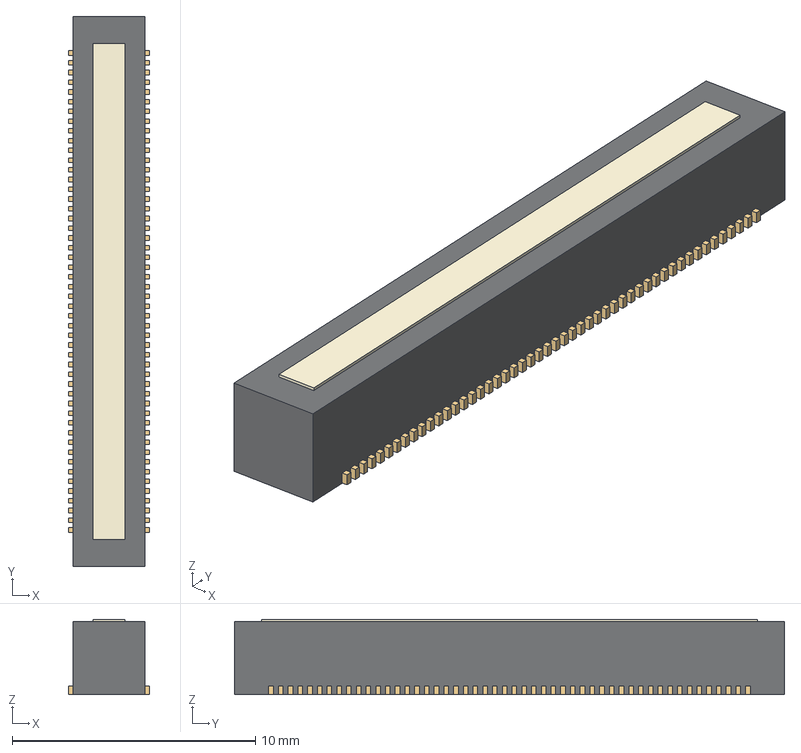
[picture p112: CAD file, 2026-10-18]
hardware/altium/ALTIUM_EMBEDDED_MODELS/CM5_BERG100.step
3.31 x 22.6 x 3.09 mm
