CarloRenan/CM5-RP2040-MZM/hardware/altium/ALTIUM_EMBEDDED_MODELS/CM5_Envelope.step

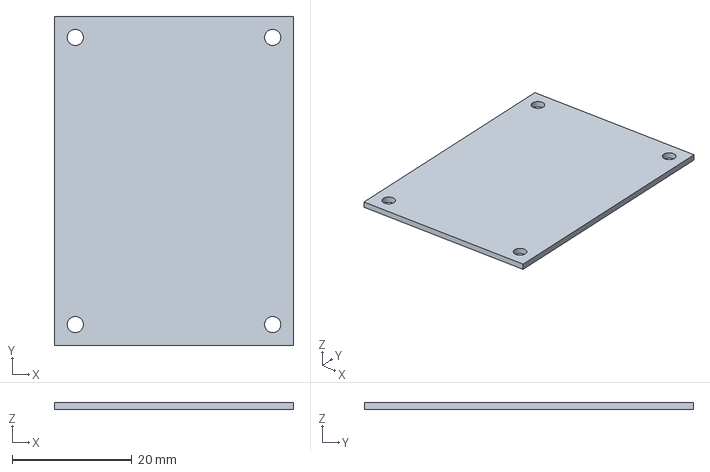
[picture p113: CAD file, 2026-10-18]
hardware/altium/ALTIUM_EMBEDDED_MODELS/CM5_Envelope.step
40.0 x 55.0 x 1.20 mm
