CarloRenan/CM5-RP2040-MZM/hardware/altium/ALTIUM_EMBEDDED_MODELS/SOT23_6.step

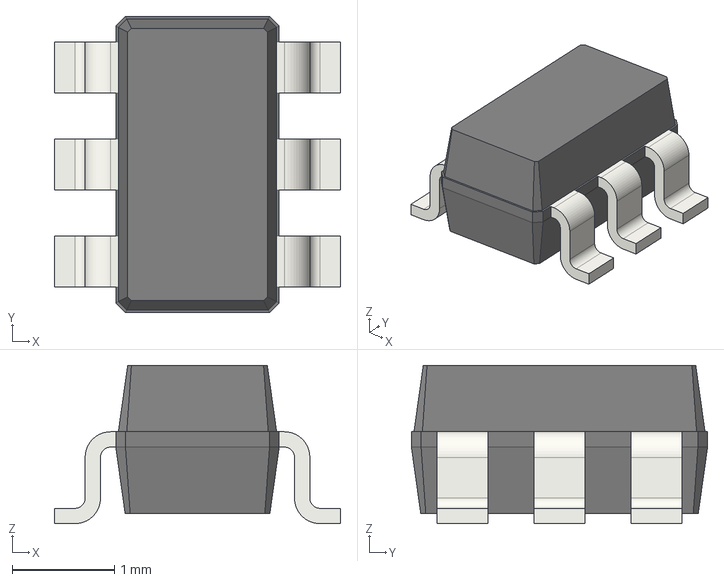
[picture p115: CAD file, 2026-10-18]
hardware/altium/ALTIUM_EMBEDDED_MODELS/SOT23_6.step
2.80 x 2.90 x 1.55 mm
