CarloRenan/CM5-RP2040-MZM/hardware/altium/ALTIUM_EMBEDDED_MODELS/R1206.step

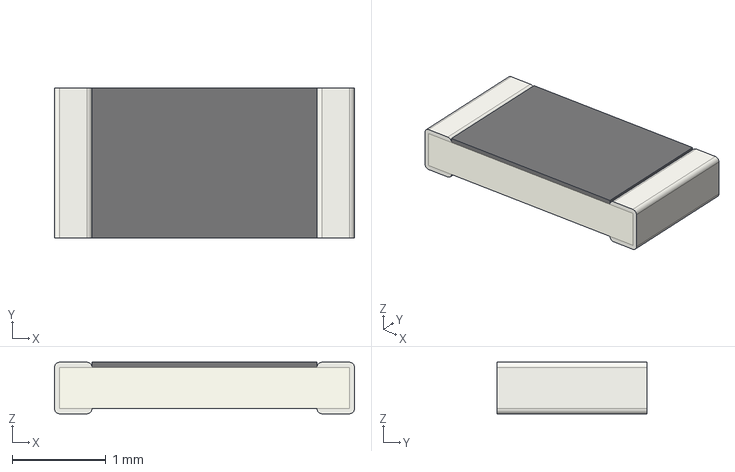
[picture p116: CAD file, 2026-10-18]
hardware/altium/ALTIUM_EMBEDDED_MODELS/R1206.step
3.20 x 1.60 x 0.55 mm
