CarloRenan/CM5-RP2040-MZM/hardware/altium/ALTIUM_EMBEDDED_MODELS/TANT_D.step

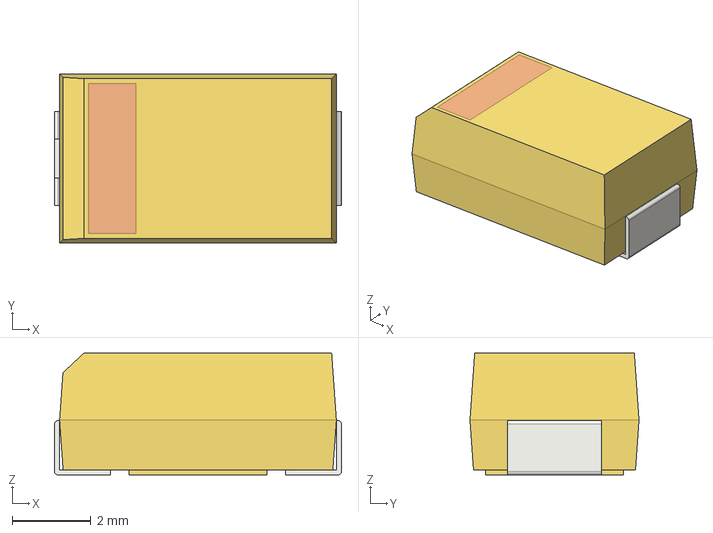
[picture p117: CAD file, 2026-10-18]
hardware/altium/ALTIUM_EMBEDDED_MODELS/TANT_D.step
7.30 x 4.30 x 3.10 mm
