CarloRenan/CM5-RP2040-MZM/hardware/altium/ALTIUM_EMBEDDED_MODELS/SMA_132134.step

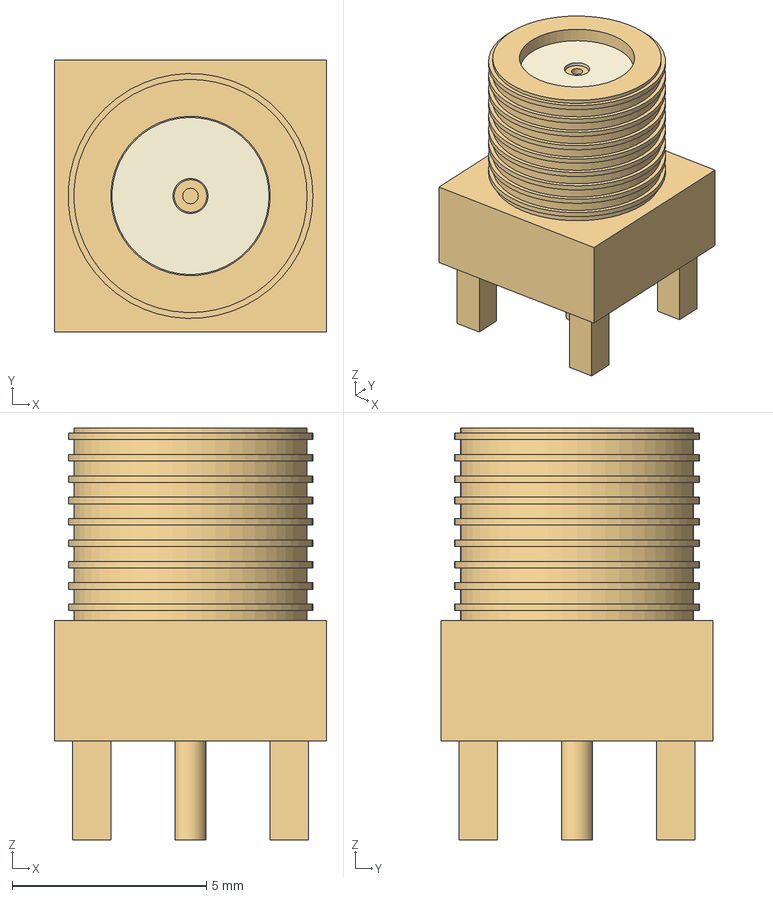
[picture p118: CAD file, 2026-10-18]
hardware/altium/ALTIUM_EMBEDDED_MODELS/SMA_132134.step
7.00 x 7.00 x 10.6 mm
