CarloRenan/CM5-RP2040-MZM/hardware/altium/ALTIUM_EMBEDDED_MODELS/HIROSE_UFL.step

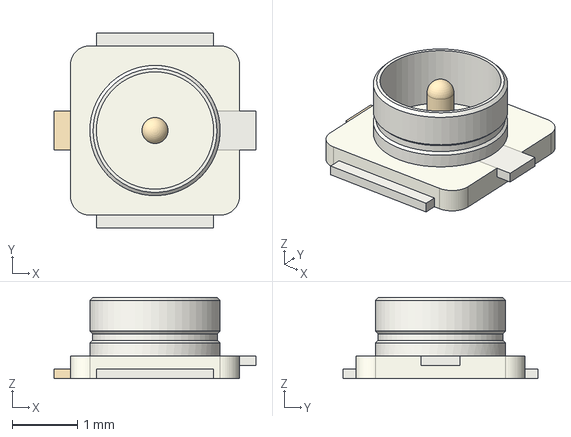
[picture p119: CAD file, 2026-10-18]
hardware/altium/ALTIUM_EMBEDDED_MODELS/HIROSE_UFL.step
3.10 x 3.00 x 1.25 mm
