CarloRenan/CM5-RP2040-MZM/hardware/altium/ALTIUM_EMBEDDED_MODELS/XAL7070.step

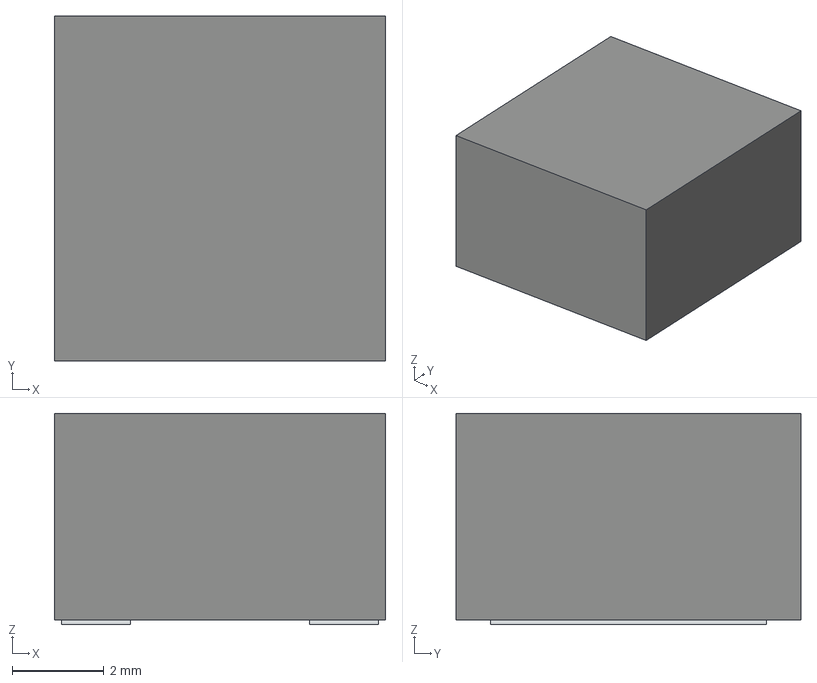
[picture p120: CAD file, 2026-10-18]
hardware/altium/ALTIUM_EMBEDDED_MODELS/XAL7070.step
7.20 x 7.50 x 4.60 mm
