CarloRenan/CM5-RP2040-MZM/hardware/altium/ALTIUM_EMBEDDED_MODELS/SW_TL3305A.step

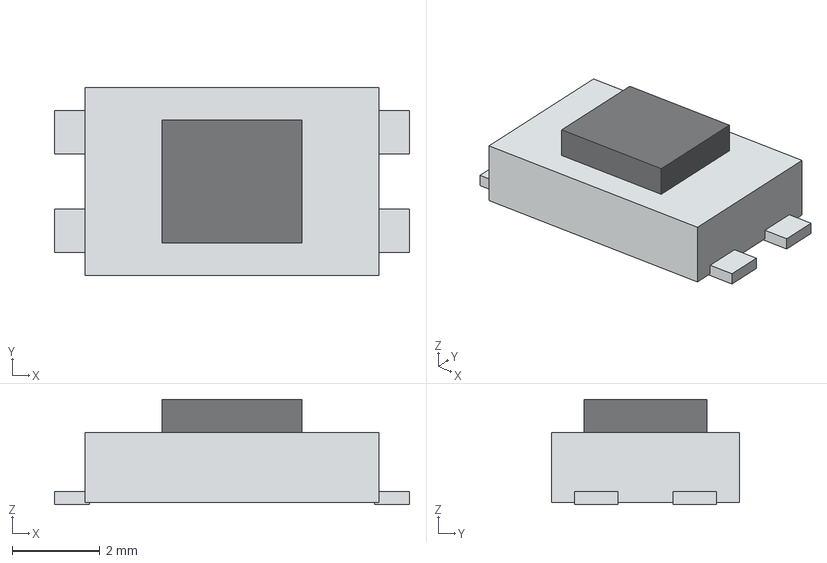
[picture p121: CAD file, 2026-10-18]
hardware/altium/ALTIUM_EMBEDDED_MODELS/SW_TL3305A.step
8.10 x 4.30 x 2.40 mm
