CarloRenan/CM5-RP2040-MZM/hardware/altium/ALTIUM_EMBEDDED_MODELS/SOT95P240X115-3M.step

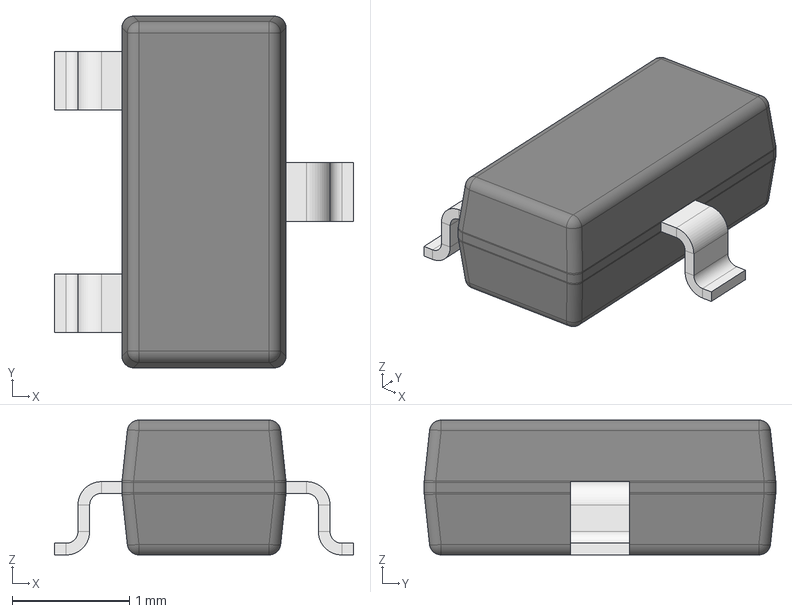
[picture p122: CAD file, 2026-10-18]
hardware/altium/ALTIUM_EMBEDDED_MODELS/SOT95P240X115-3M.step
2.55 x 3.00 x 1.15 mm
Leader x 3
