CarloRenan/CM5-RP2040-MZM/hardware/altium/ALTIUM_EMBEDDED_MODELS/SOT23.step

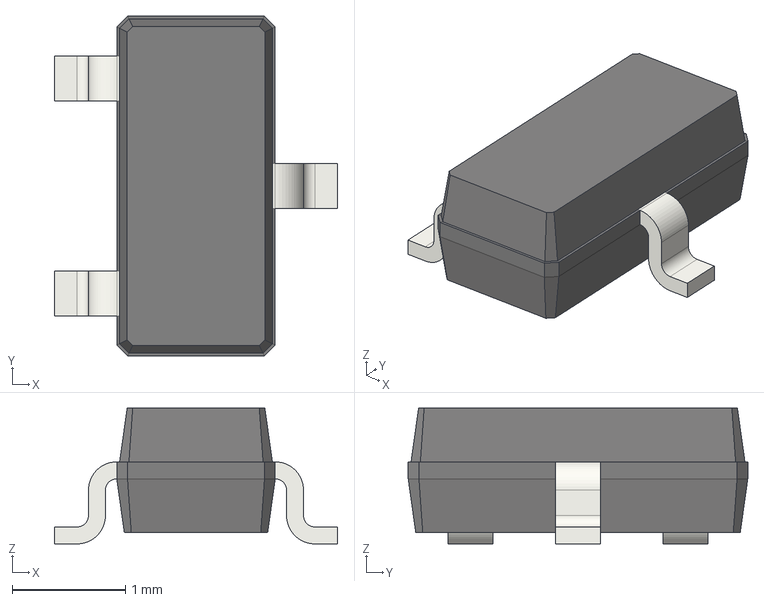
[picture p123: CAD file, 2026-10-18]
hardware/altium/ALTIUM_EMBEDDED_MODELS/SOT23.step
2.50 x 3.00 x 1.20 mm
