CarloRenan/CM5-RP2040-MZM/hardware/altium/ALTIUM_EMBEDDED_MODELS/SOT-23-5_MC_MCH.step

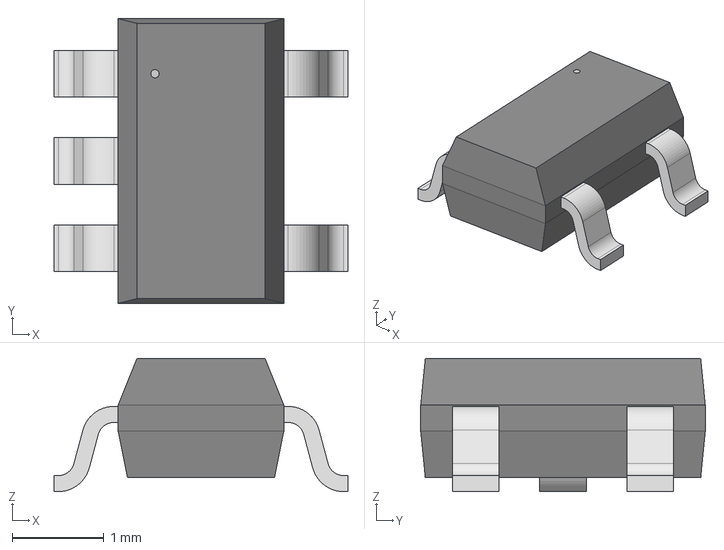
[picture p124: CAD file, 2026-10-18]
hardware/altium/ALTIUM_EMBEDDED_MODELS/SOT-23-5_MC_MCH.step
3.20 x 3.10 x 1.45 mm
