CarloRenan/CM5-RP2040-MZM/hardware/altium/ALTIUM_EMBEDDED_MODELS/D_SMA.step

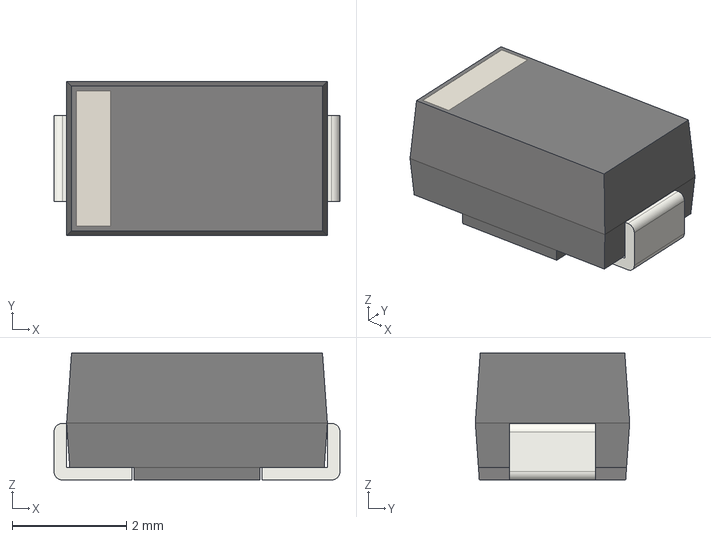
[picture p125: CAD file, 2026-10-18]
hardware/altium/ALTIUM_EMBEDDED_MODELS/D_SMA.step
5.00 x 2.70 x 2.22 mm
