CarloRenan/CM5-RP2040-MZM/hardware/altium/ALTIUM_EMBEDDED_MODELS/D_SMB.step

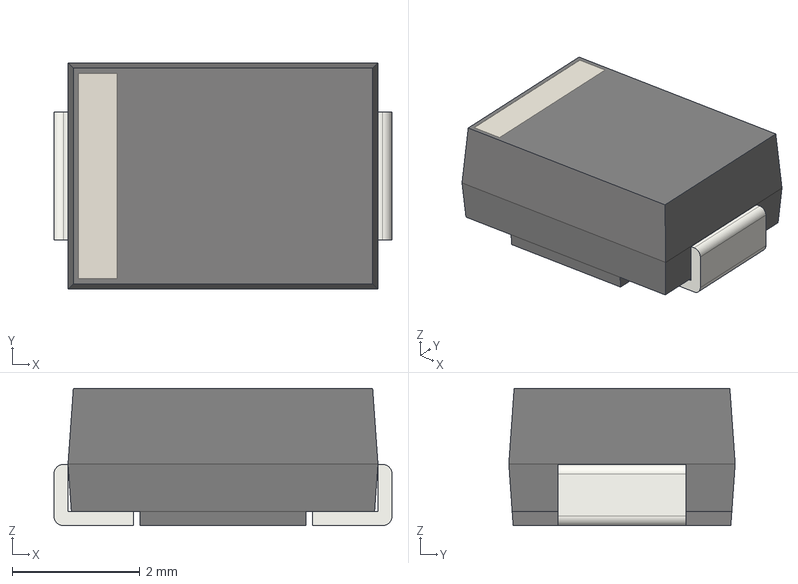
[picture p126: CAD file, 2026-10-18]
hardware/altium/ALTIUM_EMBEDDED_MODELS/D_SMB.step
5.30 x 3.55 x 2.15 mm
