CarloRenan/CM5-RP2040-MZM/hardware/altium/ALTIUM_EMBEDDED_MODELS/FUSE_NANO2.step

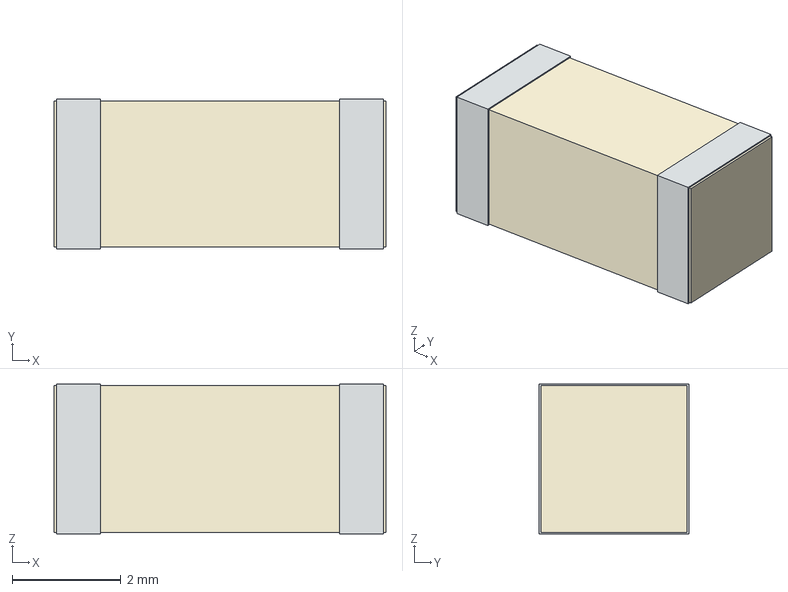
[picture p127: CAD file, 2026-10-18]
hardware/altium/ALTIUM_EMBEDDED_MODELS/FUSE_NANO2.step
6.10 x 2.75 x 2.75 mm
