CarloRenan/CM5-RP2040-MZM/hardware/altium/ALTIUM_EMBEDDED_MODELS/R0603.step

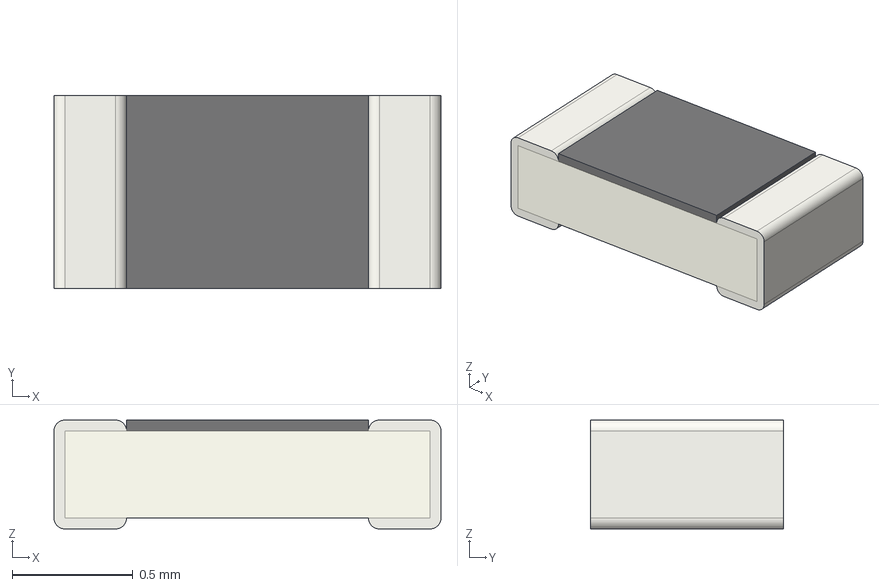
[picture p128: CAD file, 2026-10-18]
hardware/altium/ALTIUM_EMBEDDED_MODELS/R0603.step
1.60 x 0.8 x 0.45 mm
