CarloRenan/CM5-RP2040-MZM/hardware/altium/ALTIUM_EMBEDDED_MODELS/TO220_3.step

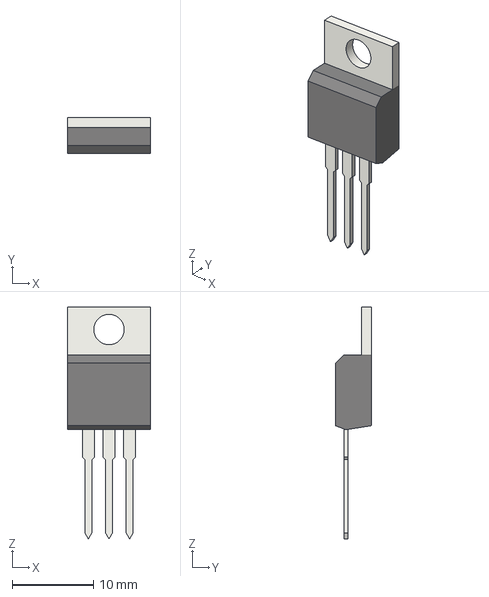
[picture p129: CAD file, 2026-10-18]
hardware/altium/ALTIUM_EMBEDDED_MODELS/TO220_3.step
10.2 x 4.46 x 28.5 mm
