CarloRenan/CM5-RP2040-MZM/hardware/altium/ALTIUM_EMBEDDED_MODELS/User Library-Chip Resistor_0603 (1608).step

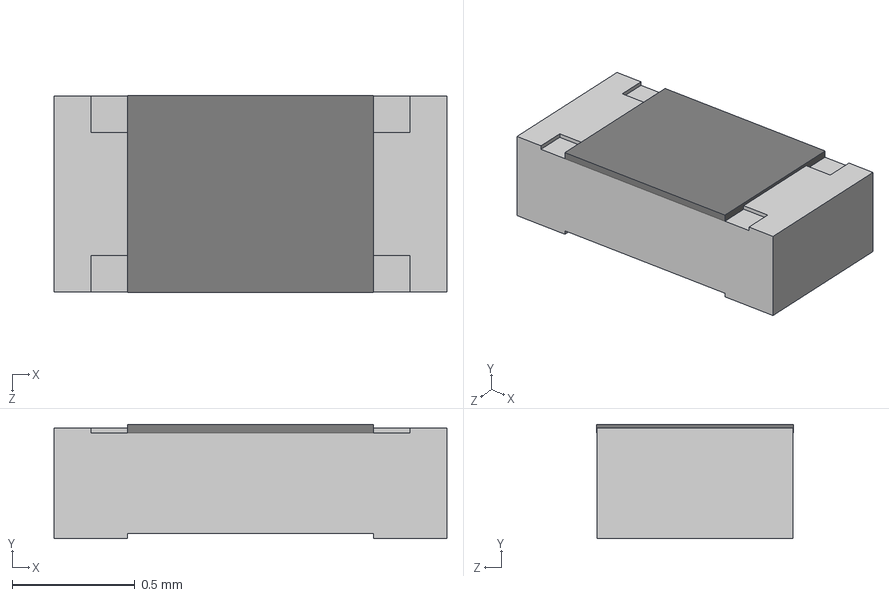
[picture p131: CAD file, 2026-10-18]
hardware/altium/ALTIUM_EMBEDDED_MODELS/User Library-Chip Resistor_0603 (1608).step
1.60 x 0.465 x 0.802 mm
