CarloRenan/CM5-RP2040-MZM/hardware/altium/ALTIUM_EMBEDDED_MODELS/User Library-DO-214AC SMA.step

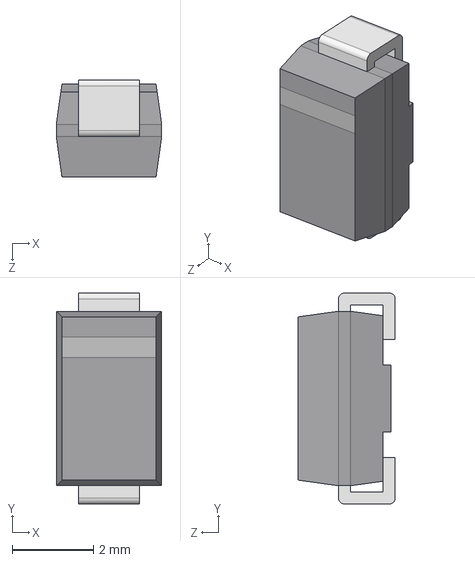
[picture p132: CAD file, 2026-10-18]
hardware/altium/ALTIUM_EMBEDDED_MODELS/User Library-DO-214AC SMA.step
2.60 x 5.20 x 2.40 mm
