CarloRenan/CM5-RP2040-MZM/hardware/altium/ALTIUM_EMBEDDED_MODELS/HDR_1X02_P254.step

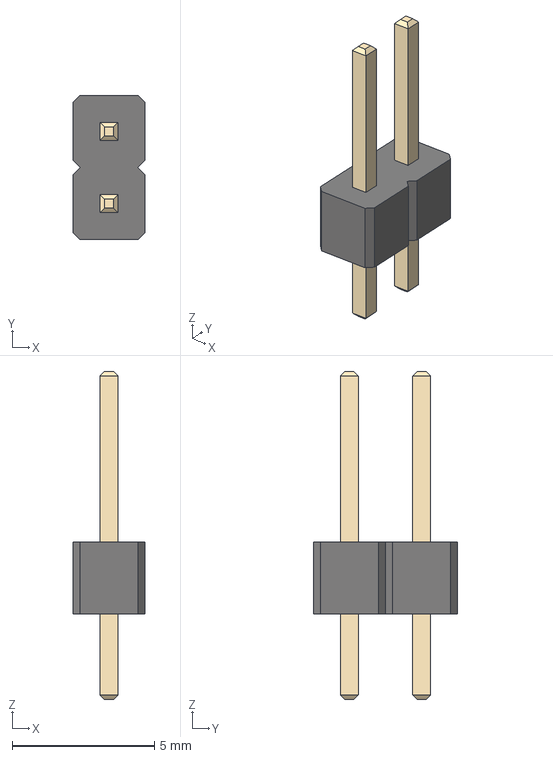
[picture p133: CAD file, 2026-10-18]
hardware/altium/ALTIUM_EMBEDDED_MODELS/HDR_1X02_P254.step
2.54 x 5.08 x 11.5 mm
