CarloRenan/CM5-RP2040-MZM/hardware/altium/ALTIUM_EMBEDDED_MODELS/D_DO41_P10.step

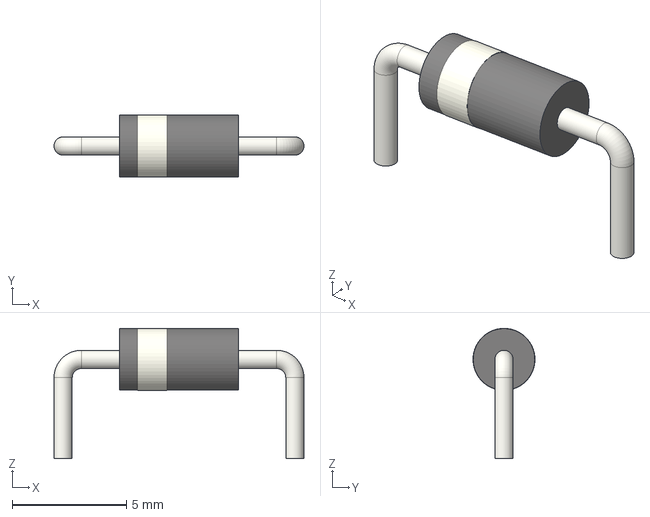
[picture p134: CAD file, 2026-10-18]
hardware/altium/ALTIUM_EMBEDDED_MODELS/D_DO41_P10.step
11.0 x 2.72 x 5.71 mm
