CarloRenan/CM5-RP2040-MZM/hardware/altium/ALTIUM_EMBEDDED_MODELS/G6K_2F_Y.step

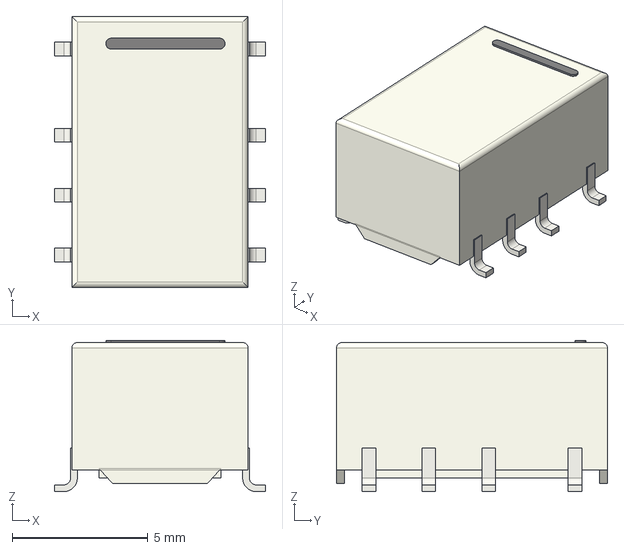
[picture p135: CAD file, 2026-10-18]
hardware/altium/ALTIUM_EMBEDDED_MODELS/G6K_2F_Y.step
7.80 x 10.0 x 5.58 mm
