CarloRenan/CM5-RP2040-MZM/hardware/altium/ALTIUM_EMBEDDED_MODELS/User Library-DO-214AA(SMB).step

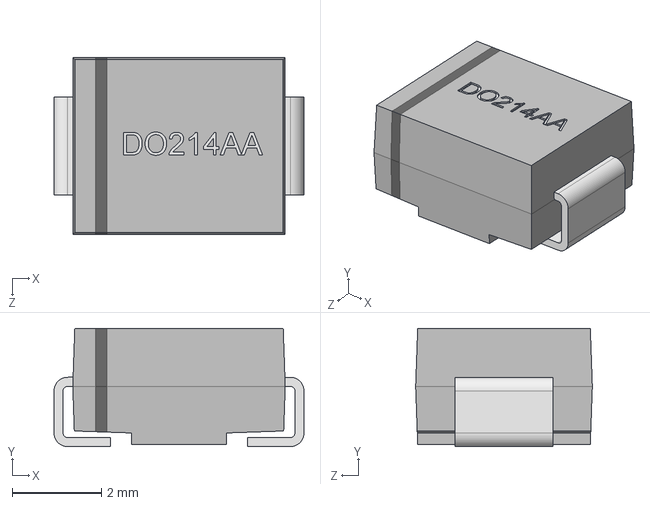
[picture p136: CAD file, 2026-10-18]
hardware/altium/ALTIUM_EMBEDDED_MODELS/User Library-DO-214AA(SMB).step
5.59 x 2.64 x 3.95 mm
