CarloRenan/CM5-RP2040-MZM/(list of files, cad)

Other CAD files:
hardware/altium/ALTIUM_EMBEDDED_MODELS/DAC80504_RTE.step
