CarloRenan/CM5-RP2040-MZM/CHANGELOG.md

# Histórico de alterações

## R6 — atualização de 17 de outubro de 2026

- Correção dos escopos das duas regras HoleSize para os oito furos mecânicos de 2,7 mm e 3,2 mm.
- Preservação da furação menor do USB-C na regra geral.
- Preservação binária de todos os fluxos do PcbDoc exceto Rules6/Data.
- Atualização dos dois relatórios com os três autores e fontes das imagens autorais.
- Substituição da fotografia de referência por um esquema próprio, mantendo a citação de Lobo (2024).
- Organização do projeto nativo, circuitos, documentos, recursos 3D e vídeo.

## R6 — revisão de 15 de outubro de 2026

O histórico técnico do pacote registra a restauração da estrutura da PcbLib, ajustes dos planos de GND, máscara das vias, regras de máscara dos componentes de passo fino e afastamento da serigrafia de J200.
