CarloRenan/CM5-RP2040-MZM/simulacoes/LTspice/01_TIA_curva_estatica.asc

C400: CV_CV; 1u
C401: CV_CV; 100n
C500: CV_CH; 100p
C501: CV_CV; 100n
C502: CV_CVL; 1u
C503: CV_CV; 100n
C504: CV_CH; 100n
C505: CV_CVL; 47n
C506: CV_CV; 100n
C507: CV_CV; 10n
IPD: CV_I; PWL(0 0 0.1 0 0.12499 0 0.125 1e-06 0.14999 1e-06 0.15 2e-06 0.17499 2e-06 0.175 3e-06 0.19999 3e-06 0.2 4e-06 0.22499 4e-06 0.225 5e-06 0.24999 5e-06 0.25 6e-06 0.27499 6e-06 0.275 7e-06 0.29999 7e-06 0.3 8e-06 0.32499 8e-06 0.325 9e-06 0.34999 9e-06 0.35 1e-05 0.37499 1e-05 0.375 1.1e-05 0.39999 1.1e-05 0.4 1.2e-05 0.42499 1.2e-05 0.425 1.3e-05 0.44999 1.3e-05 0.45 1.4e-05 0.47499 1.4e-05 0.475 1.5e-05 0.49999 1.5e-05 0.5 1.6e-05 0.52499 1.6e-05 0.525 1.7e-05 0.54999 1.7e-05 0.55 1.8e-05 0.57499 1.8e-05 0.575 1.9e-05 0.59999 1.9e-05 0.6 2e-05 0.62499 2e-05 0.625 2e-05)
R400: CV_RV; 1u
R500: CV_RH; 220k
R501: CV_RH; 90.9k
R502: CV_RV; 10.0k
R503: CV_RH; 10.0k
R504: CV_RH; 10.0k
R505: CV_RH; 100
R506: CV_RH; 10k
U500: CV_OPD; OPA380
U501: CV_OPF; OPAx197
U502: CV_OPF; OPAx197
V5: CV_V; 5
V33: CV_V; 3.3
VN: CV_V; -11
VP: CV_V; 11
VREFA: CV_V; 2.5
VREFD: CV_V; 2.5
VSYS: CV_V; 5.0714932127
Named nets: PD_RAW, AVDD5, 0, VDARK, TIA_OUT, PD_K, PHOTO_ADC, SK_A, SK_B, SK_OUT, REF_ADC, VDARK_DIV, MCU_3V3, P11, N11, V5SYS, REF_ADC_RAW, REF_DAC
01_TIA_curva_estatica
Desenho dos ensaios. Resultados originais: ngspice 47. LTspice nao executado neste ambiente.
Rotulos iguais unem redes. Fontes longas: botao direito / Ctrl+botao direito para ver Value completo.
TIA - corrente do fotodiodo para tensao
R500 // C500: realimentacao. VDARK fixa o potencial da entrada nao inversora.
Filtro Sallen-Key + RC de entrada do ADC
C504 liga SK_A a SK_OUT; C505 liga SK_B ao terra. O ADC nao esta modelado.
Referencia VDARK = cerca de 0,248 V
Divisor resistivo, capacitor de filtragem e buffer seguidor.
Fontes, comandos e modelos funcionais
Rotulos de mesmo nome sao a mesma conexao eletrica, inclusive entre paineis.
5
3.3
11
-11
5.0714932127
2.5
Fontes, comandos e modelos funcionais
Rotulos de mesmo nome sao a mesma conexao eletrica, inclusive entre paineis.
2.5
PWL: patamares / degraus
Resistores e capacitores auxiliares / desacoplamento
Rotulos de mesmo nome sao a mesma conexao eletrica, inclusive entre paineis.
Comandos SPICE e modelos - fazem parte da simulacao
.include "../modelos/OPA380_TI.lib"
.include "../modelos/OPAx197_TI.lib"
.include "../modelos/funcionais.lib"
.options reltol=1e-5 abstol=1e-12 vntol=1e-6 itl1=300 method=gear
.temp 27
.tran 100u 0.625 0 100u
