CarloRenan/CM5-RP2040-MZM/simulacoes/LTspice/02_TIA_bancada_17Hz.asc

C400: CV_CV; 1u
C401: CV_CV; 100n
C500: CV_CH; 100p
C501: CV_CV; 100n
C502: CV_CVL; 1u
C503: CV_CV; 100n
C504: CV_CH; 100n
C505: CV_CVL; 47n
C506: CV_CV; 100n
C507: CV_CV; 10n
R400: CV_RV; 1u
R500: CV_RH; 220k
R501: CV_RH; 90.9k
R502: CV_RV; 10.0k
R503: CV_RH; 10.0k
R504: CV_RH; 10.0k
R505: CV_RH; 100
R506: CV_RH; 10k
REXT: CV_RH; 100k
U500: CV_OPD; OPA380
U501: CV_OPF; OPAx197
U502: CV_OPF; OPAx197
V5: CV_V; 5
V33: CV_V; 3.3
VGER: CV_V; SINE(0 0.1 17)
VN: CV_V; -11
VP: CV_V; 11
VREFA: CV_V; 2.5
VREFD: CV_V; 2.5
VSYS: CV_V; 5.0714932127
Named nets: GER, PD_RAW, 0, AVDD5, VDARK, TIA_OUT, PD_K, PHOTO_ADC, SK_A, SK_B, SK_OUT, REF_ADC, VDARK_DIV, MCU_3V3, P11, N11, V5SYS, REF_ADC_RAW, REF_DAC
02_TIA_bancada_17Hz
Desenho dos ensaios. Resultados originais: ngspice 47. LTspice nao executado neste ambiente.
Rotulos iguais unem redes. Fontes longas: botao direito / Ctrl+botao direito para ver Value completo.
Entrada do ensaio de bancada - gerador e resistor externo
O gerador substitui o fotodiodo neste teste. REXT nao faz parte da BOM da placa.
SINE(0 0.1 17): 17 Hz, 200 mVpp, offset 0 V
PD_RAW segue para R506 (10k) e para o TIA.
TIA - corrente do fotodiodo para tensao
R500 // C500: realimentacao. VDARK fixa o potencial da entrada nao inversora.
Filtro Sallen-Key + RC de entrada do ADC
C504 liga SK_A a SK_OUT; C505 liga SK_B ao terra. O ADC nao esta modelado.
Referencia VDARK = cerca de 0,248 V
Divisor resistivo, capacitor de filtragem e buffer seguidor.
Fontes, comandos e modelos funcionais
Rotulos de mesmo nome sao a mesma conexao eletrica, inclusive entre paineis.
5
3.3
11
-11
5.0714932127
2.5
Fontes, comandos e modelos funcionais
Rotulos de mesmo nome sao a mesma conexao eletrica, inclusive entre paineis.
2.5
Resistores e capacitores auxiliares / desacoplamento
Rotulos de mesmo nome sao a mesma conexao eletrica, inclusive entre paineis.
Comandos SPICE e modelos - fazem parte da simulacao
.include "../modelos/OPA380_TI.lib"
.include "../modelos/OPAx197_TI.lib"
.include "../modelos/funcionais.lib"
.options reltol=1e-5 abstol=1e-12 vntol=1e-6 itl1=300 method=gear
.temp 27
.tran 100u 300m 0 100u
.meas tran MEDIA_TIA AVG V(TIA_OUT) FROM=0.1 TO=0.2764705882
.meas tran VPP_TIA PP V(TIA_OUT) FROM=0.1 TO=0.2764705882
.meas tran VPP_FILTRO PP V(PHOTO_ADC) FROM=0.1 TO=0.2764705882
