CarloRenan/CM5-RP2040-MZM/simulacoes/LTspice/04_BIAS_I_curva_estatica.asc

BK700NC: CV_B; V={3.3-V(ENABLE)}
C400: CV_CV; 1u
C401: CV_CV; 100n
C604: CV_CVL; 1u
C605: CV_CV; 100n
C700: CV_CV; 1u
C701: CV_CV; 100n
C702: CV_CV; 100n
C1110: CV_CV; 1n
R400: CV_RV; 1u
R602: CV_RH; 10.0k
R603: CV_RV; 10.0k
R700: CV_RH; 10.0k
R701: CV_RHR; 63.4k
R702: CV_RHB; 10.0k
R703: CV_RV; 63.4k
R704: CV_RH; 220
R705: CV_RV; 1k
R706: CV_RV; 1Meg
R1110: CV_RH; 80.6k
R1111: CV_RV; 20.0k
R1112: CV_RV; 26.7k
RLOAD_I: CV_RV; 10k
SK700NC: CV_SW; CONTATO
SK700NO: CV_SW; CONTATO
U601: CV_OPF; OPAx197
U700: CV_OPD; OPAx197
U1100: CV_OP; OPAx197
V5: CV_V; 5
V33: CV_V; 3.3
VDAC: CV_V; PWL(0 0 0.1 0 0.12499 0 0.125 0.05 0.14999 0.05 0.15 0.1 0.17499 0.1 0.175 0.15 0.19999 0.15 0.2 0.2 0.22499 0.2 0.225 0.25 0.24999 0.25 0.25 0.3 0.27499 0.3 0.275 0.35 0.29999 0.35 0.3 0.4 0.32499 0.4 0.325 0.45 0.34999 0.45 0.35 0.5 0.37499 0.5 0.375 0.55 0.39999 0.55 0.4 0.6 0.42499 0.6 0.425 0.65 0.44999 0.65 0.45 0.7 0.47499 0.7 0.475 0.75 0.49999 0.75 0.5 0.8 0.52499 0.8 0.525 0.85 0.54999 0.85 0.55 0.9 0.57499 0.9 0.575 0.95 0.59999 0.95 0.6 1 0.62499 1 0.625 1.05 0.64999 1.05 0.65 1.1 0.67499 1.1 0.675 1.15 0.69999 1.15 0.7 1.2 0.72499 1.2 0.725 1.25 0.74999 1.25 0.75 1.3 0.77499 1.3 0.775 1.35 0.79999 1.35 0.8 1.4 0.82499 1.4 0.825 1.45 0.84999 1.45 0.85 1.5 0.87499 1.5 0.875 1.55 0.89999 1.55 0.9 1.6 0.92499 1.6 0.925 1.65 0.94999 1.65 0.95 1.7 0.97499 1.7 0.975 1.75 0.99999 1.75 1 1.8 1.02499 1.8 1.025 1.85 1.04999 1.85 1.05 1.9 1.07499 1.9 1.075 1.95 1.09999 1.95 1.1 2 1.12499 2 1.125 2.05 1.14999 2.05 1.15 2.1 1.17499 2.1 1.175 2.15 1.19999 2.15 1.2 2.2 1.22499 2.2 1.225 2.25 1.24999 2.25 1.25 2.3 1.27499 2.3 1.275 2.35 1.29999 2.35 1.3 2.4 1.32499 2.4 1.325 2.45 1.34999 2.45 1.35 2.5 1.37499 2.5 1.375 2.5)
VEN: CV_V; 3.3
VN: CV_V; -11
VP: CV_V; 11
VREFA: CV_V; 2.5
VREFD: CV_V; 2.5
VSYS: CV_V; 5.0714932127
Named nets: VMID_DAC, DAC_I, 0, P11, N11, DRV_I, BIAS_F_I, INV_I, NONINV_I, BIAS_OUT_I, ENABLE, CTL_NC_I, SAFE_R_I, MON_I, REF_BUF, REF_DAC, AVDD5, MID_DIV, MCU_3V3, V5SYS, REF_ADC_RAW, REF_ADC
04_BIAS_I_curva_estatica
Desenho dos ensaios. Resultados originais: ngspice 47. LTspice nao executado neste ambiente.
Rotulos iguais unem redes. Fontes longas: botao direito / Ctrl+botao direito para ver Value completo.
BIAS I - amplificador diferencial e filtro RC
V(DRV) ~ 6,34 x [V(DAC) - V(VMID_DAC)]. Alimentacao nominal: +11 V e -11 V.
BIAS I - contatos de saida e carga de ensaio
NO conduz com ENABLE alto; NC conduz com ENABLE baixo. Contatos funcionais, sem rebote ou atraso mecanico.
Monitor de BIAS I
A rede mede BIAS_F antes do rele e soma uma parcela de REF_BUF. Nao mede diretamente BIAS_OUT.
Referencia VMID_DAC = 1,25 V
Divisor resistivo, capacitor de filtragem e buffer seguidor.
Fontes, comandos e modelos funcionais
Rotulos de mesmo nome sao a mesma conexao eletrica, inclusive entre paineis.
5
3.3
11
-11
5.0714932127
2.5
Fontes, comandos e modelos funcionais
Rotulos de mesmo nome sao a mesma conexao eletrica, inclusive entre paineis.
2.5
Funcao V={...}
PWL: patamares / degraus
3.3
Resistores e capacitores auxiliares / desacoplamento
Rotulos de mesmo nome sao a mesma conexao eletrica, inclusive entre paineis.
Comandos SPICE e modelos - fazem parte da simulacao
.include "../modelos/OPA380_TI.lib"
.include "../modelos/OPAx197_TI.lib"
.include "../modelos/funcionais.lib"
.options reltol=1e-5 abstol=1e-12 vntol=1e-6 itl1=300 method=gear
.temp 27
.tran 100u 1.375 0 100u
