CarloRenan/CM5-RP2040-MZM/simulacoes/LTspice/05_BIAS_tres_canais.asc

BK700NC: CV_B; V={3.3-V(ENABLE)}
BK800NC: CV_B; V={3.3-V(ENABLE)}
BK900NC: CV_B; V={3.3-V(ENABLE)}
C400: CV_CV; 1u
C401: CV_CV; 100n
C604: CV_CVL; 1u
C605: CV_CV; 100n
C700: CV_CV; 1u
C701: CV_CV; 100n
C702: CV_CV; 100n
C800: CV_CV; 1u
C801: CV_CV; 100n
C802: CV_CV; 100n
C900: CV_CV; 1u
C901: CV_CV; 100n
C902: CV_CV; 100n
C1110: CV_CV; 1n
C1111: CV_CV; 1n
C1112: CV_CV; 1n
R400: CV_RV; 1u
R602: CV_RH; 10.0k
R603: CV_RV; 10.0k
R700: CV_RH; 10.0k
R701: CV_RHR; 63.4k
R702: CV_RHB; 10.0k
R703: CV_RV; 63.4k
R704: CV_RH; 220
R705: CV_RV; 1k
R706: CV_RV; 1Meg
R800: CV_RH; 10.0k
R801: CV_RHR; 63.4k
R802: CV_RHB; 10.0k
R803: CV_RV; 63.4k
R804: CV_RH; 220
R805: CV_RV; 1k
R806: CV_RV; 1Meg
R900: CV_RH; 10.0k
R901: CV_RHR; 63.4k
R902: CV_RHB; 10.0k
R903: CV_RV; 63.4k
R904: CV_RH; 220
R905: CV_RV; 1k
R906: CV_RV; 1Meg
R1110: CV_RH; 80.6k
R1111: CV_RV; 20.0k
R1112: CV_RV; 26.7k
R1114: CV_RH; 80.6k
R1115: CV_RV; 20.0k
R1116: CV_RV; 26.7k
R1118: CV_RH; 80.6k
R1119: CV_RV; 20.0k
R1120: CV_RV; 26.7k
RLOAD_I: CV_RV; 10k
RLOAD_PHI: CV_RV; 10k
RLOAD_Q: CV_RV; 10k
SK700NC: CV_SW; CONTATO
SK700NO: CV_SW; CONTATO
SK800NC: CV_SW; CONTATO
SK800NO: CV_SW; CONTATO
SK900NC: CV_SW; CONTATO
SK900NO: CV_SW; CONTATO
U601: CV_OPF; OPAx197
U700: CV_OPD; OPAx197
U800: CV_OPD; OPAx197
U900: CV_OPD; OPAx197
U1100: CV_OP; OPAx197
V5: CV_V; 5
V33: CV_V; 3.3
VDAC_I: CV_V; SINE(0.855678233438 0.00315457413249 17)
VDAC_PHI: CV_V; SINE(1.64432176656 0.00315457413249 17)
VDAC_Q: CV_V; SINE(1.25 0.00315457413249 17)
VEN: CV_V; 3.3
VN: CV_V; -11
VP: CV_V; 11
VREFA: CV_V; 2.5
VREFD: CV_V; 2.5
VSYS: CV_V; 5.0714932127
Named nets: VMID_DAC, DAC_I, 0, P11, N11, DRV_I, BIAS_F_I, INV_I, NONINV_I, BIAS_OUT_I, ENABLE, CTL_NC_I, SAFE_R_I, DAC_Q, DRV_Q, BIAS_F_Q, INV_Q, NONINV_Q, BIAS_OUT_Q, CTL_NC_Q, SAFE_R_Q, DAC_PHI, DRV_PHI, BIAS_F_PHI, INV_PHI, NONINV_PHI, BIAS_OUT_PHI, CTL_NC_PHI, SAFE_R_PHI, MON_I, REF_BUF, MON_Q, MON_PHI, REF_DAC, AVDD5, MID_DIV, MCU_3V3, V5SYS, REF_ADC_RAW, REF_ADC
05_BIAS_tres_canais
Desenho dos ensaios. Resultados originais: ngspice 47. LTspice nao executado neste ambiente.
Rotulos iguais unem redes. Fontes longas: botao direito / Ctrl+botao direito para ver Value completo.
BIAS I - amplificador diferencial e filtro RC
V(DRV) ~ 6,34 x [V(DAC) - V(VMID_DAC)]. Alimentacao nominal: +11 V e -11 V.
BIAS I - contatos de saida e carga de ensaio
NO conduz com ENABLE alto; NC conduz com ENABLE baixo. Contatos funcionais, sem rebote ou atraso mecanico.
BIAS Q - amplificador diferencial e filtro RC
V(DRV) ~ 6,34 x [V(DAC) - V(VMID_DAC)]. Alimentacao nominal: +11 V e -11 V.
BIAS Q - contatos de saida e carga de ensaio
NO conduz com ENABLE alto; NC conduz com ENABLE baixo. Contatos funcionais, sem rebote ou atraso mecanico.
BIAS PHI - amplificador diferencial e filtro RC
V(DRV) ~ 6,34 x [V(DAC) - V(VMID_DAC)]. Alimentacao nominal: +11 V e -11 V.
BIAS PHI - contatos de saida e carga de ensaio
NO conduz com ENABLE alto; NC conduz com ENABLE baixo. Contatos funcionais, sem rebote ou atraso mecanico.
Monitor de BIAS I
A rede mede BIAS_F antes do rele e soma uma parcela de REF_BUF. Nao mede diretamente BIAS_OUT.
Monitor de BIAS Q
A rede mede BIAS_F antes do rele e soma uma parcela de REF_BUF. Nao mede diretamente BIAS_OUT.
Monitor de BIAS PHI
A rede mede BIAS_F antes do rele e soma uma parcela de REF_BUF. Nao mede diretamente BIAS_OUT.
Referencia VMID_DAC = 1,25 V
Divisor resistivo, capacitor de filtragem e buffer seguidor.
Fontes, comandos e modelos funcionais
Rotulos de mesmo nome sao a mesma conexao eletrica, inclusive entre paineis.
5
3.3
11
-11
5.0714932127
2.5
Fontes, comandos e modelos funcionais
Rotulos de mesmo nome sao a mesma conexao eletrica, inclusive entre paineis.
2.5
3.3
Funcao V={...}
SINE(0.855678233438 0.0031545741...
Funcao V={...}
Fontes, comandos e modelos funcionais
Rotulos de mesmo nome sao a mesma conexao eletrica, inclusive entre paineis.
SINE(1.25 0.00315457413249 17)
Funcao V={...}
SINE(1.64432176656 0.00315457413...
Resistores e capacitores auxiliares / desacoplamento
Rotulos de mesmo nome sao a mesma conexao eletrica, inclusive entre paineis.
Resistores e capacitores auxiliares / desacoplamento
Rotulos de mesmo nome sao a mesma conexao eletrica, inclusive entre paineis.
Comandos SPICE e modelos - fazem parte da simulacao
.include "../modelos/OPA380_TI.lib"
.include "../modelos/OPAx197_TI.lib"
.include "../modelos/funcionais.lib"
.options reltol=1e-5 abstol=1e-12 vntol=1e-6 itl1=300 method=gear
.temp 27
.tran 100u 300m 0 100u
