CarloRenan/CM5-RP2040-MZM/simulacoes/LTspice/08_Protecao_janela_DC.asc

C400: CV_CV; 1u
C401: CV_CV; 100n
C1100: CV_CV; 100n
C1110: CV_CV; 1n
C1111: CV_CV; 1n
C1112: CV_CV; 1n
E_REFBUF: CV_E; 1
R400: CV_RV; 1u
R1004: CV_RV; 10k
R1006: CV_RH; 56.0k
R1007: CV_RH; 10.0k
R1008: CV_RH; 113k
R1009: CV_RHR; 10.0k
R1100: CV_RH; 11.0k
R1101: CV_RH; 78.7k
R1102: CV_RH; 11.0k
R1103: CV_RH; 10.0k
R1104: CV_RH; 15.0k
R1110: CV_RH; 80.6k
R1111: CV_RV; 20.0k
R1112: CV_RV; 26.7k
R1114: CV_RH; 80.6k
R1115: CV_RV; 20.0k
R1116: CV_RV; 26.7k
R1118: CV_RH; 80.6k
R1119: CV_RV; 20.0k
R1120: CV_RV; 26.7k
U1101_1: CV_CMP; CMP_OC
U1101_2: CV_CMP; CMP_OC
U1101_3: CV_CMP; CMP_OC
U1101_4: CV_CMP; CMP_OC
U1102_1: CV_CMP; CMP_OC
U1102_2: CV_CMP; CMP_OC
U1102_3: CV_CMP; CMP_OC
U1102_4: CV_CMP; CMP_OC
V5: CV_V; 5
V33: CV_V; 3.3
VBI: CV_V; 0
VBP: CV_V; 0
VBQ: CV_V; 0
VN: CV_V; -11
VP: CV_V; 11
VREFA: CV_V; 2.5
VREFD: CV_V; 2.5
VSYS: CV_V; 5.0714932127
Named nets: BIAS_F_I, MON_I, REF_BUF, 0, BIAS_F_Q, MON_Q, BIAS_F_PHI, MON_PHI, VHI, VLO, VRAIL, P11, RAIL_POS, N11, RAIL_NEG, FAULT_N, MCU_3V3, AVDD5, V5SYS, REF_ADC_RAW, REF_DAC, REF_ADC
08_Protecao_janela_DC
Desenho dos ensaios. Resultados originais: ngspice 47. LTspice nao executado neste ambiente.
Rotulos iguais unem redes. Fontes longas: botao direito / Ctrl+botao direito para ver Value completo.
Monitor de BIAS I
A rede mede BIAS_F antes do rele e soma uma parcela de REF_BUF. Nao mede diretamente BIAS_OUT.
Monitor de BIAS Q
A rede mede BIAS_F antes do rele e soma uma parcela de REF_BUF. Nao mede diretamente BIAS_OUT.
Monitor de BIAS PHI
A rede mede BIAS_F antes do rele e soma uma parcela de REF_BUF. Nao mede diretamente BIAS_OUT.
Limiares da janela e da supervisao de alimentacao
REF_BUF = 2,5 V: VLO ~ 0,273 V; VHI ~ 2,227 V; VRAIL = 1,5 V.
Supervisao das alimentacoes +11 V / -11 V
RAIL_POS compara com VRAIL; RAIL_NEG recebe tambem a referencia positiva.
Comparadores com saida coletor aberto
Todos os OUT usam FAULT_N. R1004 puxa para 3,3 V; qualquer comparador pode levar FAULT_N a zero.
Fontes, comandos e modelos funcionais
Rotulos de mesmo nome sao a mesma conexao eletrica, inclusive entre paineis.
5
3.3
11
-11
5.0714932127
2.5
Fontes, comandos e modelos funcionais
Rotulos de mesmo nome sao a mesma conexao eletrica, inclusive entre paineis.
2.5
0
0
0
Resistores e capacitores auxiliares / desacoplamento
Rotulos de mesmo nome sao a mesma conexao eletrica, inclusive entre paineis.
Comandos SPICE e modelos - fazem parte da simulacao
.include "../modelos/OPA380_TI.lib"
.include "../modelos/OPAx197_TI.lib"
.include "../modelos/funcionais.lib"
.options reltol=1e-5 abstol=1e-12 vntol=1e-6 itl1=300 method=gear
.temp 27
.dc VBI -9 9 0.005
