CarloRenan/CM5-RP2040-MZM/simulacoes/LTspice/10_Watchdog_heartbeat.asc

BEN: CV_B; V={3.3*(1+tanh((V(WD_MCU)-2)/0.02))*(1+tanh((V(WD_CM5)-2)/0.02))*(1+tanh((V(FAULT_N)-2)/0.02))/8}
BK700NC: CV_B; V={3.3-V(ENABLE)}
C400: CV_CV; 1u
C401: CV_CV; 100n
C604: CV_CVL; 1u
C605: CV_CV; 100n
C700: CV_CV; 1u
C701: CV_CV; 100n
C702: CV_CV; 100n
C1110: CV_CV; 1n
R400: CV_RV; 1u
R602: CV_RH; 10.0k
R603: CV_RV; 10.0k
R700: CV_RH; 10.0k
R701: CV_RHR; 63.4k
R702: CV_RHB; 10.0k
R703: CV_RV; 63.4k
R704: CV_RH; 220
R705: CV_RV; 1k
R706: CV_RV; 1Meg
R1110: CV_RH; 80.6k
R1111: CV_RV; 20.0k
R1112: CV_RV; 26.7k
RLOAD_I: CV_RV; 10k
SK700NC: CV_SW; CONTATO
SK700NO: CV_SW; CONTATO
U601: CV_OPF; OPAx197
U700: CV_OPD; OPAx197
U1100: CV_OP; OPAx197
V5: CV_V; 5
V33: CV_V; 3.3
VARM: CV_V; PWL(0 0 50m 0 50.001m 3.3)
VDAC: CV_V; 0.855678233438
VFAULT: CV_V; 3.3
VHBC: CV_V; PWL(0 0 100m 0 100.001m 3.3 110m 3.3 110.001m 0 200m 0 200.001m 3.3 210m 3.3 210.001m 0 300m 0 300.001m 3.3 310m 3.3 310.001m 0 400m 0 400.001m 3.3 410m 3.3 410.001m 0 500m 0 500.001m 3.3)
VHBM: CV_V; PULSE(0 3.3 100m 1u 1u 10m 100m)
VN: CV_V; -11
VP: CV_V; 11
VREFA: CV_V; 2.5
VREFD: CV_V; 2.5
VSYS: CV_V; 5.0714932127
WD_CM5: CV_MONO; MONO_FUNC
WD_MCU: CV_MONO; MONO_FUNC
Named nets: VMID_DAC, DAC_I, 0, P11, N11, DRV_I, BIAS_F_I, INV_I, NONINV_I, BIAS_OUT_I, ENABLE, CTL_NC_I, SAFE_R_I, MON_I, REF_BUF, REF_DAC, AVDD5, MID_DIV, MCU_3V3, V5SYS, REF_ADC_RAW, REF_ADC, MCU_HEARTBEAT, CM5_HEARTBEAT, MCU_ARM, WD_MCU, WD_CM5, FAULT_N
10_Watchdog_heartbeat
Desenho dos ensaios. Resultados originais: ngspice 47. LTspice nao executado neste ambiente.
Rotulos iguais unem redes. Fontes longas: botao direito / Ctrl+botao direito para ver Value completo.
BIAS I - amplificador diferencial e filtro RC
V(DRV) ~ 6,34 x [V(DAC) - V(VMID_DAC)]. Alimentacao nominal: +11 V e -11 V.
BIAS I - contatos de saida e carga de ensaio
NO conduz com ENABLE alto; NC conduz com ENABLE baixo. Contatos funcionais, sem rebote ou atraso mecanico.
Monitor de BIAS I
A rede mede BIAS_F antes do rele e soma uma parcela de REF_BUF. Nao mede diretamente BIAS_OUT.
Referencia VMID_DAC = 1,25 V
Divisor resistivo, capacitor de filtragem e buffer seguidor.
Fontes, comandos e modelos funcionais
Rotulos de mesmo nome sao a mesma conexao eletrica, inclusive entre paineis.
5
3.3
11
-11
5.0714932127
2.5
Fontes, comandos e modelos funcionais
Rotulos de mesmo nome sao a mesma conexao eletrica, inclusive entre paineis.
2.5
Funcao V={...}
PULSE(0 3.3 100m 1u 1u 10m 100m)
PWL: patamares / degraus
PWL: patamares / degraus
Fontes, comandos e modelos funcionais
Rotulos de mesmo nome sao a mesma conexao eletrica, inclusive entre paineis.
3.3
Funcao V={...}
0.855678233438
Resistores e capacitores auxiliares / desacoplamento
Rotulos de mesmo nome sao a mesma conexao eletrica, inclusive entre paineis.
Comandos SPICE e modelos - fazem parte da simulacao
.include "../modelos/OPA380_TI.lib"
.include "../modelos/OPAx197_TI.lib"
.include "../modelos/funcionais.lib"
.options reltol=1e-5 abstol=1e-12 vntol=1e-6 itl1=300 method=gear
.temp 27
.tran 100u 1.2 0 100u
