CarloRenan/CM5-RP2040-MZM/simulacoes/LTspice/11_Referencias_degrau.asc

C400: CV_CV; 1u
C401: CV_CV; 100n
C502: CV_CVL; 1u
C503: CV_CV; 100n
C604: CV_CVL; 1u
C605: CV_CV; 100n
R400: CV_RV; 1u
R501: CV_RH; 90.9k
R502: CV_RV; 10.0k
R602: CV_RH; 10.0k
R603: CV_RV; 10.0k
U501: CV_OPF; OPAx197
U601: CV_OPF; OPAx197
V5: CV_V; 5
V33: CV_V; 3.3
VN: CV_V; -11
VP: CV_V; 11
VREFA: CV_V; PWL(0 2.5 10m 2.5 10.01m 2.4 40m 2.4 40.01m 2.5)
VREFD: CV_V; PWL(0 2.5 10m 2.5 10.01m 2.4 40m 2.4 40.01m 2.5)
VSYS: CV_V; 5.0714932127
Named nets: REF_ADC, 0, AVDD5, VDARK, VDARK_DIV, REF_DAC, VMID_DAC, MID_DIV, MCU_3V3, P11, N11, V5SYS, REF_ADC_RAW
11_Referencias_degrau
Desenho dos ensaios. Resultados originais: ngspice 47. LTspice nao executado neste ambiente.
Rotulos iguais unem redes. Fontes longas: botao direito / Ctrl+botao direito para ver Value completo.
Referencia VDARK = cerca de 0,248 V
Divisor resistivo, capacitor de filtragem e buffer seguidor.
Referencia VMID_DAC = 1,25 V
Divisor resistivo, capacitor de filtragem e buffer seguidor.
Fontes, comandos e modelos funcionais
Rotulos de mesmo nome sao a mesma conexao eletrica, inclusive entre paineis.
5
3.3
11
-11
5.0714932127
PWL: patamares / degraus
Fontes, comandos e modelos funcionais
Rotulos de mesmo nome sao a mesma conexao eletrica, inclusive entre paineis.
PWL: patamares / degraus
Resistores e capacitores auxiliares / desacoplamento
Rotulos de mesmo nome sao a mesma conexao eletrica, inclusive entre paineis.
Comandos SPICE e modelos - fazem parte da simulacao
.include "../modelos/OPA380_TI.lib"
.include "../modelos/OPAx197_TI.lib"
.include "../modelos/funcionais.lib"
.options reltol=1e-5 abstol=1e-12 vntol=1e-6 itl1=300 method=gear
.temp 27
.tran 20u 70m 0 20u
