CarloRenan/CM5-RP2040-MZM/simulacoes/LTspice/12_Alimentacoes_modelo_funcional.asc

B317: CV_B; V={min(max(V(VIN_P)-2,0),max(1.25+V(ADJ_POS),0))}
B337: CV_B; V={max(min(V(VIN_N)+2,0),min(V(ADJ_NEG)-1.25,0))}
B1763: CV_B; V={min(max(V(P11)-0.3,0),5)}
BNEG: CV_B; V={-15*min(max(V(VIN_P)/9,0),1)}
C210: CV_CV; 10u
C211: CV_CV; 10u
C212: CV_CV; 10u
C213: CV_CV; 10u
C214: CV_CV; 10u
C215: CV_CV; 10u
IL5: CV_I; 30m
ILNEG: CV_I; 20m
ILPOS: CV_I; 20m
R210: CV_RV; 120
R211: CV_RV; 931
R212: CV_RV; 120
R213: CV_RV; 931
R317: CV_RV; 0.05
R337: CV_RV; 0.05
R1763: CV_RV; 0.05
RNEG: CV_RV; 0.5
RPATH: CV_RV; 0.1
VEXT: CV_V; 15
Named nets: EXT_P15, 0, INT_N15, POS_INT, NEG_INT, LDO_INT, P11, N11, AVDD5, VIN_P, VIN_N, ADJ_POS, ADJ_NEG
12_Alimentacoes_modelo_funcional
Desenho dos ensaios. Resultados originais: ngspice 47. LTspice nao executado neste ambiente.
Rotulos iguais unem redes. Fontes longas: botao direito / Ctrl+botao direito para ver Value completo.
Fontes, comandos e modelos funcionais
Rotulos de mesmo nome sao a mesma conexao eletrica, inclusive entre paineis.
15
Funcao V={...}
Funcao V={...}
Funcao V={...}
Funcao V={...}
20m
Fontes, comandos e modelos funcionais
Rotulos de mesmo nome sao a mesma conexao eletrica, inclusive entre paineis.
20m
30m
Resistores e capacitores auxiliares / desacoplamento
Rotulos de mesmo nome sao a mesma conexao eletrica, inclusive entre paineis.
Resistores e capacitores auxiliares / desacoplamento
Rotulos de mesmo nome sao a mesma conexao eletrica, inclusive entre paineis.
Resistores e capacitores auxiliares / desacoplamento
Rotulos de mesmo nome sao a mesma conexao eletrica, inclusive entre paineis.
Comandos SPICE e modelos - fazem parte da simulacao
.include "../modelos/OPA380_TI.lib"
.include "../modelos/OPAx197_TI.lib"
.include "../modelos/funcionais.lib"
.options reltol=1e-5 abstol=1e-12 vntol=1e-6 itl1=300 method=gear
.temp 27
.dc VEXT 12 18 0.05
