CarloRenan/CM5-RP2040-MZM/simulacoes/LTspice/13_Buck_PWM_potencia.asc

BLOW: CV_B; V={1-V(PWM)}
C205: CV_CV; 22u; IC=5.071493
C206: CV_CV; 22u; IC=5.071493
C207: CV_CV; 22u; IC=5.071493
ILOAD: CV_I; PWL(0 1 1m 1 1.001m 2)
L200: CV_LH; 3.3u; IC=1
R202: CV_RV; 118k
R203: CV_RV; 22.1k
RESR: CV_RV; 0.01
RL_DCR: CV_RH; 0.015
SHS: CV_SW; HS
SLS: CV_SW; LS
VEXT: CV_V; 15
VPWM: CV_V; PULSE(0 1 0 2n 2n {D/FSW} {1/FSW})
Named nets: VIN_P, BUCK_SW, 0, PWM, PWM_N, L_OUT, V5SYS, COUT, BUCK_FB
13_Buck_PWM_potencia
Desenho dos ensaios. Resultados originais: ngspice 47. LTspice nao executado neste ambiente.
Rotulos iguais unem redes. Fontes longas: botao direito / Ctrl+botao direito para ver Value completo.
Buck - chaves, indutor, capacitores e carga
PWM fixo; RL_DCR / RESR assumidos. Condicoes iniciais: IL = 1 A; VC = 5,071493 V. Nao e o AP64501 completo.
1 A -> 2 A
Fontes, comandos e modelos funcionais
Rotulos de mesmo nome sao a mesma conexao eletrica, inclusive entre paineis.
15
PULSE(0 1 0 2n 2n {D/FSW} {1/FSW})
Funcao V={...}
Comandos SPICE e modelos - fazem parte da simulacao
.include "../modelos/OPA380_TI.lib"
.include "../modelos/OPAx197_TI.lib"
.include "../modelos/funcionais.lib"
.options reltol=1e-5 abstol=1e-12 vntol=1e-6 itl1=300 method=gear
.temp 27
.param FSW=570k D=0.8*(1+118k/22.1k)/15
.model HS SW(Ron=0.045 Roff=1e9 Vt=0.5 Vh=0)
.model LS SW(Ron=0.020 Roff=1e9 Vt=0.5 Vh=0)
.tran 20n 2m 0 20n uic
