CarloRenan/CM5-RP2040-MZM/simulacoes/LTspice/14_MZM_malha_aberta.asc

BK700NC: CV_B; V={3.3-V(ENABLE)}
BOPT: CV_B; V={PIN_OPT*0.5*(1+cos(3.141592653589793*V(BIAS_OUT_I)/VPI+PHI0))}
BPD: CV_BI; I={RESPONS*TAP*V(POTENCIA_OPTICA)}
C400: CV_CV; 1u
C401: CV_CV; 100n
C500: CV_CH; 100p
C501: CV_CV; 100n
C502: CV_CVL; 1u
C503: CV_CV; 100n
C504: CV_CH; 100n
C505: CV_CVL; 47n
C506: CV_CV; 100n
C507: CV_CV; 10n
C604: CV_CVL; 1u
C605: CV_CV; 100n
C700: CV_CV; 1u
C701: CV_CV; 100n
C702: CV_CV; 100n
C1110: CV_CV; 1n
R400: CV_RV; 1u
R500: CV_RH; 220k
R501: CV_RH; 90.9k
R502: CV_RV; 10.0k
R503: CV_RH; 10.0k
R504: CV_RH; 10.0k
R505: CV_RH; 100
R506: CV_RH; 10k
R602: CV_RH; 10.0k
R603: CV_RV; 10.0k
R700: CV_RH; 10.0k
R701: CV_RHR; 63.4k
R702: CV_RHB; 10.0k
R703: CV_RV; 63.4k
R704: CV_RH; 220
R705: CV_RV; 1k
R706: CV_RV; 1Meg
R1110: CV_RH; 80.6k
R1111: CV_RV; 20.0k
R1112: CV_RV; 26.7k
RLOAD_I: CV_RV; 1e12
SK700NC: CV_SW; CONTATO
SK700NO: CV_SW; CONTATO
U500: CV_OPD; OP_FUNC
U501: CV_OPF; OP_FUNC
U502: CV_OPF; OP_FUNC
U601: CV_OPF; OP_FUNC
U700: CV_OPD; OP_FUNC
U1100: CV_OP; OP_FUNC
V5: CV_V; 5
V33: CV_V; 3.3
VDAC: CV_V; PWL(0 0.5 0.1 0.5 0.12499 0.5 0.125 0.525 0.14999 0.525 0.15 0.55 0.17499 0.55 0.175 0.575 0.19999 0.575 0.2 0.6 0.22499 0.6 0.225 0.625 0.24999 0.625 0.25 0.65 0.27499 0.65 0.275 0.675 0.29999 0.675 0.3 0.7 0.32499 0.7 0.325 0.725 0.34999 0.725 0.35 0.75 0.37499 0.75 0.375 0.775 0.39999 0.775 0.4 0.8 0.42499 0.8 0.425 0.825 0.44999 0.825 0.45 0.85 0.47499 0.85 0.475 0.875 0.49999 0.875 0.5 0.9 0.52499 0.9 0.525 0.925 0.54999 0.925 0.55 0.95 0.57499 0.95 0.575 0.975 0.59999 0.975 0.6 1 0.62499 1 0.625 1.025 0.64999 1.025 0.65 1.05 0.67499 1.05 0.675 1.075 0.69999 1.075 0.7 1.1 0.72499 1.1 0.725 1.125 0.74999 1.125 0.75 1.15 0.77499 1.15 0.775 1.175 0.79999 1.175 0.8 1.2 0.82499 1.2 0.825 1.225 0.84999 1.225 0.85 1.25 0.87499 1.25 0.875 1.275 0.89999 1.275 0.9 1.3 0.92499 1.3 0.925 1.325 0.94999 1.325 0.95 1.35 0.97499 1.35 0.975 1.375 0.99999 1.375 1 1.4 1.02499 1.4 1.025 1.425 1.04999 1.425 1.05 1.45 1.07499 1.45 1.075 1.475 1.09999 1.475 1.1 1.5 1.12499 1.5 1.125 1.525 1.14999 1.525 1.15 1.55 1.17499 1.55 1.175 1.575 1.19999 1.575 1.2 1.6 1.22499 1.6 1.225 1.625 1.24999 1.625 1.25 1.65 1.27499 1.65 1.275 1.675 1.29999 1.675 1.3 1.7 1.32499 1.7 1.325 1.725 1.34999 1.725 1.35 1.75 1.37499 1.75 1.375 1.775 1.39999 1.775 1.4 1.8 1.42499 1.8 1.425 1.825 1.44999 1.825 1.45 1.85 1.47499 1.85 1.475 1.875 1.49999 1.875 1.5 1.9 1.52499 1.9 1.525 1.925 1.54999 1.925 1.55 1.95 1.57499 1.95 1.575 1.975 1.59999 1.975 1.6 2 1.62499 2 1.625 2)
VEN: CV_V; 3.3
VN: CV_V; -11
VP: CV_V; 11
VREFA: CV_V; 2.5
VREFD: CV_V; 2.5
VSYS: CV_V; 5.0714932127
Named nets: PD_RAW, AVDD5, 0, VDARK, TIA_OUT, PD_K, PHOTO_ADC, SK_A, SK_B, SK_OUT, POTENCIA_OPTICA, VMID_DAC, DAC_I, P11, N11, DRV_I, BIAS_F_I, INV_I, NONINV_I, BIAS_OUT_I, ENABLE, CTL_NC_I, SAFE_R_I, MON_I, REF_BUF, REF_ADC, VDARK_DIV, REF_DAC, MID_DIV, MCU_3V3, V5SYS, REF_ADC_RAW
14_MZM_malha_aberta
Desenho dos ensaios. Resultados originais: ngspice 47. LTspice nao executado neste ambiente.
Rotulos iguais unem redes. Fontes longas: botao direito / Ctrl+botao direito para ver Value completo.
TIA - corrente do fotodiodo para tensao
R500 // C500: realimentacao. VDARK fixa o potencial da entrada nao inversora.
Filtro Sallen-Key + RC de entrada do ADC
C504 liga SK_A a SK_OUT; C505 liga SK_B ao terra. O ADC nao esta modelado.
MZM hipotetico - potencia optica e fotocorrente
Fontes comportamentais. V(POTENCIA_OPTICA) e uma variavel numerica em W, nao uma tensao fisica.
Pout = Pin/2 x [1 + cos(pi x Vbias/Vpi + phi0)]
Ipd = RESPONS x TAP x Pout
Pin = 1 mW; Vpi = 4 V; phi0 = 0
RESPONS = 0,8 A/W; TAP = 1%
BIAS I - amplificador diferencial e filtro RC
V(DRV) ~ 6,34 x [V(DAC) - V(VMID_DAC)]. Alimentacao nominal: +11 V e -11 V.
BIAS I - contatos de saida e carga de ensaio
NO conduz com ENABLE alto; NC conduz com ENABLE baixo. Contatos funcionais, sem rebote ou atraso mecanico.
Monitor de BIAS I
A rede mede BIAS_F antes do rele e soma uma parcela de REF_BUF. Nao mede diretamente BIAS_OUT.
Referencia VDARK = cerca de 0,248 V
Divisor resistivo, capacitor de filtragem e buffer seguidor.
Referencia VMID_DAC = 1,25 V
Divisor resistivo, capacitor de filtragem e buffer seguidor.
Fontes, comandos e modelos funcionais
Rotulos de mesmo nome sao a mesma conexao eletrica, inclusive entre paineis.
5
3.3
11
-11
5.0714932127
2.5
Fontes, comandos e modelos funcionais
Rotulos de mesmo nome sao a mesma conexao eletrica, inclusive entre paineis.
2.5
Funcao V={...}
3.3
PWL: patamares / degraus
Resistores e capacitores auxiliares / desacoplamento
Rotulos de mesmo nome sao a mesma conexao eletrica, inclusive entre paineis.
Resistores e capacitores auxiliares / desacoplamento
Rotulos de mesmo nome sao a mesma conexao eletrica, inclusive entre paineis.
Comandos SPICE e modelos - fazem parte da simulacao
.include "../modelos/OPA380_TI.lib"
.include "../modelos/OPAx197_TI.lib"
.include "../modelos/funcionais.lib"
.options reltol=1e-5 abstol=1e-12 vntol=1e-6 itl1=300 method=gear
.temp 27
.subckt OP_FUNC P M VP VN OUT
EGAIN OUT 0 P M 1e6
.ends OP_FUNC
.param VPI=4 PIN_OPT=1m TAP=0.01 RESPONS=0.8 PHI0=0
.tran 100u 1.625 0 100u
