CarloRenan/CM5-RP2040-MZM/(list of files, drawings)

Other design files:
hardware/altium/ADC.SchDoc
hardware/altium/Bias_I.SchDoc
hardware/altium/Bias_PHI.SchDoc
hardware/altium/Bias_Q.SchDoc
hardware/altium/CM5_Boot_USB.SchDoc
hardware/altium/CM5_GPIO.SchDoc
hardware/altium/CM5_HighSpeed.SchDoc
hardware/altium/CM5_Projeto3_R6.PrjPcb
hardware/altium/CM5_Projeto_R6.PcbLib
hardware/altium/CM5_R6_Serigrafia_VIRTUS.PcbDoc
hardware/altium/DAC_Reference.SchDoc
hardware/altium/MCU_RP2040.SchDoc
hardware/altium/Notes.SchDoc
hardware/altium/Power_Analog.SchDoc
hardware/altium/Power_Input_5V.SchDoc
hardware/altium/Power_Neg15.SchDoc
hardware/altium/Safety_Watchdog.SchDoc
hardware/altium/Safety_Window.SchDoc
hardware/altium/TIA.SchDoc
hardware/altium/Top_Level.SchDoc
