CarloRenan/CM5-RP2040-MZM/(commit log)

2026-10-18 Organiza a revisão R6, documentação e quatorze circuitos de simulação
    [BOM_PCB_R6.csv, BOM_Sistema_R6.csv, CM5_Projeto3_R6.PrjPcb, Conectividade_pinos_R6.csv, Posicionamento_R6.csv]
2026-10-18 Adiciona esquemáticos, layout e biblioteca Altium da revisão R6
    [ADC.SchDoc, Bias_I.SchDoc, Bias_PHI.SchDoc, Bias_Q.SchDoc, CM5_Boot_USB.SchDoc, CM5_GPIO.SchDoc, CM5_HighSpeed.SchDoc, CM5_Projeto3_R6.PcbDoc]
2026-10-18 Inclui os modelos 3D dos componentes
    [AP64501_SO8EP.step, C0805.step, C1206.step, C1210.step, CM5_BERG100.step, CM5_Envelope.step, DAC80504_RTE.step, D_DO41_P10.step]
2026-10-18 Inclui os modelos de montagem do Pico
    [Pico_TH40_headers_R4.step, Pico_W_SC0918_usuario.step]
2026-10-18 Preserva os modelos auxiliares usados no projeto
    [Conector_5444262.step, Conector_5447861.step, TMR3_SIP8_envelope.step]
2026-10-18 Inclui o modelo tridimensional de referência do CM5
    [CM5R5-3dsteps.step]
2026-10-18 Atualiza o manifesto de integridade da entrega R6
2026-10-23 Rename Lista_Compras_Prototipo_CM5_RP2040 (1).xlsx to Lista_Compras_Prototipo_CM5_RP2040 .xlsx
    [Lista_Compras_Prototipo_CM5_RP2040 .xlsx]
2026-10-26 docs: atualiza README da R6 com conexões e configuração do ADC
