CarloRenan/CM5-RP2040-MZM/(notices)

Notices in the files:
hardware/altium/ALTIUM_EMBEDDED_MODELS/C1206.step:
Copyright (C) 2017, kicad StepUp
This work is licensed under the [Creative Commons CC-BY-SA 4.0 License](https://creativecommons.org/licenses/by-sa/4.0/legalcode),
with the following exception:
To the extent that the creation of electronic designs that use 'Licensed Material' can be considered to be 'Adapted Material',
You are free to use the library data in your own projects without the obligation to share your project files under this or any other license agreement.
hardware/altium/ALTIUM_EMBEDDED_MODELS/D_SMA.step:
This program is free software: you can redistribute it and/or modify
it under the terms of the GNU General Public License as published by
the Free Software Foundation, either version 3 of the License, or
any later version.
itself might be covered by the GNU General Public License.
hardware/altium/ALTIUM_EMBEDDED_MODELS/R0603.step:
Copyright (C) 2018, kicad StepUp
hardware/altium/ALTIUM_EMBEDDED_MODELS/MKDS_3_P508.step:
Copyright (C) 2020, kicad StepUp
